ayemi-dev/pcb-ayemi/placas/enlace-esp32s3/reportes/colocacion.md

# Colocación

Generado por `tools/colocar.py` desde `spec/pcb.yaml`. No lo edites a mano.

Las piezas que más se movieron desde su posición aproximada (mm): R320 1.1, Q303 0.8, D201 0.7, C1 0.3, SW1 0.3, C201 0.3, SW2 0.2, R313 0.2.

## Choques de cortesía

Ninguno.

## Piezas fuera de la placa

Ninguna.

Conectores de borde cuya cortesía asoma (tolerado, máximo 0.6 mm): J101 0.49 mm, J401 0.15 mm, J402 0.15 mm, J403 0.15 mm, J404 0.15 mm, J405 0.15 mm, U1 0.05 mm.

## Reglas `cerca_de`

| Pieza | Pin | Distancia (mm) | Máximo (mm) | Resultado |
|---|---|---|---|---|
| C1 | U1.2 | 4.1 | 8 | ok |
| C2 | U1.2 | 6.0 | 8 | ok |
| C3 | U1.2 | 6.6 | 10 | ok |
| U102 | J101.A6 | 4.8 | 10 | ok |

## Zona de manos y USB-C

| Pieza | Distancia al centro del USB-C (mm) |
|---|---|
| SW301 | 45.2  |
| SW302 | 53.1  |
| RV301 | 58.5  |
| SW303 | 52.6  |

## Ocupación (suma de áreas de cortesía)

- Placa: 53 % de 5144 mm² útiles.
- Zona de manos (x [44, 84], y [10, 56]): 50 % de 1840 mm².
