ayemi-dev/pcb-ayemi/placas/enlace-esp32s3/reportes/erc.md

# Resultado del ERC

Generado por `tools/erc.py` con kicad-cli 10.0.6. No lo edites a mano.

| Concepto | Cantidad |
|---|---|
| Errores | 0 |
| Advertencias | 0 |
| Advertencias justificadas | 0 |
| Advertencias sin justificar | 0 |
| Excluidas en KiCad | 0 |

**Veredicto:** ERC en 0 errores y todas las advertencias justificadas.
