ayemi-dev/pcb-ayemi/placas/enlace-esp32s3/reportes/ruteo.md

# Ruteo

Generado por `tools/rutear.py` desde `spec/pcb.yaml`. No lo edites a mano.

- Pistas: 1166 tramos, 2785 mm en total. Vías: 216.
- Redes ruteadas en ventana fina (fijas): CC1, CC2, GND, USB_DM, USB_DP, VBUS.
- Redes con conexiones sin rutear: 0.
- Pasada elegida: 1. Tiempo: 0 s.
- Pads de GND sin vía al plano: ninguno.

## Por red

| Red | Clase | Ancho (mm) | Largo (mm) | Vías |
|---|---|---|---|---|
| +3V3 | Potencia | 0.25/0.50 | 229.2 | 5 |
| +5V | Potencia | 0.25/0.50 | 127.2 | 7 |
| BTN_A | Default | 0.25 | 34.9 | 6 |
| BTN_A_S | Default | 0.25 | 6.0 | 0 |
| BTN_B | Default | 0.25 | 32.5 | 4 |
| BTN_B_S | Default | 0.25 | 5.9 | 0 |
| BZ_C | Default | 0.25 | 50.5 | 3 |
| BZ_IN | Default | 0.25 | 6.3 | 2 |
| BZ_P | Default | 0.25 | 34.1 | 4 |
| BZ_S1 | Default | 0.25 | 6.2 | 2 |
| BZ_S2 | Default | 0.25 | 5.9 | 0 |
| BZ_S3 | Default | 0.25 | 5.9 | 0 |
| CC1 | Default | 0.20 | 7.4 | 2 |
| CC2 | Default | 0.20 | 7.3 | 2 |
| EN | Default | 0.25 | 59.0 | 5 |
| GND | Potencia | 0.20/0.25 | 114.1 | 54 |
| IO0 | Default | 0.25 | 11.6 | 2 |
| IO1 | Default | 0.25 | 81.7 | 8 |
| IO10 | Default | 0.25 | 84.3 | 2 |
| IO11 | Default | 0.25 | 82.3 | 2 |
| IO12 | Default | 0.25 | 84.3 | 4 |
| IO13 | Default | 0.25 | 88.3 | 4 |
| IO14 | Default | 0.25 | 93.1 | 2 |
| IO15 | Default | 0.25 | 70.5 | 3 |
| IO16 | Default | 0.25 | 69.2 | 2 |
| IO17 | Default | 0.25 | 66.8 | 2 |
| IO18 | Default | 0.25 | 96.0 | 8 |
| IO2 | Default | 0.25 | 90.9 | 2 |
| IO21 | Default | 0.25 | 41.2 | 2 |
| IO38 | Default | 0.25 | 39.1 | 2 |
| IO39 | Default | 0.25 | 36.2 | 2 |
| IO4 | Default | 0.25 | 61.5 | 2 |
| IO40 | Default | 0.25 | 35.8 | 2 |
| IO41 | Default | 0.25 | 34.7 | 2 |
| IO42 | Default | 0.25 | 35.7 | 2 |
| IO43 | Default | 0.25 | 51.4 | 2 |
| IO44 | Default | 0.25 | 48.6 | 2 |
| IO47 | Default | 0.25 | 33.9 | 1 |
| IO48 | Default | 0.25 | 32.3 | 1 |
| IO5 | Default | 0.25 | 47.2 | 4 |
| IO6 | Default | 0.25 | 56.6 | 6 |
| IO7 | Default | 0.25 | 49.4 | 6 |
| IO8 | Default | 0.25 | 64.2 | 5 |
| IO9 | Default | 0.25 | 50.5 | 5 |
| LED_G | Default | 0.25 | 42.2 | 2 |
| LED_G_A | Default | 0.25 | 4.1 | 0 |
| LED_R | Default | 0.25 | 50.0 | 6 |
| LED_R_A | Default | 0.25 | 4.1 | 0 |
| LED_Y | Default | 0.25 | 37.7 | 2 |
| LED_Y_A | Default | 0.25 | 4.1 | 0 |
| POT_W | Default | 0.25 | 2.5 | 0 |
| PWR_A | Default | 0.25 | 5.0 | 2 |
| Q_B | Default | 0.25 | 24.4 | 2 |
| RGB_B | Default | 0.25 | 40.5 | 5 |
| RGB_B_D | Default | 0.25 | 3.6 | 0 |
| RGB_B_K | Default | 0.25 | 3.8 | 2 |
| RGB_G | Default | 0.25 | 30.0 | 2 |
| RGB_G_D | Default | 0.25 | 3.6 | 0 |
| RGB_G_K | Default | 0.25 | 5.5 | 0 |
| RGB_R | Default | 0.25 | 31.0 | 2 |
| RGB_R_D | Default | 0.25 | 2.8 | 0 |
| RGB_R_K | Default | 0.25 | 6.1 | 0 |
| USB_DM | USB | 0.20 | 42.8 | 2 |
| USB_DP | USB | 0.20 | 46.0 | 2 |
| VBUS | Potencia | 0.40 | 24.9 | 4 |
