ayemi-dev/pcb-ayemi/placas/entrenamiento-328p/reportes/colocacion.md

# Colocación

Generado por `tools/colocar.py` desde `spec/pcb.yaml`. No lo edites a mano.

Las piezas que más se movieron desde su posición aproximada (mm): D201 0.3, Q302 0.1, U1 0.0, Y1 0.0, C1 0.0, C2 0.0, C3 0.0, C4 0.0.

## Choques de cortesía

Ninguno.

## Piezas fuera de la placa

Ninguna.

Conectores de borde cuya cortesía asoma (tolerado, máximo 0.6 mm): J101 0.49 mm, J401 0.15 mm, J402 0.15 mm, J403 0.15 mm, J404 0.15 mm, J405 0.15 mm.

## Reglas `cerca_de`

| Pieza | Pin | Distancia (mm) | Máximo (mm) | Resultado |
|---|---|---|---|---|
| C1 | U1.7 | 6.9 | 8 | ok |
| C101 | U101.16 | 3.3 | 4 | ok |
| C102 | U101.4 | 3.0 | 4 | ok |
| C2 | U1.8 | 6.4 | 8 | ok |
| C3 | U1.4 | 3.8 | 4 | ok |
| C4 | U1.6 | 3.9 | 4 | ok |
| C5 | U1.18 | 3.0 | 4 | ok |
| C6 | U1.20 | 2.9 | 4 | ok |
| U102 | J101.A6 | 4.8 | 10 | ok |
| Y1 | U1.7 | 7.4 | 8 | ok |

## Zona de manos y USB-C

| Pieza | Distancia al centro del USB-C (mm) |
|---|---|
| SW301 | 42.9  |
| SW302 | 51.8  |
| RV301 | 62.2  |
| SW303 | 52.2  |

## Ocupación (suma de áreas de cortesía)

- Placa: 46 % de 5144 mm² útiles.
- Zona de manos (x [40, 80], y [10, 56]): 43 % de 1840 mm².
