ayemi-dev/pcb-ayemi/placas/entrenamiento-328p/reportes/costura.md

# Costura de GND

Generado por `tools/costura.py` desde `spec/pcb.yaml`. No lo edites a mano.

- Puntos propuestos: 312 (rejilla de 5 mm y borde cada 3 mm).
- Vías de costura puestas: 236 (diámetro 0.6 mm, taladro 0.3 mm).
- Puntos sin sitio libre a 1.5 mm: 76.
- Zonas donde el DRC encontró vías sueltas (no se cose en 2.5 mm a la redonda): 8.

- (2.5, 2.5)
- (2.5, 27.5)
- (2.5, 32.5)
- (2.5, 37.5)
- (2.5, 42.5)
- (2.5, 47.5)
- (2.5, 57.5)
- (7.5, 22.5)
- (7.5, 37.5)
- (12.5, 37.5)
- (12.5, 42.5)
- (12.5, 52.5)
- (17.5, 7.5)
- (17.5, 27.5)
- (17.5, 32.5)
- (17.5, 37.5)
- (17.5, 42.5)
- (17.5, 52.5)
- (22.5, 37.5)
- (22.5, 42.5)
- (27.5, 27.5)
- (27.5, 32.5)
- (27.5, 57.5)
- (32.5, 7.5)
- (32.5, 27.5)
- (32.5, 37.5)
- (32.5, 47.5)
- (37.5, 22.5)
- (37.5, 47.5)
- (42.5, 7.5)
- (42.5, 32.5)
- (42.5, 42.5)
- (47.5, 7.5)
- (47.5, 17.5)
- (47.5, 37.5)
- (47.5, 42.5)
- (52.5, 42.5)
- (52.5, 52.5)
- (57.5, 7.5)
- (57.5, 42.5)
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
