ayemi-dev/pcb-ayemi/placas/entrenamiento-328p/reportes/ruteo.md

# Ruteo

Generado por `tools/rutear.py` desde `spec/pcb.yaml`. No lo edites a mano.

- Pistas: 1262 tramos, 2986 mm en total. Vías: 200.
- Redes ruteadas en ventana fina (fijas): CC1, CC2, GND, USB_DM, USB_DP, VBUS.
- Redes con conexiones sin rutear: 0.
- Pasada elegida: 1. Tiempo: 0 s.
- Pads de GND sin vía al plano: ninguno.

## Anchos distintos del de su clase

- +5V: tramo hacia J1.2 con ancho 0.20 mm (clase Fino) en lugar de 0.25 mm

## Por red

| Red | Clase | Ancho (mm) | Largo (mm) | Vías |
|---|---|---|---|---|
| +3V3 | Potencia | 0.25/0.50 | 63.3 | 5 |
| +5V | Potencia | 0.25/0.50 | 348.2 | 19 |
| A0 | Default | 0.25 | 59.6 | 3 |
| A1 | Default | 0.25 | 59.7 | 3 |
| A2 | Default | 0.25 | 66.9 | 2 |
| A3 | Default | 0.25 | 69.9 | 2 |
| A4 | Default | 0.25 | 105.9 | 6 |
| A5 | Default | 0.25 | 99.8 | 3 |
| A6 | Default | 0.25 | 51.2 | 2 |
| A7 | Default | 0.25 | 75.4 | 6 |
| AREF | Default | 0.25 | 4.1 | 0 |
| BTN_A | Default | 0.25 | 14.9 | 2 |
| BTN_A_S | Default | 0.25 | 6.7 | 0 |
| BTN_B | Default | 0.25 | 13.9 | 2 |
| BTN_B_S | Default | 0.25 | 6.1 | 0 |
| BZ_C | Default | 0.25 | 47.0 | 4 |
| BZ_IN | Default | 0.25 | 12.0 | 2 |
| BZ_P | Default | 0.25 | 53.3 | 6 |
| BZ_S1 | Default | 0.25 | 6.2 | 2 |
| BZ_S2 | Default | 0.25 | 6.6 | 0 |
| BZ_S3 | Default | 0.25 | 7.3 | 0 |
| CC1 | Default | 0.20 | 9.3 | 2 |
| CC2 | Default | 0.20 | 9.1 | 2 |
| CH_RXD | Default | 0.25 | 11.3 | 2 |
| CH_TXD | Default | 0.25 | 16.2 | 2 |
| D0 | Default | 0.25 | 75.8 | 0 |
| D1 | Default | 0.25 | 82.8 | 4 |
| D10 | Default | 0.25 | 62.6 | 1 |
| D11 | Default | 0.25 | 65.2 | 1 |
| D12 | Default | 0.25 | 64.6 | 1 |
| D13 | Default | 0.25 | 94.9 | 1 |
| D2 | Default | 0.25 | 77.6 | 3 |
| D3 | Default | 0.25 | 76.9 | 4 |
| D4 | Default | 0.25 | 129.2 | 4 |
| D5 | Default | 0.25 | 86.4 | 6 |
| D6 | Default | 0.25 | 83.3 | 7 |
| D7 | Default | 0.25 | 90.5 | 6 |
| D8 | Default | 0.25 | 99.3 | 3 |
| D9 | Default | 0.25 | 93.3 | 4 |
| DTR | Default | 0.25 | 11.4 | 2 |
| GND | Potencia | 0.20/0.25 | 79.2 | 44 |
| LED_G | Default | 0.25 | 39.2 | 4 |
| LED_G_A | Default | 0.25 | 3.0 | 0 |
| LED_L_A | Default | 0.25 | 3.0 | 0 |
| LED_R | Default | 0.25 | 49.2 | 4 |
| LED_R_A | Default | 0.25 | 3.0 | 0 |
| POT_W | Default | 0.25 | 3.9 | 1 |
| PWR_A | Default | 0.25 | 4.0 | 0 |
| Q_B | Default | 0.25 | 12.3 | 0 |
| RESET | Default | 0.25 | 148.5 | 12 |
| RGB_B | Default | 0.25 | 30.0 | 2 |
| RGB_B_A | Default | 0.25 | 5.1 | 0 |
| RGB_G | Default | 0.25 | 35.1 | 2 |
| RGB_G_A | Default | 0.25 | 5.7 | 0 |
| RGB_R | Default | 0.25 | 40.9 | 2 |
| RGB_R_A | Default | 0.25 | 5.9 | 0 |
| RX_A | Default | 0.25 | 4.3 | 2 |
| TX_A | Default | 0.25 | 4.1 | 0 |
| USB_DM | USB | 0.20 | 20.3 | 0 |
| USB_DP | USB | 0.20 | 22.4 | 0 |
| V3 | Default | 0.25 | 6.3 | 0 |
| VBUS | Potencia | 0.40 | 21.6 | 3 |
| XT1 | Default | 0.25 | 11.9 | 0 |
| XT2 | Default | 0.25 | 9.4 | 0 |
