ayemi-dev/pcb-ayemi/placas/impulso-stm32/reportes/colocacion.md

# Colocación

Generado por `tools/colocar.py` desde `spec/pcb.yaml`. No lo edites a mano.

Las piezas que más se movieron desde su posición aproximada (mm): SW2 3.8, D305 3.3, R403 3.2, R404 2.4, C1 1.8, C2 1.8, R307 1.7, R405 1.6.

## Choques de cortesía

Ninguno.

## Piezas fuera de la placa

Ninguna.

Conectores de borde cuya cortesía asoma (tolerado, máximo 0.6 mm): J101 0.50 mm, J401 0.15 mm, J402 0.15 mm, J403 0.15 mm, J404 0.15 mm, J405 0.15 mm.

## Reglas `cerca_de`

| Pieza | Pin | Distancia (mm) | Máximo (mm) | Resultado |
|---|---|---|---|---|
| C1 | U1.5 | 8.6 | 14 | ok |
| C2 | U1.6 | 12.2 | 14 | ok |
| C3 | U1.24 | 3.5 | 6 | ok |
| C4 | U1.36 | 3.6 | 6 | ok |
| C5 | U1.48 | 3.7 | 6 | ok |
| C8 | U1.22 | 5.0 | 8 | ok |
| U102 | J101.A6 | 4.8 | 10 | ok |

## Zona de manos y USB-C

| Pieza | Distancia al centro del USB-C (mm) |
|---|---|
| SW301 | 49.8  |
| SW302 | 58.7  |
| RV301 | 63.5  |
| SW303 | 69.1  |

## Ocupación (suma de áreas de cortesía)

- Placa: 41 % de 6744 mm² útiles.
- Zona de manos (x [44, 84], y [10, 56]): 39 % de 1840 mm².
