ayemi-dev/pcb-ayemi/placas/impulso-stm32/reportes/costura.md

# Costura de GND

Generado por `tools/costura.py` desde `spec/pcb.yaml`. No lo edites a mano.

- Puntos propuestos: 388 (rejilla de 5 mm y borde cada 3 mm).
- Vías de costura puestas: 328 (diámetro 0.5 mm, taladro 0.3 mm).
- Puntos sin sitio libre a 1.5 mm: 60.
- Zonas donde el DRC encontró vías sueltas (no se cose en 2.5 mm a la redonda): 58.

- (2.5, 2.5)
- (2.5, 67.5)
- (12.5, 62.5)
- (17.5, 7.5)
- (17.5, 57.5)
- (17.5, 62.5)
- (22.5, 27.5)
- (22.5, 32.5)
- (27.5, 27.5)
- (32.5, 7.5)
- (32.5, 27.5)
- (32.5, 52.5)
- (42.5, 7.5)
- (42.5, 32.5)
- (42.5, 37.5)
- (47.5, 7.5)
- (47.5, 32.5)
- (47.5, 37.5)
- (52.5, 32.5)
- (52.5, 37.5)
- (52.5, 42.5)
- (52.5, 47.5)
- (57.5, 7.5)
- (57.5, 27.5)
- (57.5, 37.5)
- (57.5, 42.5)
- (57.5, 47.5)
- (57.5, 52.5)
- (62.5, 17.5)
- (62.5, 37.5)
- (62.5, 42.5)
- (62.5, 47.5)
- (62.5, 57.5)
- (67.5, 37.5)
- (67.5, 47.5)
- (67.5, 52.5)
- (67.5, 62.5)
- (72.5, 7.5)
- (72.5, 37.5)
- (72.5, 42.5)
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
