ayemi-dev/pcb-ayemi/placas/impulso-stm32/reportes/ruteo.md

# Ruteo

Generado por `tools/rutear.py` desde `spec/pcb.yaml`. No lo edites a mano.

- Pistas: 1384 tramos, 2915 mm en total. Vías: 222.
- Redes ruteadas en ventana fina (fijas): CC1, CC2, GND, USB_DM, USB_DP, VBUS.
- Redes con conexiones sin rutear: 0.
- Pasada elegida: 8. Tiempo: 0 s.
- Pads de GND sin vía al plano: ninguno.

## Anchos distintos del de su clase

- XT2: tramo hacia U1.6 con ancho 0.15 mm (clase Fino) en lugar de 0.25 mm
- PB9: tramo hacia U1.46 con ancho 0.15 mm (clase Fino) en lugar de 0.25 mm
- PB1: tramo hacia U1.19 con ancho 0.15 mm (clase Fino) en lugar de 0.25 mm
- PB10: tramo hacia U1.21 con ancho 0.15 mm (clase Fino) en lugar de 0.25 mm
- PB4: tramo hacia U1.40 con ancho 0.15 mm (clase Fino) en lugar de 0.25 mm
- SD_SCK: tramo hacia J411.5 con ancho 0.15 mm (clase Fino) en lugar de 0.25 mm
- BOOT0: tramo hacia U1.44 con ancho 0.15 mm (clase Fino) en lugar de 0.25 mm
- PA0: tramo hacia U1.10 con ancho 0.15 mm (clase Fino) en lugar de 0.25 mm
- SD_CD: tramo hacia U1.2 con ancho 0.15 mm (clase Fino) en lugar de 0.25 mm
- SWDIO: tramo hacia U1.34 con ancho 0.15 mm (clase Fino) en lugar de 0.25 mm
- PA6: tramo hacia U1.16 con ancho 0.15 mm (clase Fino) en lugar de 0.25 mm
- SD_MISO: tramo hacia J411.7 con ancho 0.15 mm (clase Fino) en lugar de 0.25 mm
- PA1: tramo hacia U1.11 con ancho 0.15 mm (clase Fino) en lugar de 0.25 mm
- +3V3: tramo hacia U1.9 con ancho 0.15 mm (clase Fino) en lugar de 0.25 mm
- +3V3: tramo hacia U301.5 con ancho 0.15 mm (clase Fino) en lugar de 0.25 mm
- +3V3: tramo hacia U301.12 con ancho 0.15 mm (clase Fino) en lugar de 0.25 mm
- SD_SCK: tramo hacia J411.5 con ancho 0.15 mm (clase Fino) en lugar de 0.25 mm
- +3V3: tramo hacia U1.9 con ancho 0.15 mm (clase Fino) en lugar de 0.25 mm
- +3V3: tramo hacia U301.5 con ancho 0.15 mm (clase Fino) en lugar de 0.25 mm
- +3V3: tramo hacia U301.12 con ancho 0.15 mm (clase Fino) en lugar de 0.25 mm
- SD_SCK: tramo hacia J411.5 con ancho 0.15 mm (clase Fino) en lugar de 0.25 mm
- SD_MISO: tramo hacia J411.7 con ancho 0.15 mm (clase Fino) en lugar de 0.25 mm
- SD_CD: tramo hacia U1.2 con ancho 0.15 mm (clase Fino) en lugar de 0.25 mm
- SWDIO: tramo hacia U1.34 con ancho 0.15 mm (clase Fino) en lugar de 0.25 mm
- PB10: tramo hacia U1.21 con ancho 0.15 mm (clase Fino) en lugar de 0.25 mm
- PB1: tramo hacia U1.19 con ancho 0.15 mm (clase Fino) en lugar de 0.25 mm
- PA1: tramo hacia U1.11 con ancho 0.15 mm (clase Fino) en lugar de 0.25 mm
- PB9: tramo hacia U1.46 con ancho 0.15 mm (clase Fino) en lugar de 0.25 mm
- PA6: tramo hacia U1.16 con ancho 0.15 mm (clase Fino) en lugar de 0.25 mm
- PB4: tramo hacia U1.40 con ancho 0.15 mm (clase Fino) en lugar de 0.25 mm
- BOOT0: tramo hacia U1.44 con ancho 0.15 mm (clase Fino) en lugar de 0.25 mm
- XT2: tramo hacia U1.6 con ancho 0.15 mm (clase Fino) en lugar de 0.25 mm

## Por red

| Red | Clase | Ancho (mm) | Largo (mm) | Vías |
|---|---|---|---|---|
| +3V3 | Default | 0.15/0.25 | 377.8 | 30 |
| +5V | Potencia | 0.25/0.50 | 169.1 | 8 |
| BOOT0 | Default | 0.15/0.25 | 15.4 | 2 |
| BTN_A | Default | 0.25 | 54.0 | 4 |
| BTN_A_S | Default | 0.25 | 7.8 | 0 |
| BTN_B | Default | 0.25 | 28.7 | 4 |
| BTN_B_S | Default | 0.25 | 6.0 | 0 |
| BZ_C | Default | 0.25 | 41.6 | 2 |
| BZ_IN | Default | 0.25 | 29.1 | 2 |
| BZ_P | Default | 0.25 | 31.1 | 0 |
| BZ_S1 | Default | 0.25 | 6.4 | 0 |
| BZ_S2 | Default | 0.25 | 6.9 | 0 |
| BZ_S3 | Default | 0.25 | 6.9 | 0 |
| CC1 | Default | 0.20 | 7.3 | 0 |
| CC2 | Default | 0.20 | 7.1 | 2 |
| GND | Potencia | 0.20/0.25 | 101.3 | 63 |
| IMU_SA0 | Default | 0.25 | 4.8 | 0 |
| LED_G | Default | 0.25 | 24.3 | 0 |
| LED_G_A | Default | 0.25 | 4.0 | 0 |
| LED_R | Default | 0.25 | 30.9 | 0 |
| LED_R_A | Default | 0.25 | 4.0 | 0 |
| LED_Y | Default | 0.25 | 21.5 | 0 |
| LED_Y_A | Default | 0.25 | 4.0 | 0 |
| NRST | Default | 0.25 | 87.5 | 2 |
| PA0 | Default | 0.15 | 42.4 | 6 |
| PA1 | Default | 0.15/0.25 | 55.8 | 2 |
| PA10 | Default | 0.25 | 4.5 | 0 |
| PA15 | Default | 0.25 | 59.8 | 4 |
| PA2 | Default | 0.25 | 30.3 | 2 |
| PA3 | Default | 0.15/0.25 | 31.5 | 2 |
| PA4 | Default | 0.25 | 35.4 | 2 |
| PA5 | Default | 0.15/0.25 | 31.8 | 2 |
| PA6 | Default | 0.15 | 42.0 | 4 |
| PA7 | Default | 0.15/0.25 | 53.1 | 4 |
| PB0 | Default | 0.25 | 64.4 | 0 |
| PB1 | Default | 0.15/0.25 | 66.5 | 2 |
| PB10 | Default | 0.15/0.25 | 65.4 | 3 |
| PB2 | Default | 0.25 | 8.8 | 2 |
| PB3 | Default | 0.15/0.25 | 32.4 | 1 |
| PB4 | Default | 0.15 | 28.8 | 0 |
| PB5 | Default | 0.25 | 71.2 | 4 |
| PB6 | Default | 0.15/0.25 | 69.5 | 6 |
| PB7 | Default | 0.15/0.25 | 72.2 | 2 |
| PB8 | Default | 0.25 | 59.0 | 0 |
| PB9 | Default | 0.15/0.25 | 55.9 | 2 |
| PC14 | Default | 0.15/0.25 | 53.1 | 4 |
| PC15 | Default | 0.15/0.25 | 51.4 | 2 |
| POT_W | Default | 0.25 | 8.4 | 1 |
| PWR_A | Default | 0.25 | 4.4 | 2 |
| Q_B | Default | 0.25 | 8.7 | 0 |
| RGB_B | Default | 0.25 | 11.3 | 2 |
| RGB_B_D | Default | 0.25 | 4.9 | 2 |
| RGB_B_K | Default | 0.25 | 3.8 | 0 |
| RGB_G | Default | 0.25 | 13.4 | 0 |
| RGB_G_D | Default | 0.25 | 3.6 | 0 |
| RGB_G_K | Default | 0.25 | 5.5 | 2 |
| RGB_R | Default | 0.25 | 15.2 | 0 |
| RGB_R_D | Default | 0.25 | 3.6 | 0 |
| RGB_R_K | Default | 0.25 | 6.0 | 0 |
| SD_CD | Default | 0.15/0.25 | 59.6 | 5 |
| SD_CS | Default | 0.25 | 80.2 | 5 |
| SD_DAT1 | Default | 0.25 | 4.2 | 0 |
| SD_DAT2 | Default | 0.25 | 8.1 | 2 |
| SD_MISO | Default | 0.15/0.25 | 69.0 | 5 |
| SD_MOSI | Default | 0.25 | 72.4 | 7 |
| SD_SCK | Default | 0.15/0.25 | 69.6 | 6 |
| SWCLK | Default | 0.25 | 63.9 | 2 |
| SWDIO | Default | 0.15 | 65.5 | 2 |
| USB_DM | USB | 0.20 | 49.5 | 0 |
| USB_DP | USB | 0.20 | 51.4 | 2 |
| VBUS | Potencia | 0.40 | 36.9 | 2 |
| VCAP | Default | 0.25 | 5.0 | 0 |
| XT1 | Default | 0.25 | 11.7 | 0 |
| XT2 | Default | 0.15/0.25 | 15.9 | 0 |
