ayemi-dev/pcb-ayemi/placas/impulso-stm32/reportes/serigrafia.md

# Serigrafía

Generado por `tools/serigrafia.py` desde `spec/pcb.yaml`. No lo edites a mano.

- Textos: 92 (cara superior 67, inferior 25).
- Logotipo: 6 formas, 9.5 x 3.1 mm, proporción original.
- Alto mínimo de letra usado: 1.0 mm; trazo 0.15 mm.
- Emi (emi-serigrafia-cabeza.svg): 5 formas, 7.5 x 7.0 mm, proporción original.
- QR (qr.svg): 197 rectángulos, lado de 14 mm, en espejo en la cara inferior.
