ayemi-dev/pcb-ayemi/LICENSES/LEEME.md

# Licencias

Los tres textos están descargados sin cambios de sus fuentes oficiales el 2026-11-02. Aplican a todas las placas del repositorio.

| Qué cubre | Licencia | Archivo | Fuente oficial |
|---|---|---|---|
| Hardware: esquemáticos, placa, Gerber, BOM, CPL, modelos 3D | CERN-OHL-S-2.0 | `CERN-OHL-S-2.0.txt` | https://ohwr.org/cern_ohl_s_v2.txt (redirige a gitlab.com/ohwr/project/cernohl) |
| Firmware y ejemplos | MIT | `MIT.txt` | https://spdx.org/licenses/MIT.txt |
| Documentación, guías y reportes | CC BY-SA 4.0 | `CC-BY-SA-4.0.txt` | https://creativecommons.org/licenses/by-sa/4.0/legalcode.txt |

`MIT.txt` es la plantilla oficial, con `<year>` y `<copyright holders>` sin llenar. El firmware de cada placa lleva su aviso de derechos (`Copyright (c) 2026 Ayemi`) en su propio archivo `LICENSE`, con el texto completo de la plantilla.

El nombre y el logotipo **Ayemi** no entran en ninguna de estas licencias: quedan reservados.
