ayemi-dev/pcb-ayemi/placas/entrenamiento-328p/reportes/piezas_respuesta.md

# Respuesta de la consulta de piezas · tarea 2.1

Fecha de consulta: 2026-10-28

Consulta hecha por Kiro con `tools/consultar_jlc.py` (el servicio de búsqueda de `jlcpcb.com/parts`). Solo están las
piezas resueltas. Las pendientes, con el motivo, están en `piezas.md`. El formato de cada línea está en
`piezas_a_consultar.md`. Cuando JLCPCB no trae hoja de datos, el enlace es la página de la pieza.

## Pasivos (Basic)

R307, R308 · C23138 · UNI-ROYAL 0603WAF3300T5E (330 Ω) · Basic · 3586976 · 0603 · https://www.lcsc.com/datasheet/lcsc_datasheet_2206010116_UNI-ROYAL-Uniroyal-Elec-0603WAF3300T5E_C23138.pdf · C105881
R302, R306 · C23193 · UNI-ROYAL 0603WAF5100T5E (510 Ω) · Basic · 4103258 · 0603 · https://www.lcsc.com/datasheet/lcsc_datasheet_2206010116_UNI-ROYAL-Uniroyal-Elec-0603WAF5100T5E_C23193.pdf · C114670
R305 · C23204 · UNI-ROYAL 0603WAF5600T5E (560 Ω) · Basic · 2636620 · 0603 · https://www.lcsc.com/datasheet/lcsc_datasheet_2206010116_UNI-ROYAL-Uniroyal-Elec-0603WAF5600T5E_C23204.pdf · C114629
R303, R304 · C23228 · UNI-ROYAL 0603WAF6800T5E (680 Ω) · Basic · 1941548 · 0603 · https://www.lcsc.com/datasheet/lcsc_datasheet_2206010100_UNI-ROYAL-Uniroyal-Elec-0603WAF6800T5E_C23228.pdf · C112310
R301, R103, R104, R313, R309 · C21190 · UNI-ROYAL 0603WAF1001T5E (1 kΩ) · Basic · 32875352 · 0603 · https://www.lcsc.com/datasheet/lcsc_datasheet_2206010130_UNI-ROYAL-Uniroyal-Elec-0603WAF1001T5E_C21190.pdf · C22548
R105, R106, R201 · C22843 · UNI-ROYAL 0603WAF1501T5E (1.5 kΩ) · Basic · 3735426 · 0603 · https://www.lcsc.com/datasheet/lcsc_datasheet_2206010130_UNI-ROYAL-Uniroyal-Elec-0603WAF1501T5E_C22843.pdf · C114668
R311, R314, R315, R316 · C22859 · UNI-ROYAL 0603WAF100JT5E (10 Ω, serie del zumbador) · Basic · 6410348 · 0603 · https://www.lcsc.com/product-detail/C22859.html · C109318
R401, R402 · C23162 · UNI-ROYAL 0603WAF4701T5E (4.7 kΩ) · Basic · 16245239 · 0603 · https://www.lcsc.com/datasheet/lcsc_datasheet_2206010116_UNI-ROYAL-Uniroyal-Elec-0603WAF4701T5E_C23162.pdf · C99782
R1, R310, R312 · C25804 · UNI-ROYAL 0603WAF1002T5E (10 kΩ) · Basic · 38068979 · 0603 · https://www.lcsc.com/datasheet/lcsc_datasheet_2206010045_UNI-ROYAL-Uniroyal-Elec-0603WAF1002T5E_C25804.pdf · C98220
R101, R102 · C23186 · UNI-ROYAL 0603WAF5101T5E (5.1 kΩ 1 %) · Basic · 21559093 · 0603 · https://www.lcsc.com/datasheet/lcsc_datasheet_2206010116_UNI-ROYAL-Uniroyal-Elec-0603WAF5101T5E_C23186.pdf · C105580
C3, C4, C5, C6, C101, C102, C103 · C14663 · YAGEO CC0603KRX7R9BB104 (100 nF 50 V X7R) · Basic · 39960097 · 0603 · https://www.lcsc.com/datasheet/lcsc_datasheet_2211101700_YAGEO-CC0603KRX7R9BB104_C14663.pdf · C91183
C202, C203 · C15849 · Samsung CL10A105KB8NNNC (1 µF 50 V X5R) · Basic · 12814092 · 0603 · https://www.lcsc.com/datasheet/lcsc_datasheet_2304140030_Samsung-Electro-Mechanics-CL10A105KB8NNNC_C15849.pdf · C106214
C201 · C19702 · Samsung CL10A106KP8NNNC (10 µF 10 V X5R) · Basic · 12382301 · 0603 · https://www.lcsc.com/datasheet/lcsc_datasheet_2304140030_Samsung-Electro-Mechanics-CL10A106KP8NNNC_C19702.pdf · C380314
C1, C2 · C1653 · Samsung CL10C220JB8NNNC (22 pF 50 V C0G) · Basic · 2055269 · 0603 · https://www.lcsc.com/datasheet/lcsc_datasheet_2304140030_Samsung-Electro-Mechanics-CL10C220JB8NNNC_C1653.pdf · C7419421

## Diodos, transistor y LEDs

D1, D305 · C81598 · Semtech 1N4148W · Basic · 3902523 · SOD-123 · https://www.lcsc.com/datasheet/lcsc_datasheet_1811061725_ST-Semtech-1N4148W_C81598.pdf · C2099
Q301 · C2146 · Changjing S8050 J3Y (hFE 200-350) · Basic · 1463660 · SOT-23 · https://www.lcsc.com/datasheet/lcsc_datasheet_2310131500_Jiangsu-Changjing-Electronics-Technology-Co---Ltd--S8050-J3Y-RANGE-200-350_C2146.pdf · C105433
D301, D101, D102 · C2286 · KENTO KT-0603R (rojo) · Basic · 7481911 · 0603 · https://www.lcsc.com/datasheet/lcsc_datasheet_1810231112_Hubei-KENTO-Elec-KT-0603R_C2286.pdf · C84263
D302 · C12624 · KENTO KT-0603G (verde esmeralda 3.1 V) · Extended · 415293 · 0603 · https://www.lcsc.com/datasheet/lcsc_datasheet_1806151818_Hubei-KENTO-Elec-KT-0603G_C12624.pdf · C84267
D303 · C2287 · KENTO KT-0603Y (amarillo) · Extended · 118926 · 0603 · https://www.lcsc.com/product-detail/C2287.html · C84268
D201 · C2288 · KENTO KT-0603B (azul 3.1 V) · Extended · 157629 · 0603 · https://www.lcsc.com/datasheet/lcsc_datasheet_1810220913_Hubei-KENTO-Elec-KT-0603B_C2288.pdf · C84266

## Circuitos integrados y alimentación

U1 · C14877 · Microchip ATMEGA328P-AU · Extended · 40486 · TQFP-32(7x7) · https://www.lcsc.com/datasheet/lcsc_datasheet_2410010303_Microchip-Tech-ATMEGA328P-AU_C14877.pdf · C618816
U101 · C84681 · WCH CH340C · Extended · 110537 · SOP-16 · https://www.lcsc.com/datasheet/lcsc_datasheet_2406191656_WCH-Jiangsu-Qin-Heng-CH340C_C84681.pdf · C7464026
U102 · C7519 · STMicroelectronics USBLC6-2SC6 · Extended · 42167 · SOT-23-6L · https://www.lcsc.com/datasheet/lcsc_datasheet_2410121836_STMicroelectronics-USBLC6-2SC6_C7519.pdf · C2687116
U201 · C51118 · Diodes AP2112K-3.3TRG1 · Extended · 5438 · SOT-25-5 · https://www.lcsc.com/datasheet/lcsc_datasheet_2304140030_Diodes-Incorporated-AP2112K-3-3TRG1_C51118.pdf · C82942
F201 · C163512 · Littelfuse 1206L050YR · Extended · 11798 · 1206 · https://www.lcsc.com/datasheet/lcsc_datasheet_2304140030_Littelfuse-1206L050YR_C163512.pdf · C49318356
Y1 · C70562 · YXC X322516MRB4SI (16 MHz 18 pF) · Extended · 21146 · SMD3225-4P · https://www.lcsc.com/datasheet/lcsc_datasheet_2403291504_YXC-Crystal-Oscillators-X322516MRB4SI_C70562.pdf · C362471
J101 · C165948 · HRO TYPE-C-31-M-12 · Extended · 294126 · SMD (16P) · https://www.lcsc.com/datasheet/lcsc_datasheet_2205251630_Korean-Hroparts-Elec-TYPE-C-31-M-12_C165948.pdf · C5337088

## Periféricos y conectores

D304 · C3647023 · XINGLIGHT XL-A3528RGBC-BM (RGB cátodo común 3528) · Extended · 5004 · SMD3528-4P · https://wmsc.lcsc.com/wmsc/upload/file/pdf/v2/lcsc/2207041845_XINGLIGHT-XL-A3528RGBC-BM_C3647023.pdf · C601684
SW303 · C6709493 · SHOU HAN 2.54-8P TPPT (DIP de 8, SMD) · Extended · 6356 · SMD P=2.54mm · https://wmsc.lcsc.com/wmsc/upload/file/pdf/v2/lcsc/2405291211_SHOU-HAN-2-54-8P-TPPT_C6709493.pdf · C7502790
SW301, SW302, SW1 · C319409 · HYP (Hongyuan Precision) 1TS009A-1800-5000-CT (6x6x5 mm) · Extended · 33131 · SMD 6x6mm · https://www.lcsc.com/datasheet/lcsc_datasheet_1811151231_HYP--Hongyuan-Precision-1TS009A-1800-5000-CT_C319409.pdf · C255813
BZ301 · C7421674 · Fengming YS-SBZ8530C05R30 (electromagnético pasivo 5 V) · Extended · 564 · SMD 8.5x8.5mm · https://wmsc.lcsc.com/wmsc/upload/file/pdf/v2/lcsc/2306141737_Fengming-YS-SBZ8530C05R30_C7421674.pdf · C530411
Q302 · C94098 · Vishay TEMT6000X01 (luz ambiental) · Extended · 6505 · 1206 · https://www.lcsc.com/datasheet/lcsc_datasheet_2410121820_Vishay-Intertech-TEMT6000X01_C94098.pdf · C47416518
RV301 · C202373 · ALPS RK09K1130AAU (10 kΩ) · Extended · 6026 · THT · https://www.lcsc.com/datasheet/lcsc_datasheet_1810170725_ALPSALPINE-RK09K1130AAU_C202373.pdf · C351173
J401, J402, J403, J404, J405 · C265102 · JST S4B-PH-SM4-TB(LF)(SN) · Extended · 18269 · SMD P=2mm horizontal · https://www.lcsc.com/datasheet/lcsc_datasheet_2304140030_JST-S4B-PH-SM4-TB-LF-SN_C265102.pdf · C7429571
J1 · C65114 · BOOMELE 2.54-2*3PPin (2x3) · Extended · 38594 · THT P=2.54mm · https://www.lcsc.com/product-detail/C65114.html · C53055678
J407 · C22465875 · XFCN PZ254V-11-15P (1x15) · Extended · 1486 · THT P=2.54mm · https://www.lcsc.com/datasheet/lcsc_datasheet_2409300902_XFCN-PZ254V-11-15P_C22465875.pdf · C2932704
J408 · C2840012 · XFCN PZ254V-11-12P (1x12) · Extended · 31618 · THT P=2.54mm · https://wmsc.lcsc.com/wmsc/upload/file/pdf/v2/lcsc/2304140030_XFCN-PZ254V-11-12P_C2840012.pdf · C54803345
J406 · C492405 · XFCN PZ254V-11-06P (1x6) · Extended · 71289 · THT P=2.54mm · https://www.lcsc.com/datasheet/lcsc_datasheet_2003191006_XFCN-PZ254V-11-06P_C492405.pdf · C42431790
