ayemi-dev/pcb-ayemi/placas/enlace-esp32s3/docs/renders/inferior.png

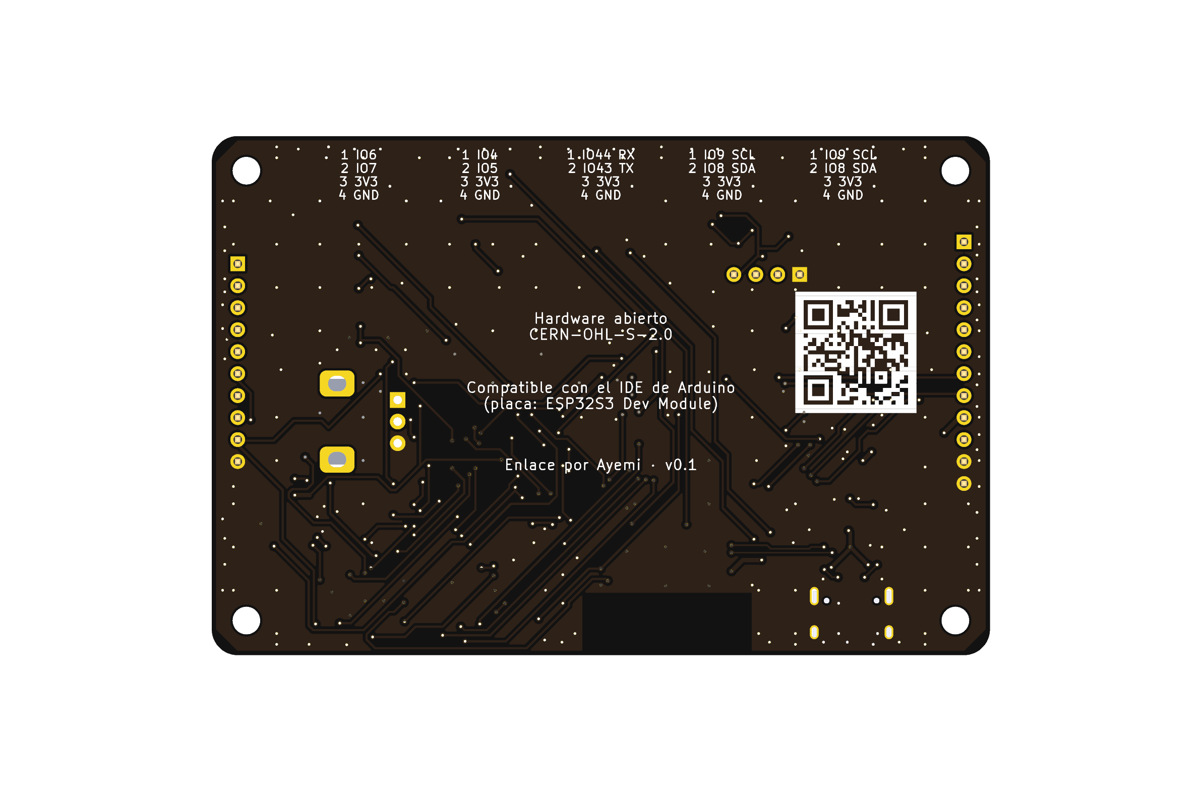
placas/enlace-esp32s3/docs/renders/inferior.png
