ayemi-dev/pcb-ayemi/placas/enlace-esp32s3/docs/renders/isometrico.png

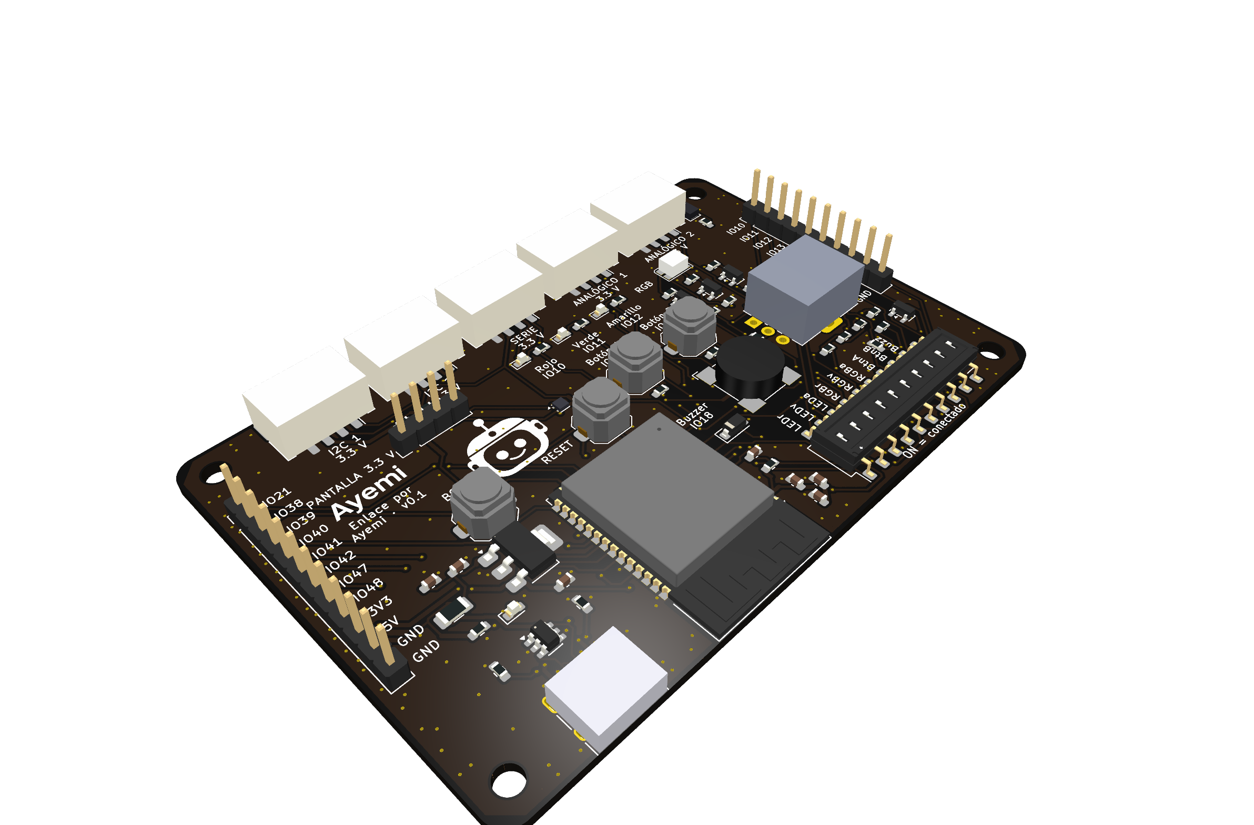
placas/enlace-esp32s3/docs/renders/isometrico.png
