ayemi-dev/pcb-ayemi/placas/enlace-esp32s3/docs/renders/portada.png

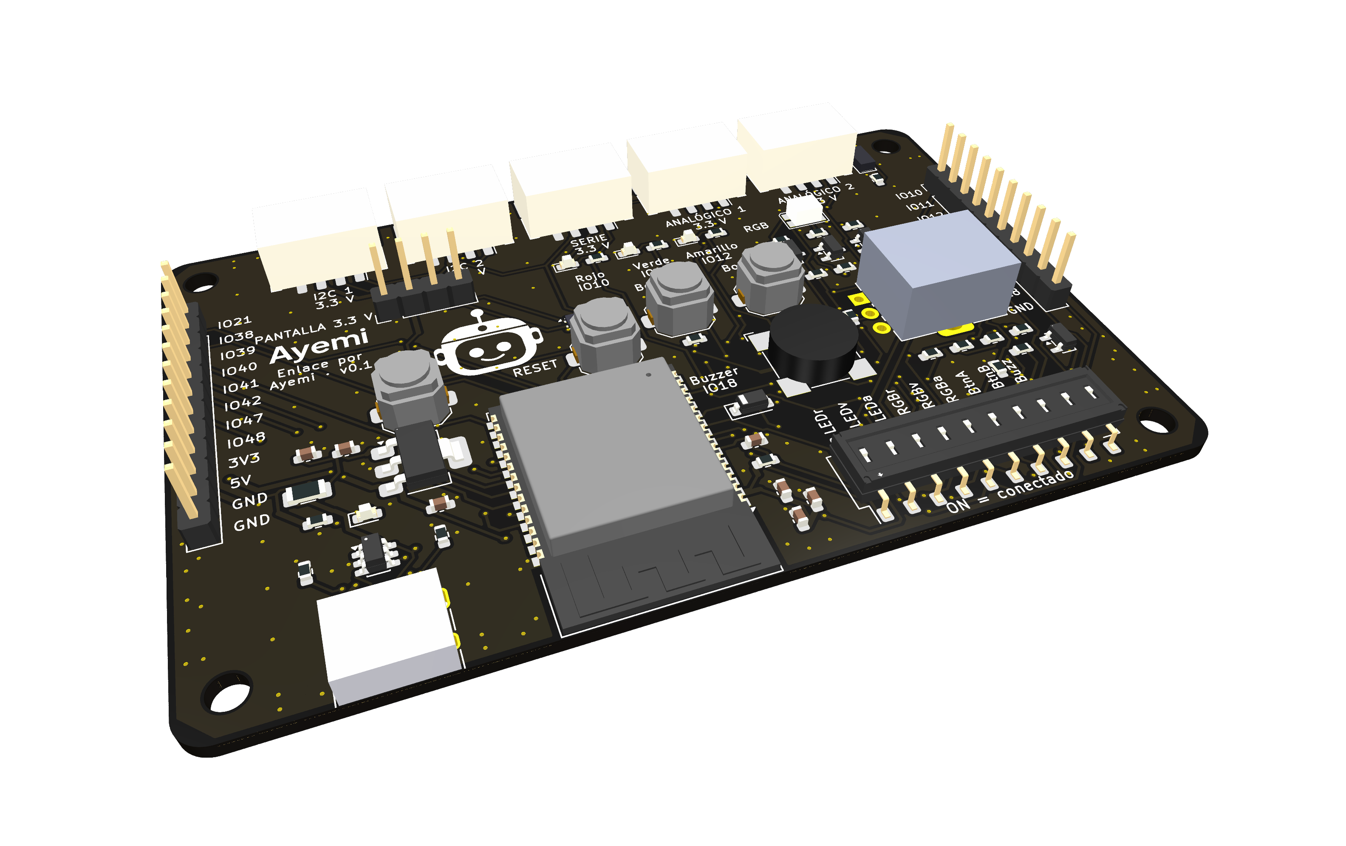
placas/enlace-esp32s3/docs/renders/portada.png
