ayemi-dev/pcb-ayemi/placas/enlace-esp32s3/docs/renders/superior.png

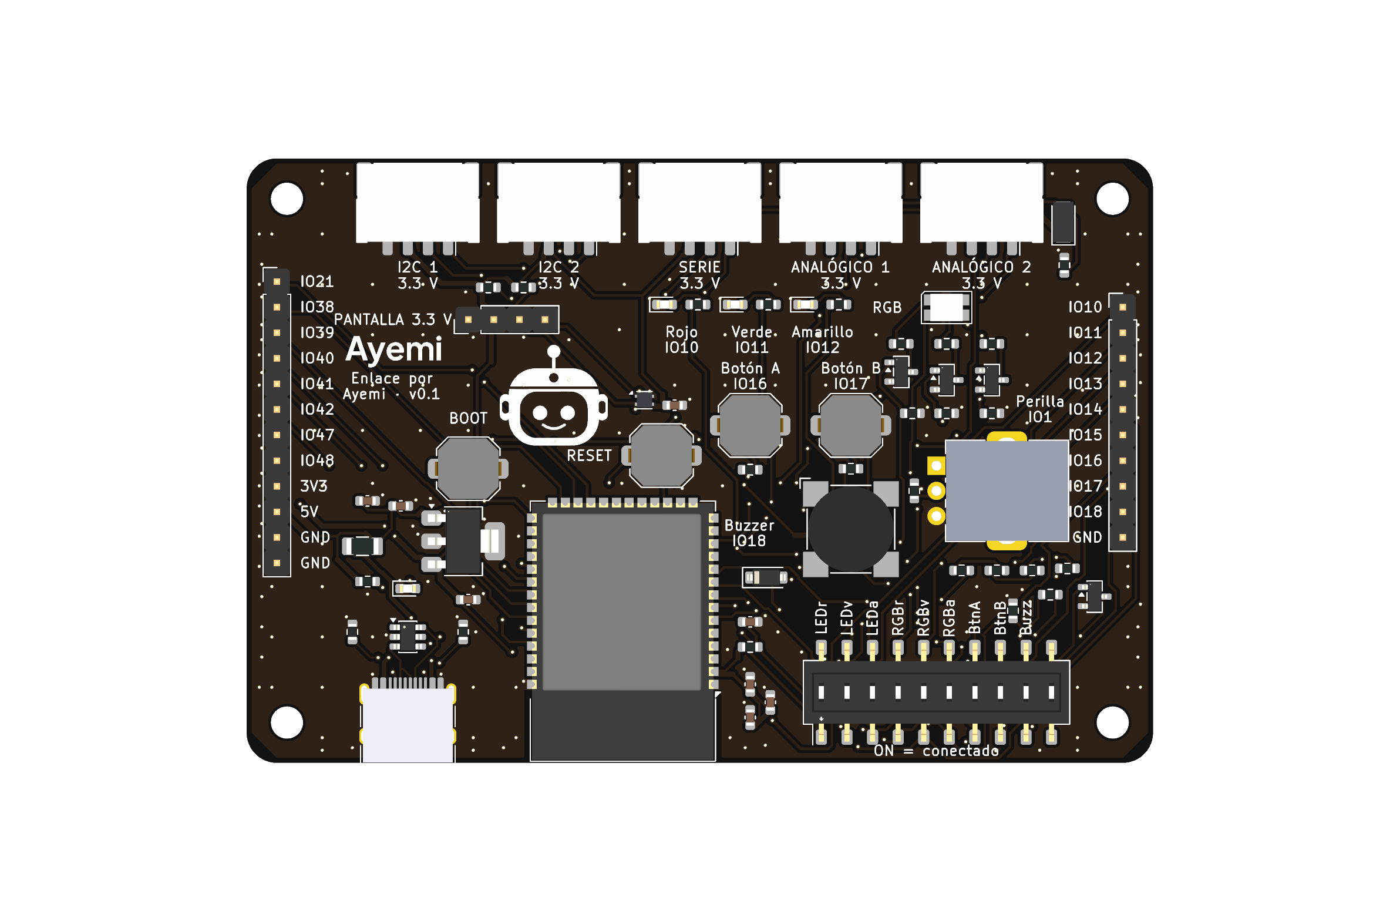
placas/enlace-esp32s3/docs/renders/superior.png
