ayemi-dev/pcb-ayemi/placas/entrenamiento-328p/docs/renders/inferior.png

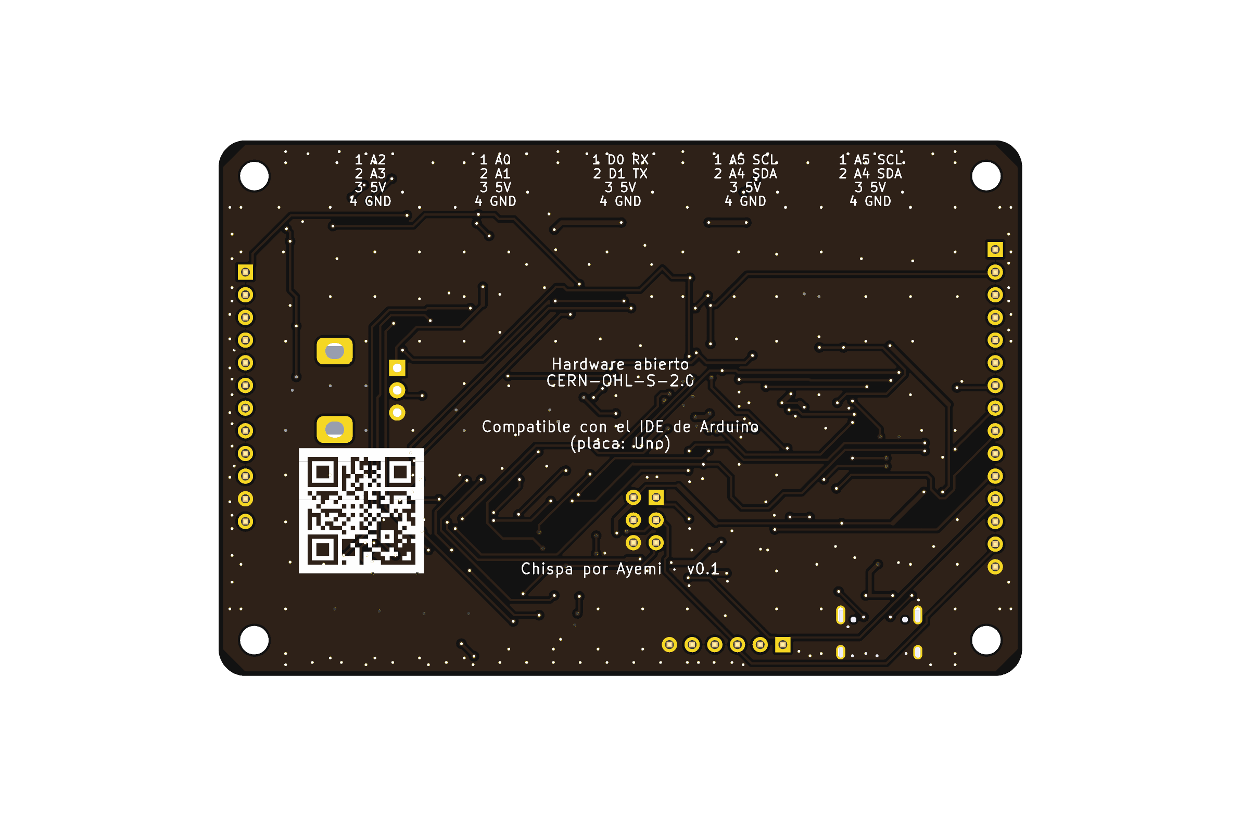
placas/entrenamiento-328p/docs/renders/inferior.png
