ayemi-dev/pcb-ayemi/placas/entrenamiento-328p/docs/renders/portada.png

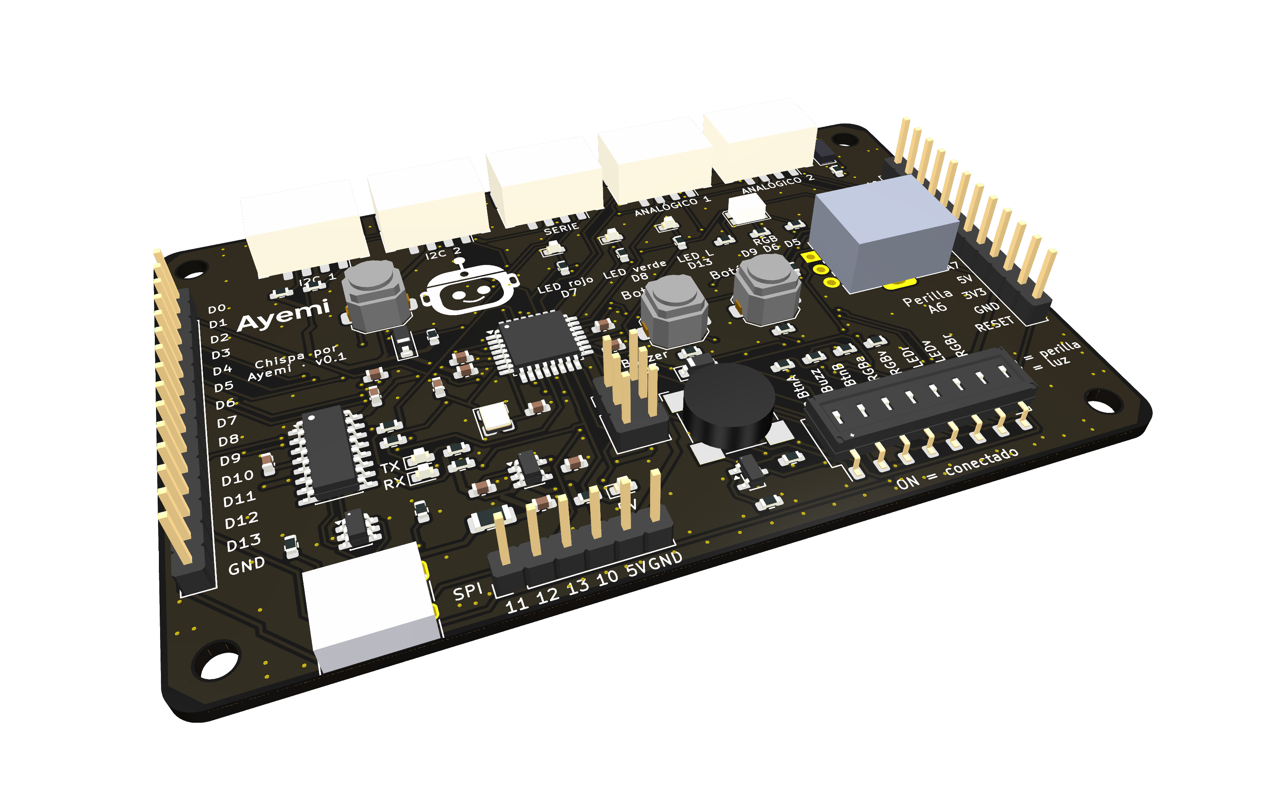
placas/entrenamiento-328p/docs/renders/portada.png
