ayemi-dev/pcb-ayemi/placas/entrenamiento-328p/docs/renders/superior.png

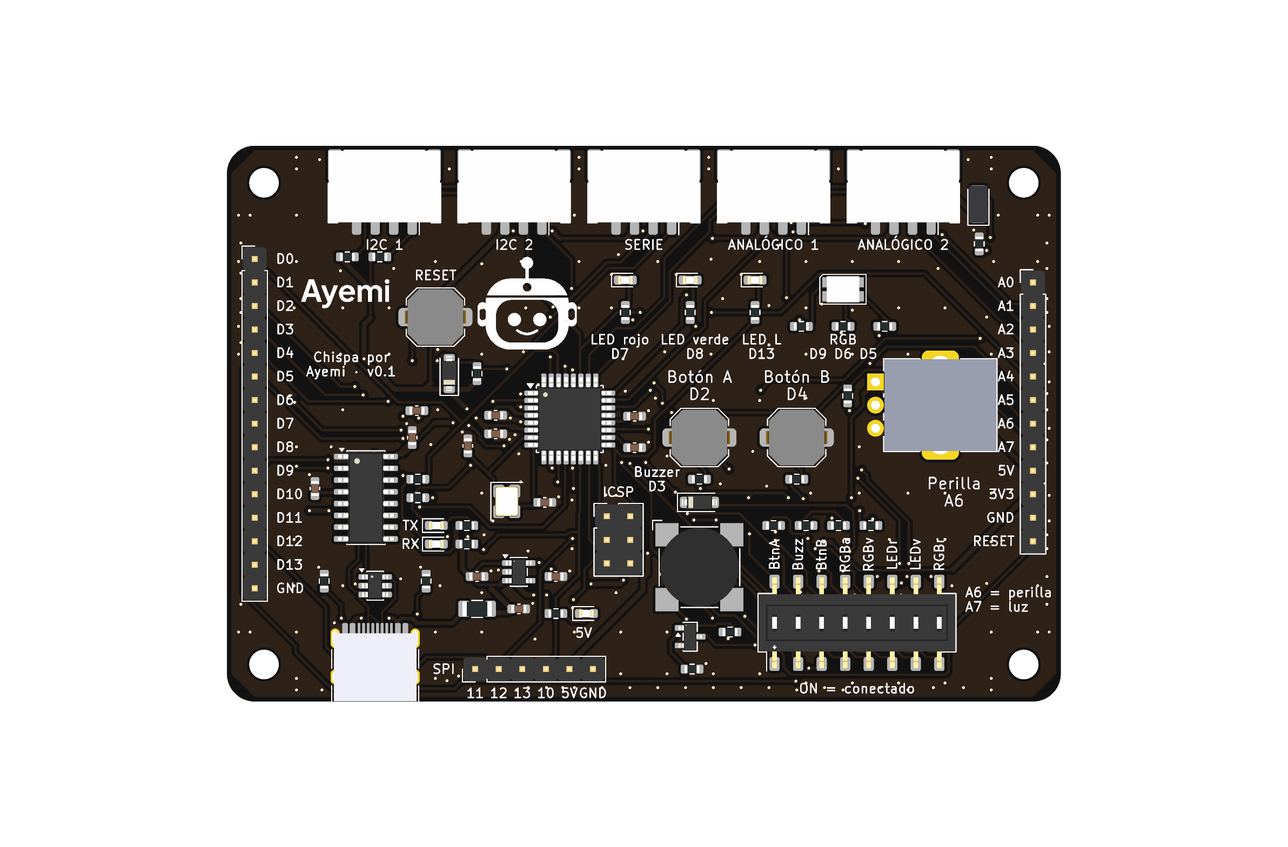
placas/entrenamiento-328p/docs/renders/superior.png
