ayemi-dev/pcb-ayemi/placas/impulso-stm32/docs/renders/inferior.png

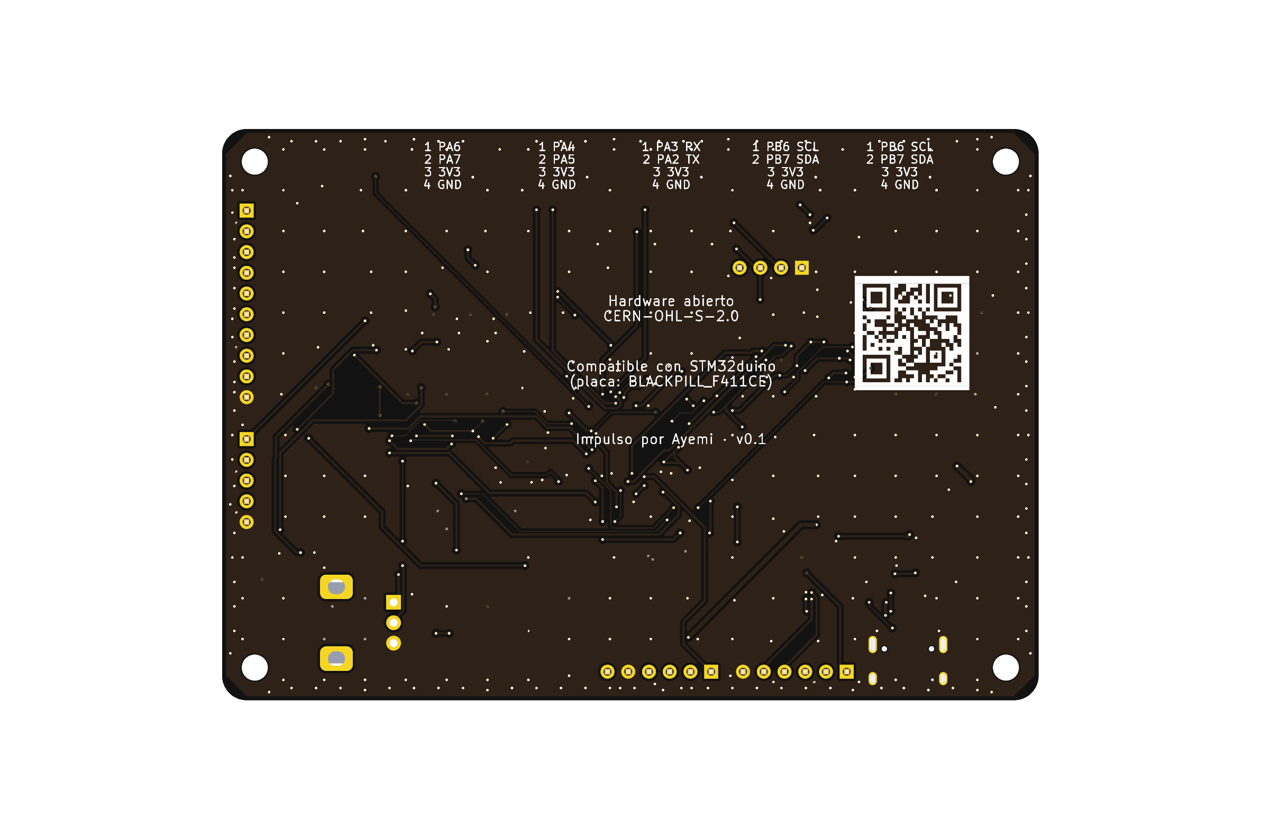
placas/impulso-stm32/docs/renders/inferior.png
