ayemi-dev/pcb-ayemi/placas/impulso-stm32/docs/renders/isometrico.png

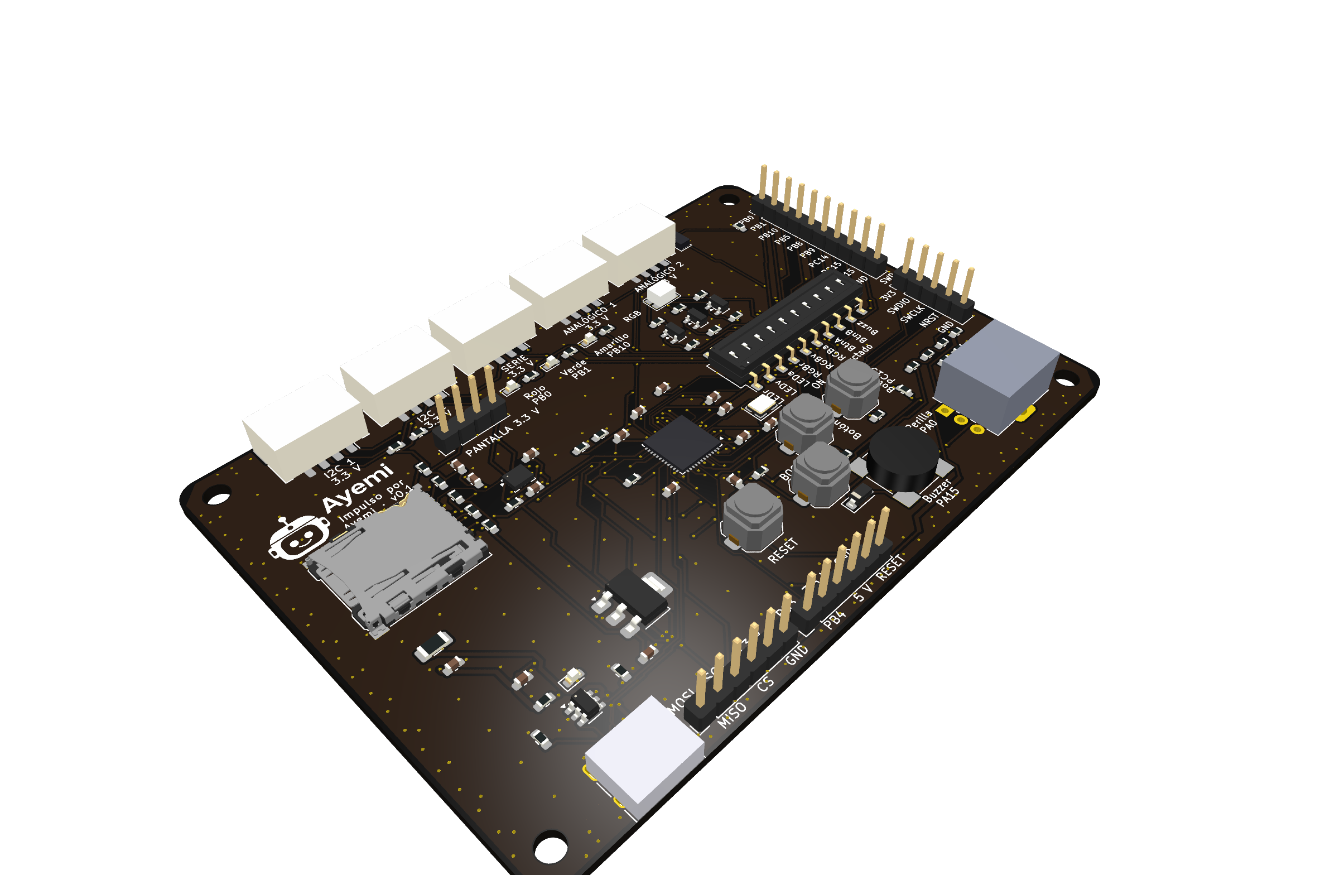
placas/impulso-stm32/docs/renders/isometrico.png
