ayemi-dev/pcb-ayemi/placas/impulso-stm32/docs/renders/portada.png

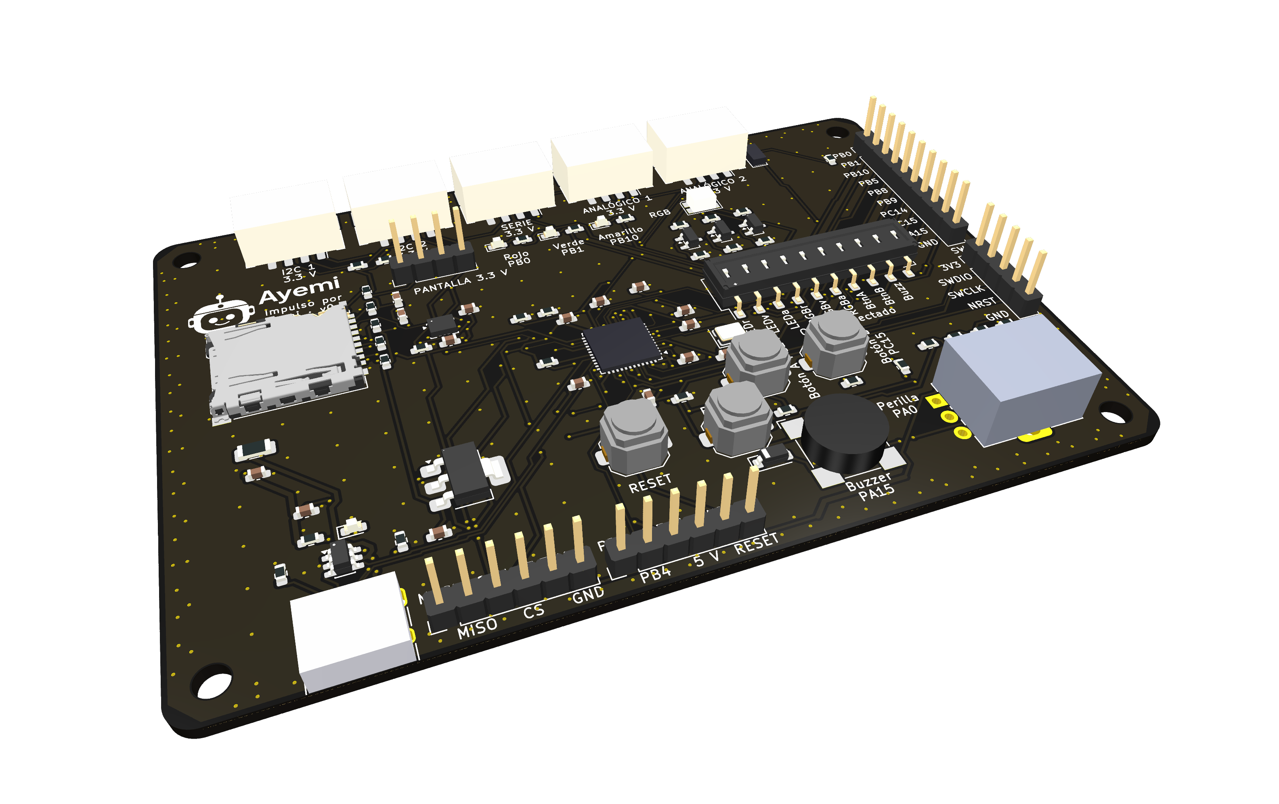
placas/impulso-stm32/docs/renders/portada.png
