ayemi-dev/pcb-ayemi/placas/impulso-stm32/docs/renders/superior.png

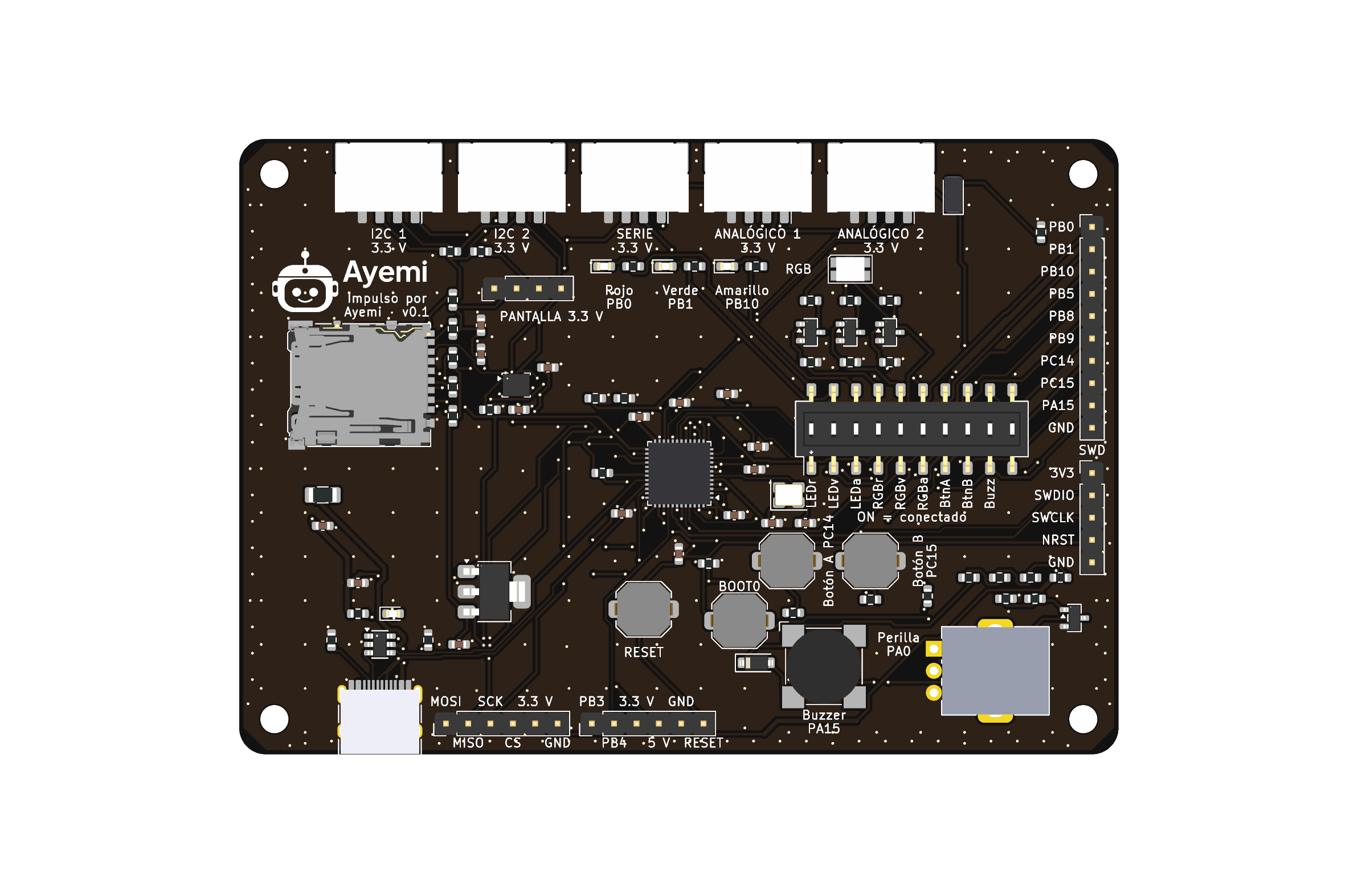
placas/impulso-stm32/docs/renders/superior.png
