ayemi-dev/pcb-ayemi/placas/enlace-esp32s3/fab/v0.1/bom_jlc_v0.1.csv

Comment | Designator | Footprint | LCSC Part # | Clase | Alternativa
Buzzer 5V | BZ301 | MagneticBuzzer_CUI_CMT-8504-100-SMT | C7421674 | Extended | C530411
10uF | C1,C201,C202,C203 | C_0603_1608Metric | C19702 | Basic | C380314
100nF | C2,C3,C301 | C_0603_1608Metric | C14663 | Basic | C91183
1uF | C4 | C_0603_1608Metric | C15849 | Basic | C106214
Azul | D201 | LED_0603_1608Metric | C2288 | Extended | C84266
Rojo | D301 | LED_0603_1608Metric | C2286 | Basic | C84263
Verde amarillento | D302 | LED_0603_1608Metric | C2289 | Extended | C84268
Amarillo | D303 | LED_0603_1608Metric | C2287 | Extended | C84268
RGB | D304 | LED_Avago_PLCC4_3.2x2.8mm_CW | C3029073 | Extended | C3029071
1N4148W | D305 | D_SOD-123 | C81598 | Basic | C2099
500mA | F201 | Fuse_1206_3216Metric | C163512 | Extended | C49318356
USB-C | J101 | USB_C_Receptacle_HRO_TYPE-C-31-M-12 | C165948 | Extended | C5337088
C265102 | J401,J402,J403,J404,J405 | JST_PH_S4B-PH-SM4-TB_1x04-1MP_P2.00mm_Horizontal | C265102 | Extended | C7429571
PANTALLA | J406 | PinHeader_1x04_P2.54mm_Vertical | C492403 | Extended | C2691448
IO A | J407 | PinHeader_1x10_P2.54mm_Vertical | C492409 | Extended | C41425300
IO B | J408 | PinHeader_1x12_P2.54mm_Vertical | C2840012 | Extended | C54803345
S8050 | Q301 | SOT-23 | C2146 | Basic | C105433
TEMT6000X01 | Q302 | LED_1206_3216Metric | C94098 | Extended | C47416518
2N7002 | Q303,Q304,Q305 | SOT-23 | C8545 | Basic | C12779
10k | R1,R310,R312,R320,R321,R322 | R_0603_1608Metric | C25804 | Basic | C98220
5.1k | R101,R102 | R_0603_1608Metric | C23186 | Basic | C105580
1.5k | R201 | R_0603_1608Metric | C22843 | Basic | C114668
330 | R301,R302,R303,R307,R308 | R_0603_1608Metric | C23138 | Basic | C105881
560 | R304,R305,R306 | R_0603_1608Metric | C23204 | Basic | C114629
1k | R309,R313 | R_0603_1608Metric | C21190 | Basic | C22548
10 | R311,R314,R315,R316 | R_0603_1608Metric | C22859 | Basic | C109318
4.7k | R401,R402 | R_0603_1608Metric | C23162 | Basic | C99782
10k | RV301 | Potentiometer_Alps_RK09K_Single_Vertical | C202373 | Extended | C351173
C319409 | SW1,SW2,SW301,SW302 | SW_Push_1TS009xxxx-xxxx-xxxx_6x6x5mm | C319409 | Extended | C255813
DIP10 | SW303 | SW_DIP_SPSTx10_Slide_Omron_A6S-1010x_W8.9mm_P2.54mm | C18198122 | Extended | C5160858
ESP32-S3-WROOM-1-N8 | U1 | ESP32-S3-WROOM-1_ayemi | C2913198 | Extended | C2913197
USBLC6-2SC6 | U102 | SOT-23-6 | C7519 | Extended | C2687116
AP7361C-33E | U201 | SOT-223-3_TabPin2 | C3743528 | Extended | C150716
SHT40 | U301 | SHT4x_ayemi | C2909890 | Extended | C2848306
