ayemi-dev/pcb-ayemi/placas/entrenamiento-328p/fab/v0.1/bom_jlc_v0.1.csv

Comment | Designator | Footprint | LCSC Part # | Clase | Alternativa
Buzzer 5V | BZ301 | MagneticBuzzer_CUI_CMT-8504-100-SMT | C7421674 | Extended | C530411
22pF | C1,C2 | C_0603_1608Metric | C1653 | Basic | C7419421
100nF | C3,C4,C5,C6,C101,C102,C103 | C_0603_1608Metric | C14663 | Basic | C91183
10uF | C201 | C_0603_1608Metric | C19702 | Basic | C380314
1uF | C202,C203 | C_0603_1608Metric | C15849 | Basic | C106214
1N4148W | D1,D305 | D_SOD-123 | C81598 | Basic | C2099
C2286 | D101,D102,D301 | LED_0603_1608Metric | C2286 | Basic | C84263
Azul | D201 | LED_0603_1608Metric | C2288 | Extended | C84266
Verde | D302 | LED_0603_1608Metric | C12624 | Extended | C84267
Amarillo | D303 | LED_0603_1608Metric | C2287 | Extended | C84268
RGB | D304 | LED_Avago_PLCC4_3.2x2.8mm_CW | C3647023 | Extended | C601684
500mA | F201 | Fuse_1206_3216Metric | C163512 | Extended | C49318356
ICSP | J1 | PinHeader_2x03_P2.54mm_Vertical | C65114 | Extended | C53055678
USB-C | J101 | USB_C_Receptacle_HRO_TYPE-C-31-M-12 | C165948 | Extended | C5337088
C265102 | J401,J402,J403,J404,J405 | JST_PH_S4B-PH-SM4-TB_1x04-1MP_P2.00mm_Horizontal | C265102 | Extended | C7429571
SPI | J406 | PinHeader_1x06_P2.54mm_Vertical | C492405 | Extended | C42431790
D0-D13 y GND | J407 | PinHeader_1x15_P2.54mm_Vertical | C22465875 | Extended | C2932704
A0-A7 y alimentacion | J408 | PinHeader_1x12_P2.54mm_Vertical | C2840012 | Extended | C54803345
S8050 | Q301 | SOT-23 | C2146 | Basic | C105433
TEMT6000X01 | Q302 | LED_1206_3216Metric | C94098 | Extended | C47416518
10k | R1,R310,R312 | R_0603_1608Metric | C25804 | Basic | C98220
5.1k | R101,R102 | R_0603_1608Metric | C23186 | Basic | C105580
1k | R103,R104,R301,R309,R313 | R_0603_1608Metric | C21190 | Basic | C22548
1.5k | R105,R106,R201 | R_0603_1608Metric | C22843 | Basic | C114668
510 | R302,R306 | R_0603_1608Metric | C23193 | Basic | C114670
680 | R303,R304 | R_0603_1608Metric | C23228 | Basic | C112310
560 | R305 | R_0603_1608Metric | C23204 | Basic | C114629
330 | R307,R308 | R_0603_1608Metric | C23138 | Basic | C105881
10 | R311,R314,R315,R316 | R_0603_1608Metric | C22859 | Basic | C109318
4.7k | R401,R402 | R_0603_1608Metric | C23162 | Basic | C99782
10k | RV301 | Potentiometer_Alps_RK09K_Single_Vertical | C202373 | Extended | C351173
C319409 | SW1,SW301,SW302 | SW_Push_1TS009xxxx-xxxx-xxxx_6x6x5mm | C319409 | Extended | C255813
DIP8 | SW303 | SW_DIP_SPSTx08_Slide_Omron_A6S-810x_W8.9mm_P2.54mm | C6709493 | Extended | C7502790
ATmega328P-AU | U1 | TQFP-32_7x7mm_P0.8mm | C14877 | Extended | C618816
CH340C | U101 | SOIC-16_3.9x9.9mm_P1.27mm | C84681 | Extended | C7464026
USBLC6-2SC6 | U102 | SOT-23-6 | C7519 | Extended | C2687116
AP2112K-3.3 | U201 | SOT-23-5 | C51118 | Extended | C82942
16MHz | Y1 | Crystal_SMD_3225-4Pin_3.2x2.5mm | C70562 | Extended | C362471
