ayemi-dev/pcb-ayemi/placas/impulso-stm32/fab/v0.1/bom_jlc_v0.1.csv

Comment | Designator | Footprint | LCSC Part # | Clase | Alternativa
Buzzer 5V | BZ301 | MagneticBuzzer_CUI_CMT-8504-100-SMT | C7421674 | Extended | C530411
33pF | C1,C2 | C_0603_1608Metric | C1663 | Basic | C107047
100nF | C3,C4,C5,C6,C10,C301,C302,C402 | C_0603_1608Metric | C14663 | Basic | C91183
1uF | C7 | C_0603_1608Metric | C15849 | Basic | C106214
4.7uF | C8 | C_0603_1608Metric | C19666 | Basic | C277476
10uF | C9,C201,C202,C203,C401 | C_0603_1608Metric | C19702 | Basic | C380314
Azul | D201 | LED_0603_1608Metric | C2288 | Extended | C84266
Rojo | D301 | LED_0603_1608Metric | C2286 | Basic | C84263
Verde amarillento | D302 | LED_0603_1608Metric | C2289 | Extended | C84268
Amarillo | D303 | LED_0603_1608Metric | C2287 | Extended | C84268
RGB | D304 | LED_Avago_PLCC4_3.2x2.8mm_CW | C3029073 | Extended | C3029071
1N4148W | D305 | D_SOD-123 | C81598 | Basic | C2099
500mA | F201 | Fuse_1206_3216Metric | C163512 | Extended | C49318356
SWD | J1 | PinHeader_1x05_P2.54mm_Vertical | C492404 | Extended | C56153596
USB-C | J101 | USB_C_Receptacle_HRO_TYPE-C-31-M-12 | C165948 | Extended | C5337088
C265102 | J401,J402,J403,J404,J405 | JST_PH_S4B-PH-SM4-TB_1x04-1MP_P2.00mm_Horizontal | C265102 | Extended | C7429571
PANTALLA | J406 | PinHeader_1x04_P2.54mm_Vertical | C492403 | Extended | C2691448
IO A | J407 | PinHeader_1x10_P2.54mm_Vertical | C492409 | Extended | C41425300
C492405 | J408,J409 | PinHeader_1x06_P2.54mm_Vertical | C492405 | Extended | C42431790
microSD | J411 | microSD_HC_Hirose_DM3AT-SF-PEJM5 | C114218 | Extended | C585350
S8050 | Q301 | SOT-23 | C2146 | Basic | C105433
TEMT6000X01 | Q302 | LED_1206_3216Metric | C94098 | Extended | C47416518
2N7002 | Q303,Q304,Q305 | SOT-23 | C8545 | Basic | C12779
10k | R1,R2,R3,R310,R312,R320,R321,R322,R323,R403,R404,R405,R406,R407 | R_0603_1608Metric | C25804 | Basic | C98220
100k | R4 | R_0603_1608Metric | C25803 | Basic | C14675
5.1k | R101,R102 | R_0603_1608Metric | C23186 | Basic | C105580
1.5k | R201 | R_0603_1608Metric | C22843 | Basic | C114668
330 | R301,R302,R303,R307,R308 | R_0603_1608Metric | C23138 | Basic | C105881
560 | R304,R305,R306 | R_0603_1608Metric | C23204 | Basic | C114629
1k | R309,R313 | R_0603_1608Metric | C21190 | Basic | C22548
10 | R311,R314,R315,R316 | R_0603_1608Metric | C22859 | Basic | C109318
4.7k | R401,R402 | R_0603_1608Metric | C23162 | Basic | C99782
10k | RV301 | Potentiometer_Alps_RK09K_Single_Vertical | C202373 | Extended | C351173
C319409 | SW1,SW2,SW301,SW302 | SW_Push_1TS009xxxx-xxxx-xxxx_6x6x5mm | C319409 | Extended | C255813
DIP10 | SW303 | SW_DIP_SPSTx10_Slide_Omron_A6S-1010x_W8.9mm_P2.54mm | C18198122 | Extended | C5160858
STM32F411CEU6 | U1 | QFN-48-1EP_7x7mm_P0.5mm_EP5.6x5.6mm | C60420 | Extended | C2054095
USBLC6-2SC6 | U102 | SOT-23-6 | C7519 | Extended | C2687116
AP7361C-33E | U201 | SOT-223-3_TabPin2 | C3743528 | Extended | C150716
LSM6DS3TR-C | U301 | LGA-14_3x2.5mm_P0.5mm_LayoutBorder3x4y | C967633 | Extended | C2655100
25MHz | Y1 | Crystal_SMD_3225-4Pin_3.2x2.5mm | C13740 | Extended | C5160142
