ayemi-dev/pcb-ayemi/placas/enlace-esp32s3/firmware/enlace_demo/build/compilacion.md

# Compilación del demo de Enlace

Generado el 2026-11-02 con arduino-cli 1.5.2-rc.1 y el núcleo esp32:esp32 3.0.3 (Espressif).

- Placa: `esp32:esp32:esp32s3:CDCOnBoot=cdc` (ESP32S3 Dev Module, USB CDC On Boot: Enabled).
- Flash: 947 953 bytes (72 % de 1 310 720).
- RAM: 42 976 bytes (13 % de 327 680).
- Archivo: `enlace_demo.bin` (aplicación sola; en una placa nueva se carga desde el IDE para que ponga el cargador y la tabla de particiones).
- Probado en placa: no.
