ayemi-dev/pcb-ayemi/placas/entrenamiento-328p/firmware/prueba_fabrica/build/compilacion.md

# Compilación de `prueba_fabrica`

Generado por `tools/firmware.py compilar`. No se edita a mano.

- Placa: Arduino Uno (`arduino:avr:uno`), atmega328p a 16 MHz.
- Núcleo: Arduino AVR 1.8.8. Compilador: avr-gcc 7.3.0-atmel3.6.1-arduino7.
- Flash: 5322 de 32256 bytes (16 %).
- RAM de variables globales: 234 de 2048 bytes (11 %).
- Archivo: `prueba_fabrica.hex`.
