ayemi-dev/pcb-ayemi/placas/impulso-stm32/firmware/impulso_demo/build/compilacion.md

# Compilación del demo de Impulso

Generado el 2026-11-02 con arduino-cli 1.5.2-rc.1, el paquete STMicroelectronics:stm32 3.0.0 (STM32duino) y la biblioteca SD 1.3.0.

- Placa: `STMicroelectronics:stm32:GenF4:pnum=BLACKPILL_F411CE,usb=CDCgen,upload_method=dfuMethod`.
- Flash: 51 124 bytes (9 % de 524 288).
- RAM: 5 748 bytes (4 % de 131 072).
- Archivo: `impulso_demo.bin`.
- Probado en placa: no (la placa no está cerrada).
