ayemi-dev/pcb-ayemi/placas/enlace-esp32s3/fab/v0.1/esquematico_v0.1.pdf

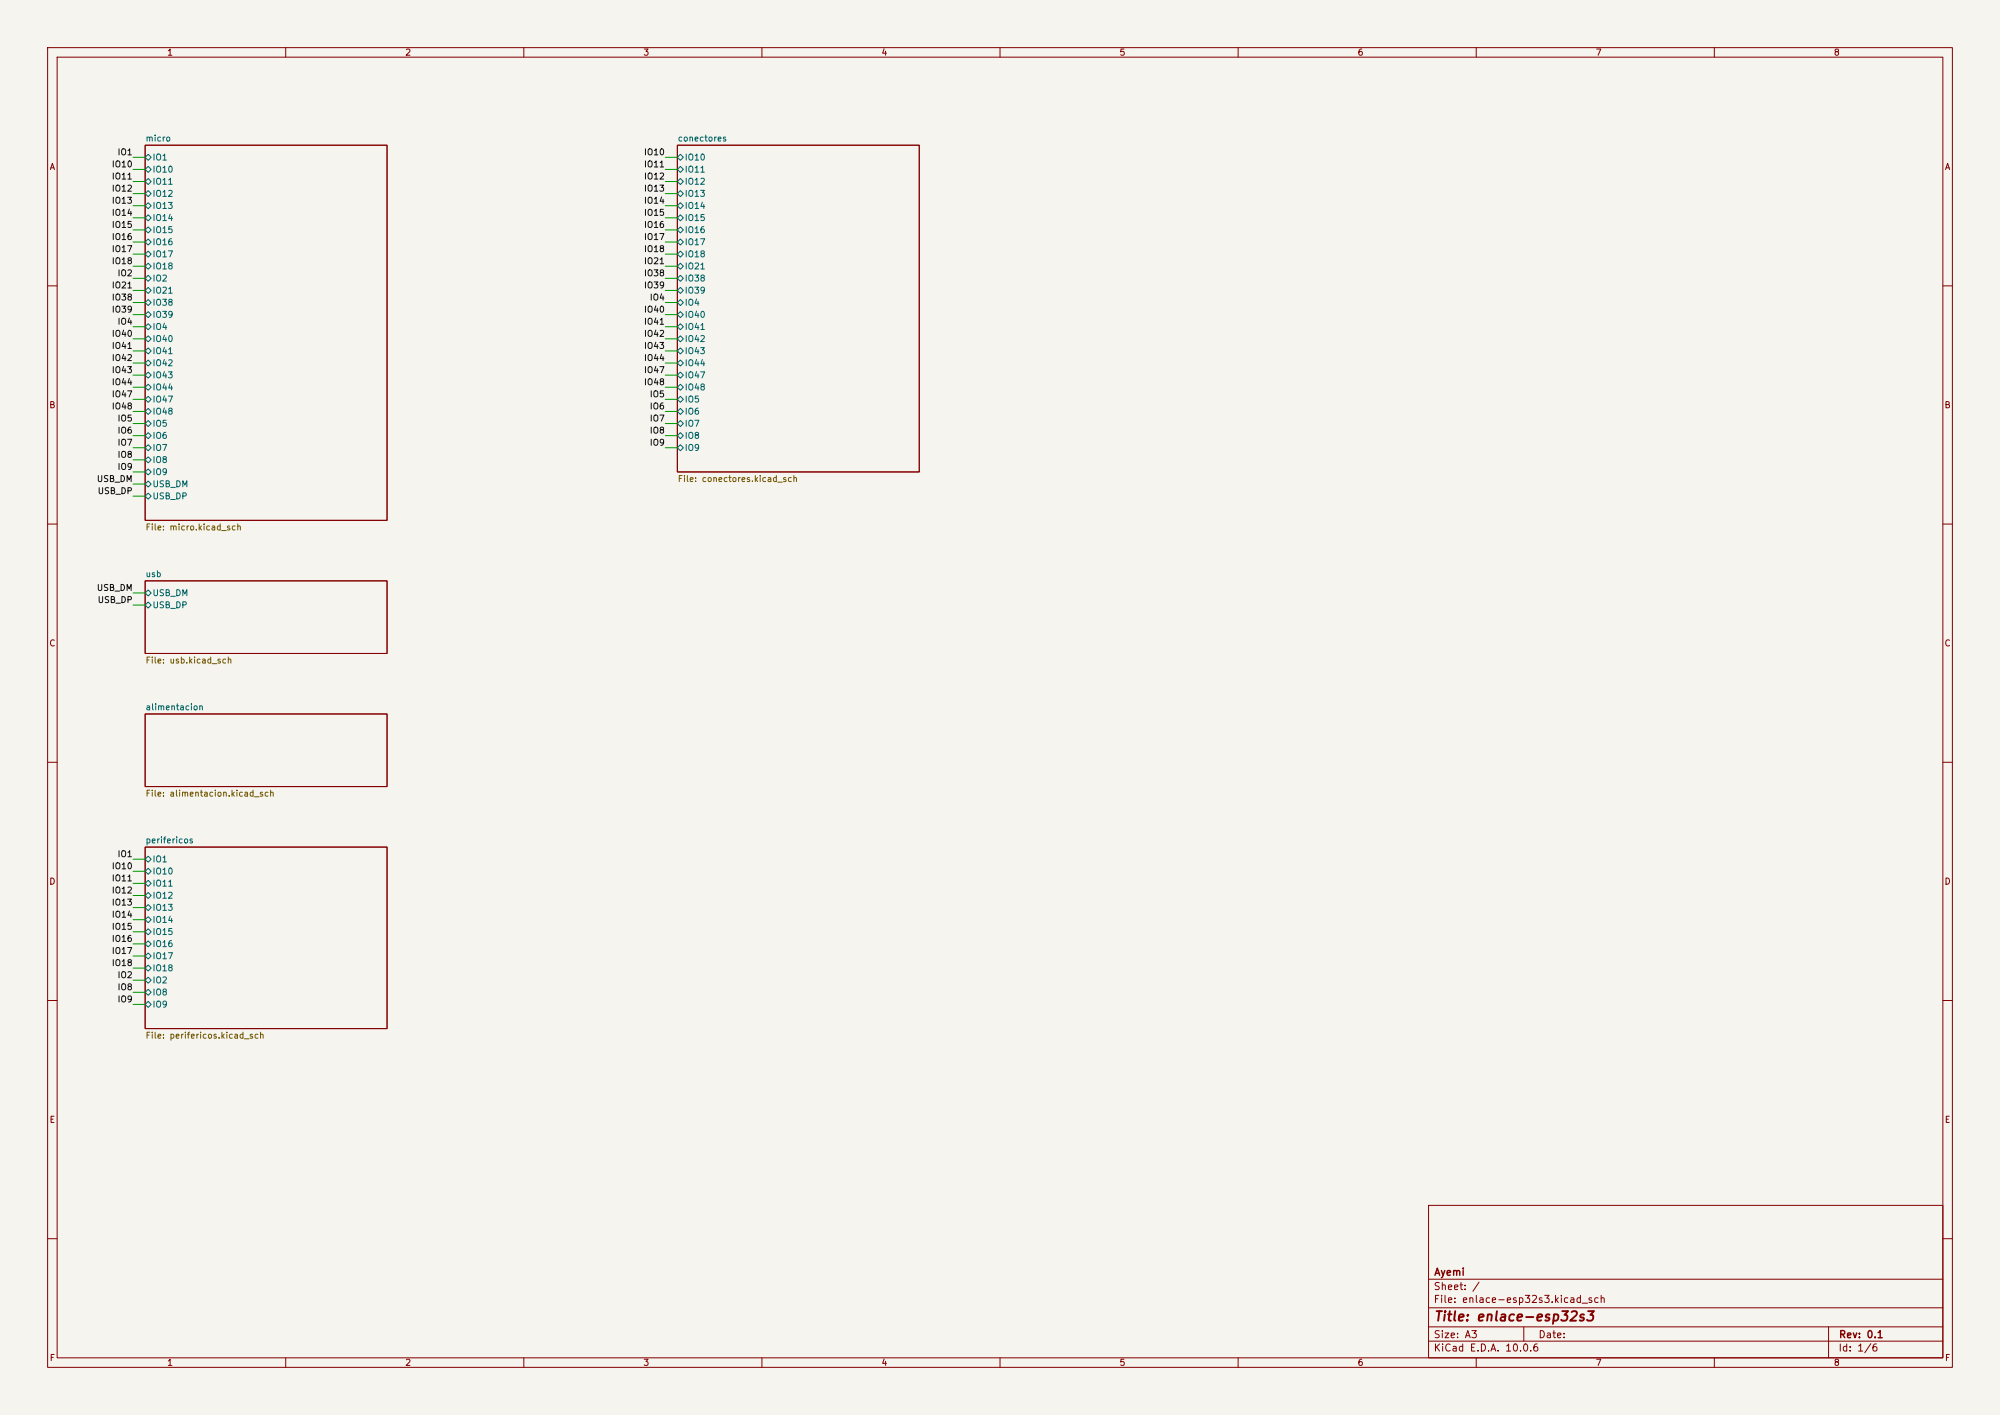
[picture p12: page 1]

Size: A3 | Rev: 0.1
KiCad E.D.A. 10.0.6 | Id: 1/6

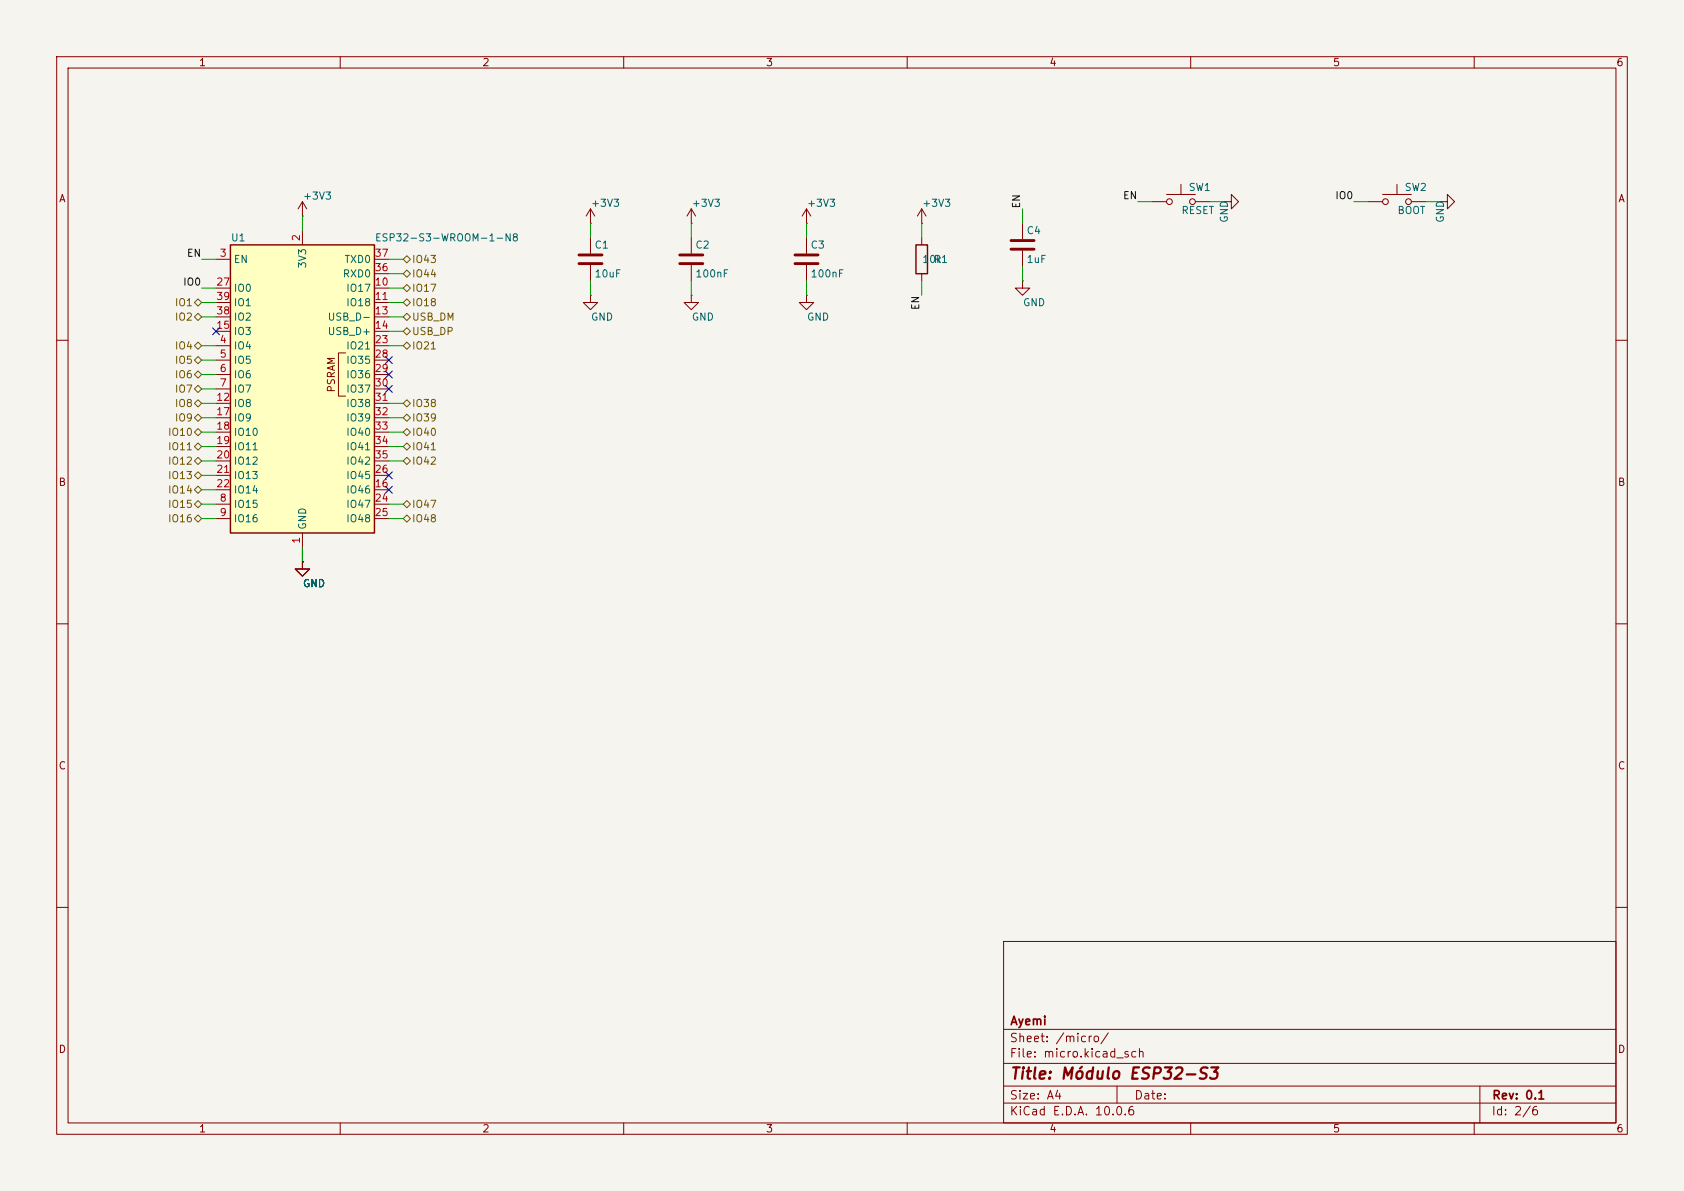
[picture p13: page 2]

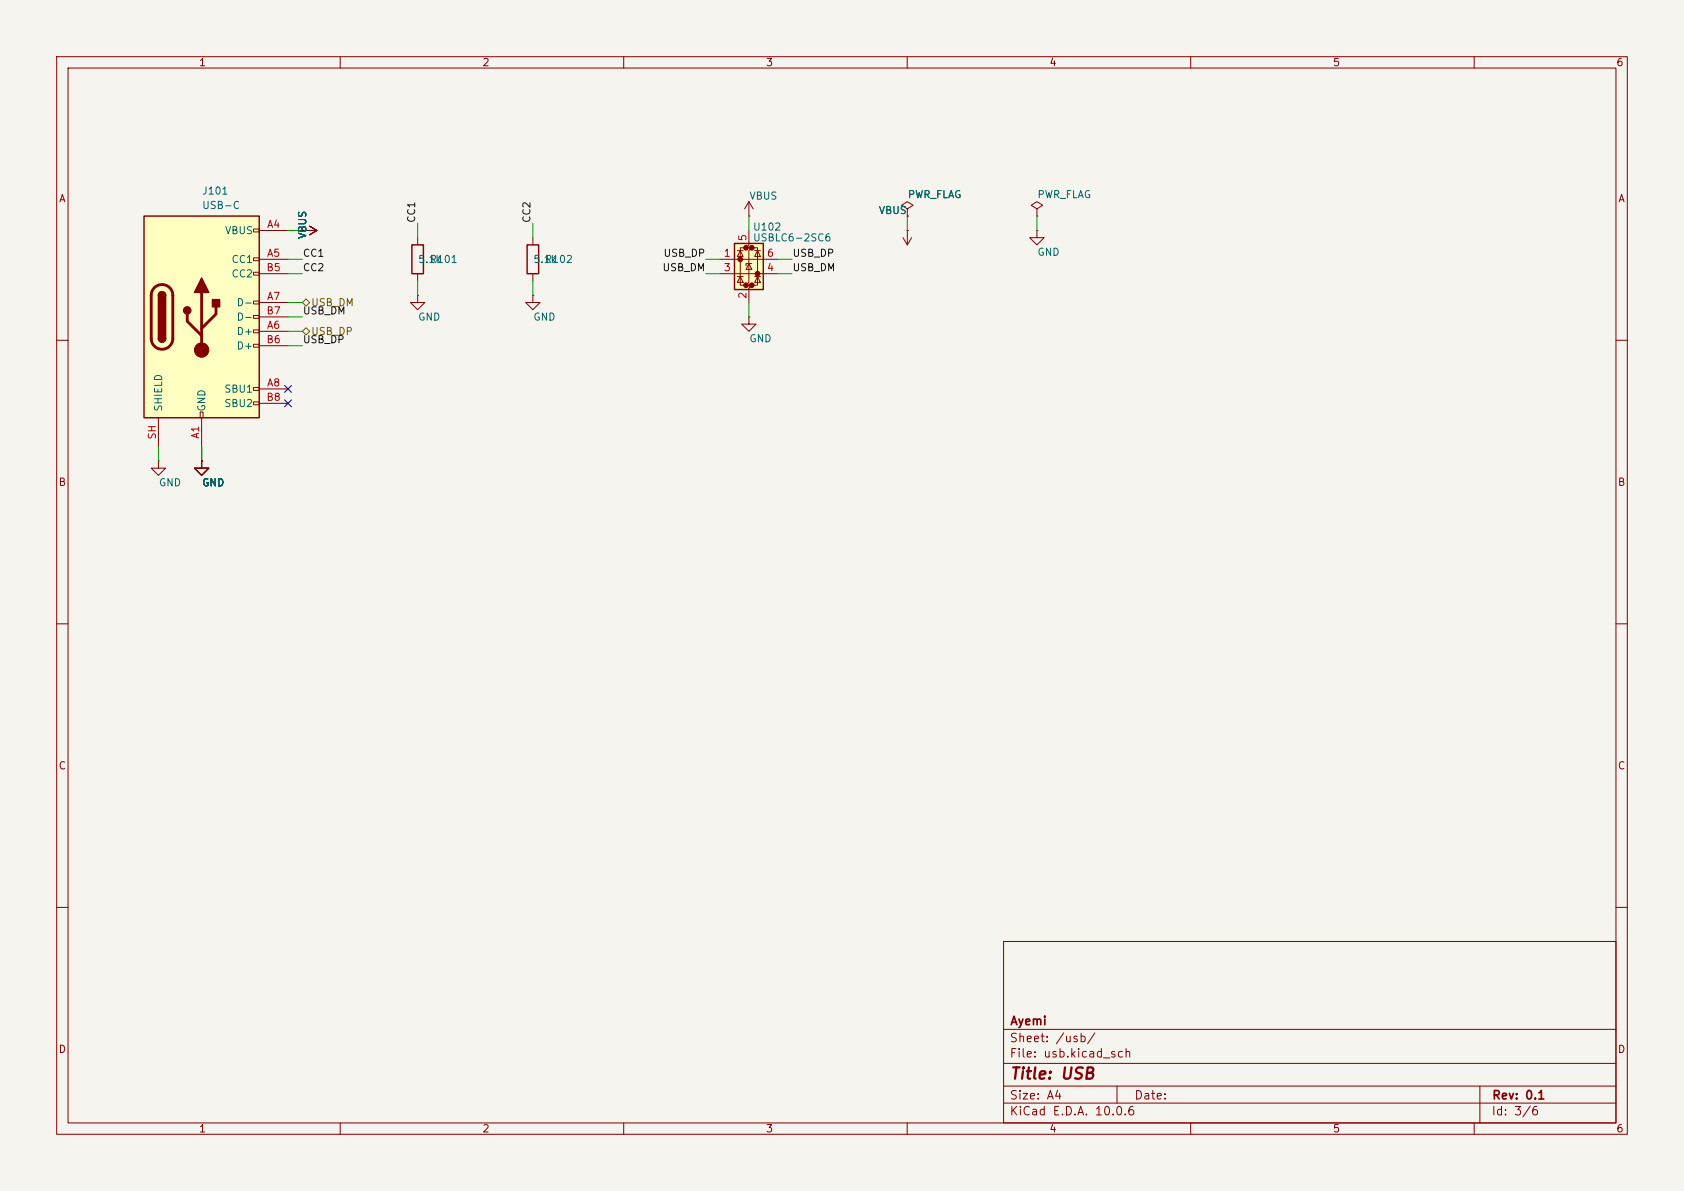
[picture p14: page 3]

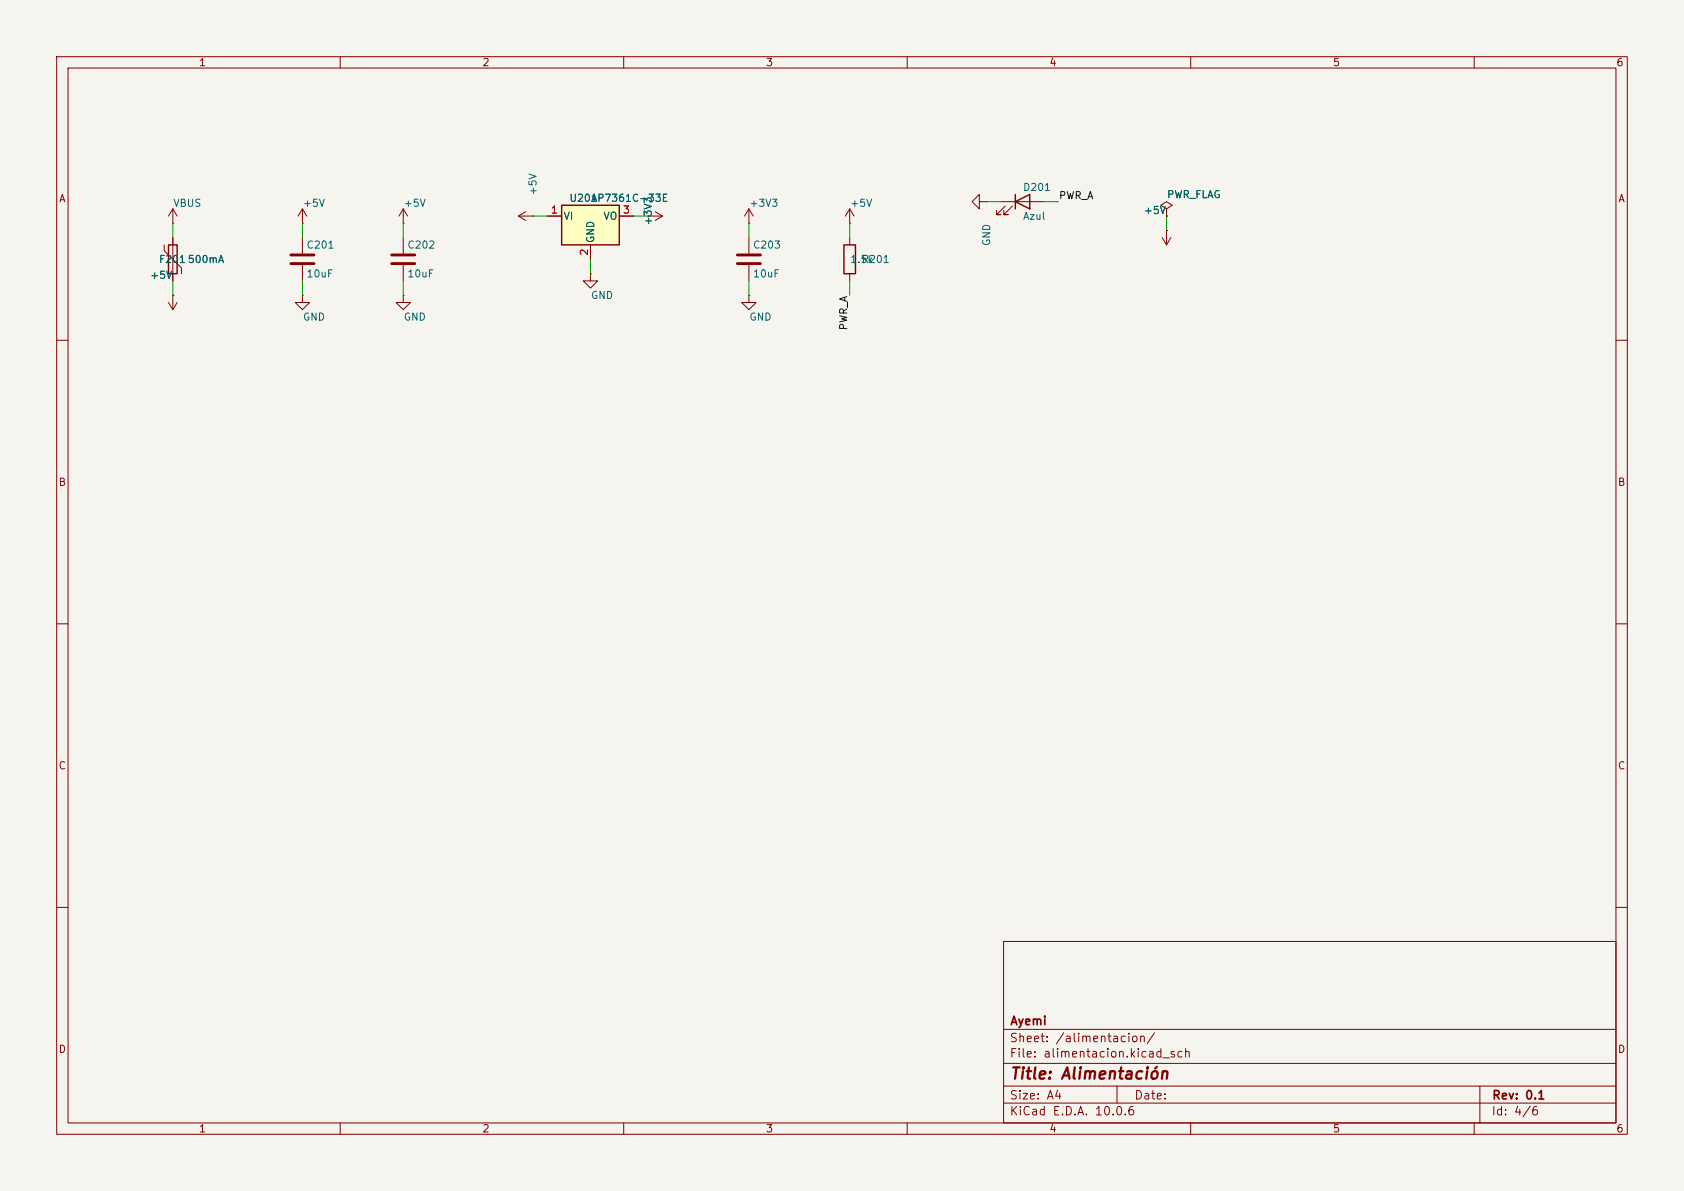
[picture p15: page 4]

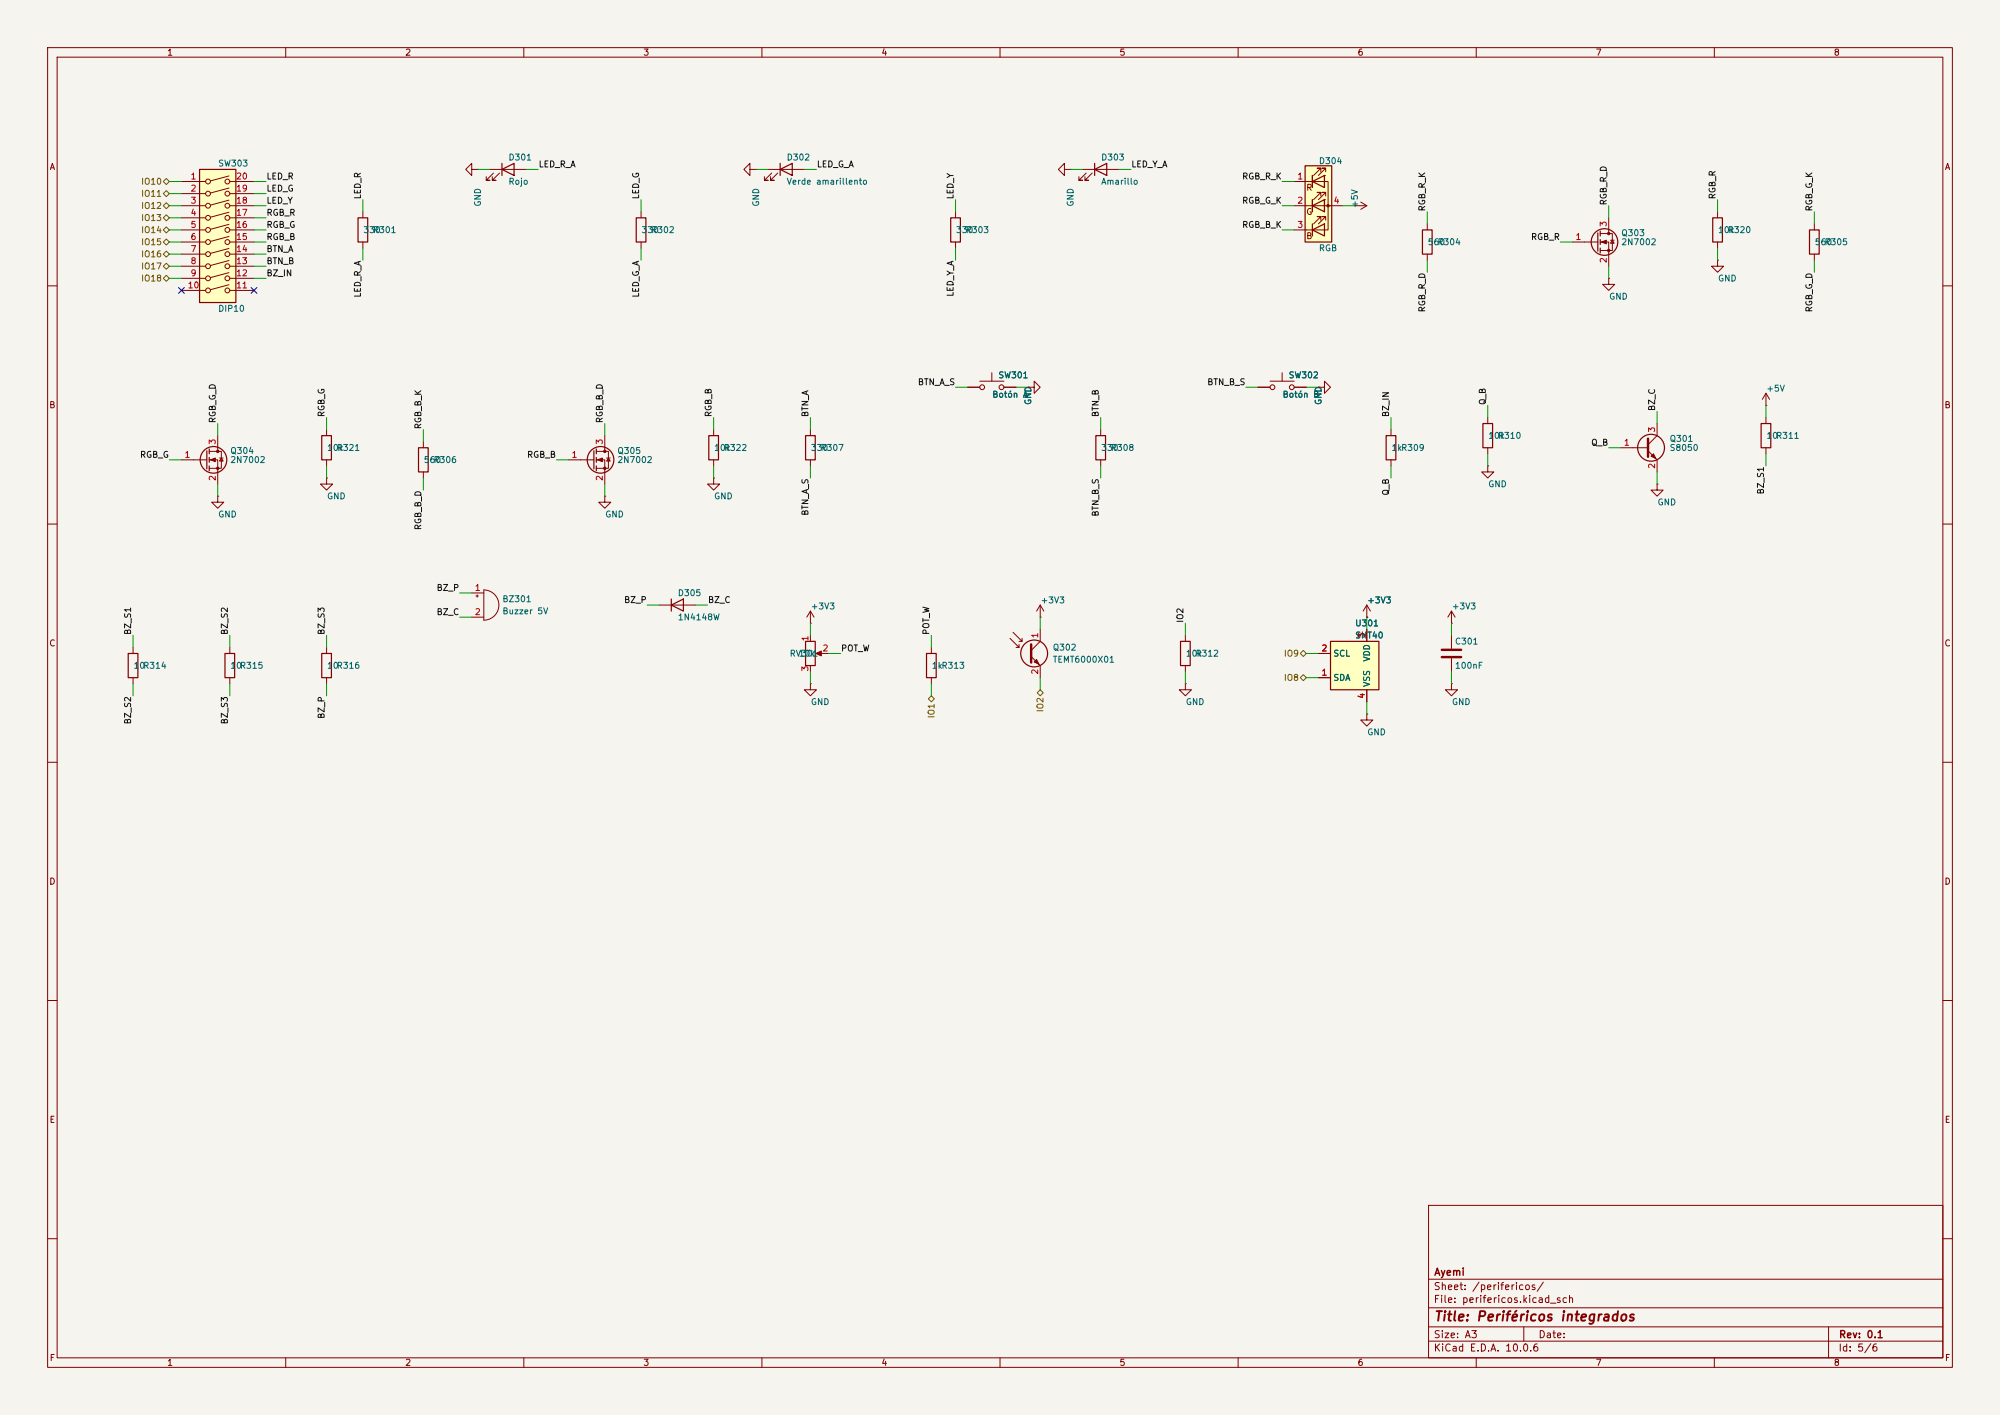
[picture p16: page 5]

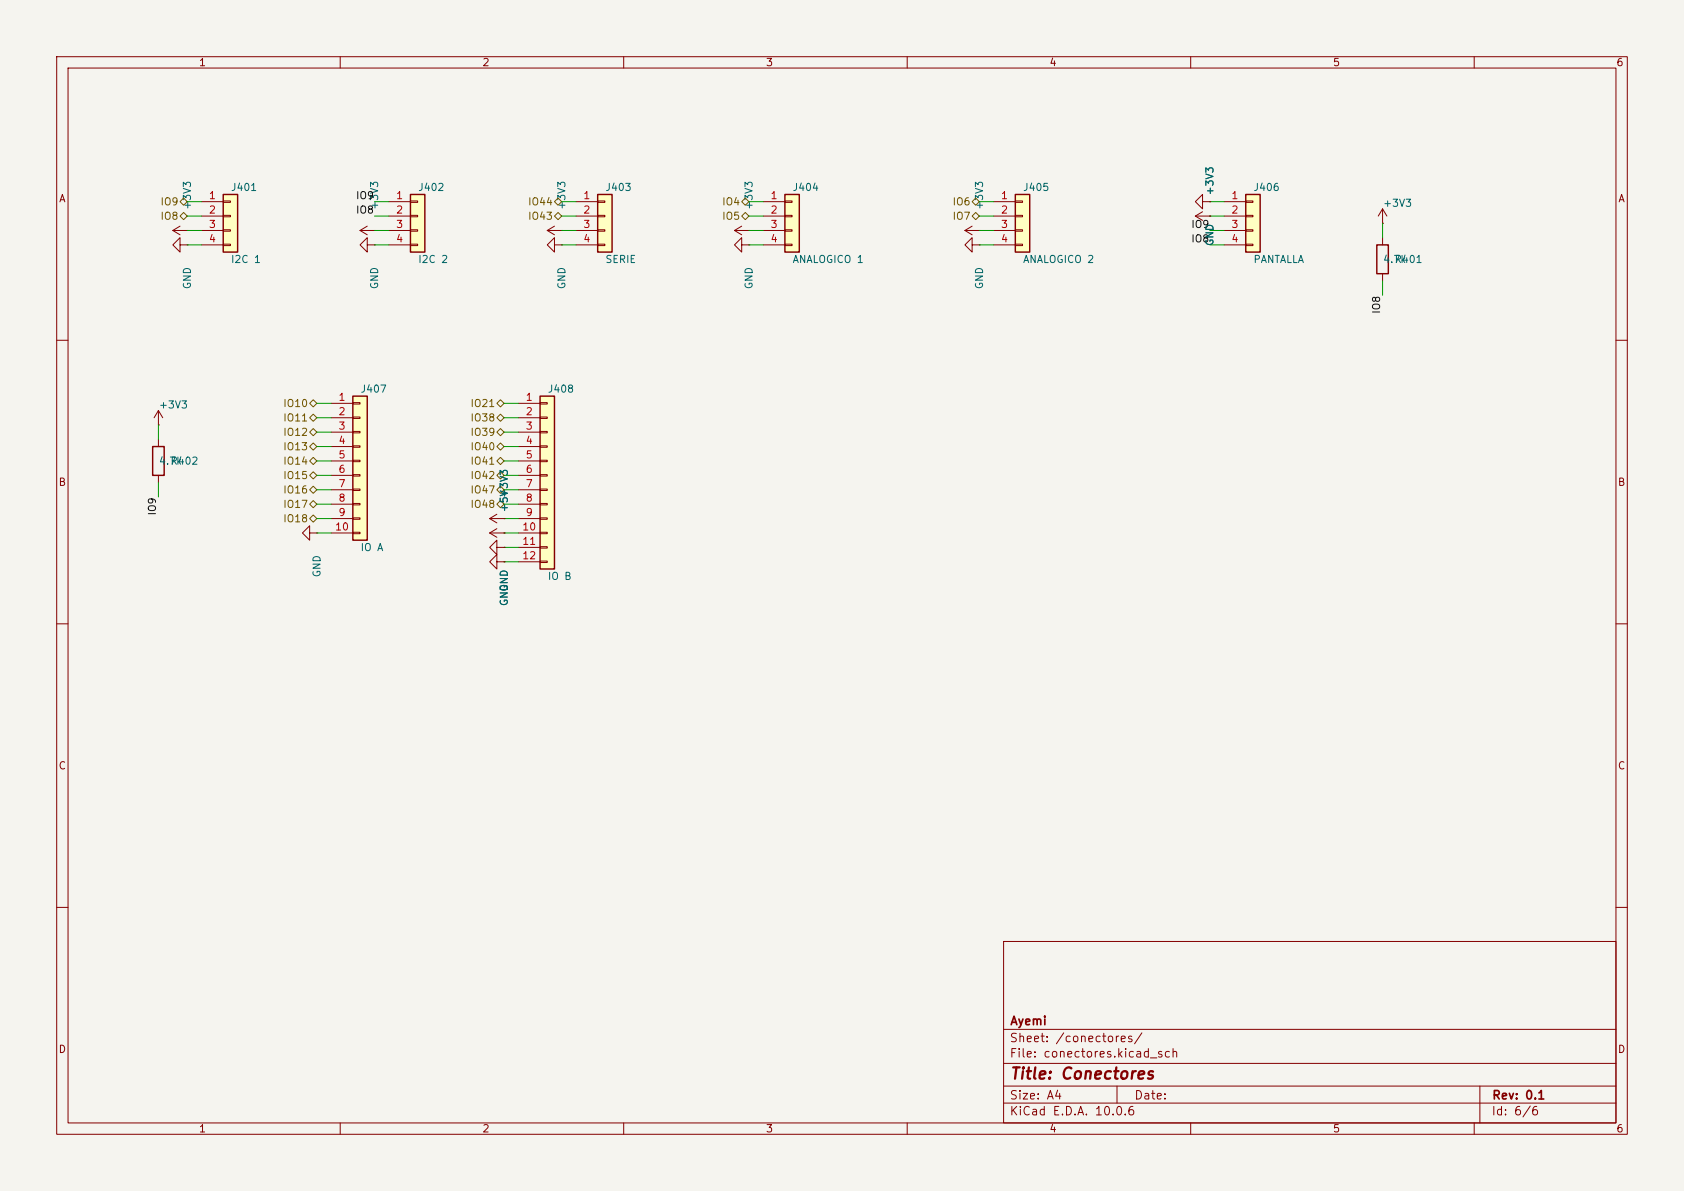
[picture p17: page 6]
