ayemi-dev/pcb-ayemi/placas/enlace-esp32s3/fab/v0.1/serigrafia_1a1_v0.1_inferior.pdf

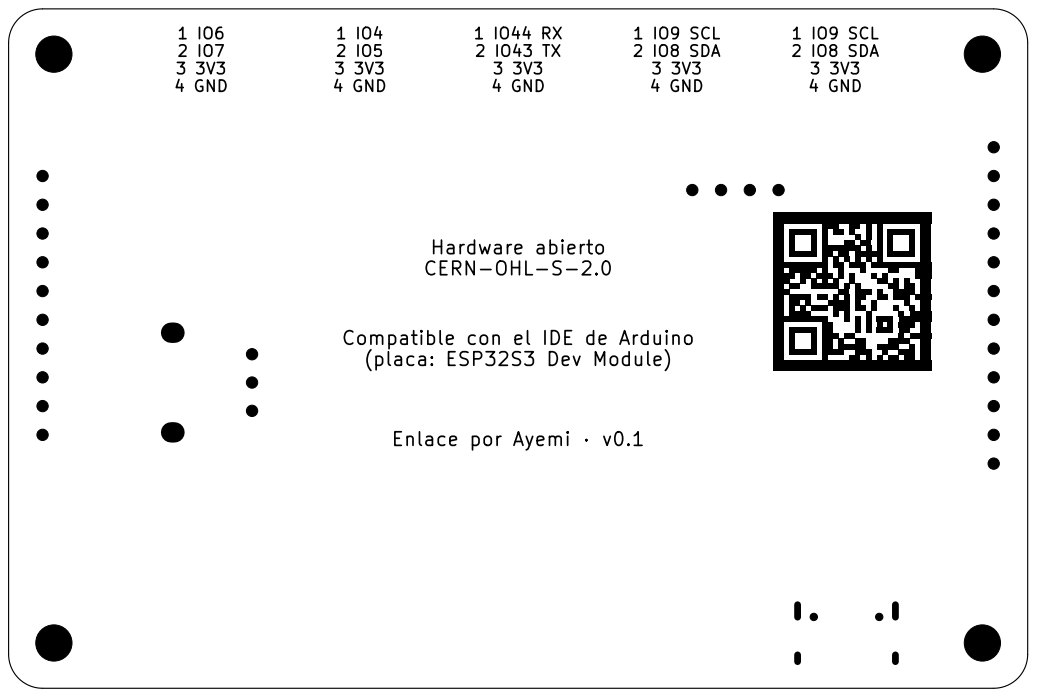
[picture p18: page 1]

(placa: ESP32S3 Dev Module) Enlace por Ayemi · v0.1
