ayemi-dev/pcb-ayemi/placas/enlace-esp32s3/fab/v0.1/serigrafia_1a1_v0.1_superior.pdf

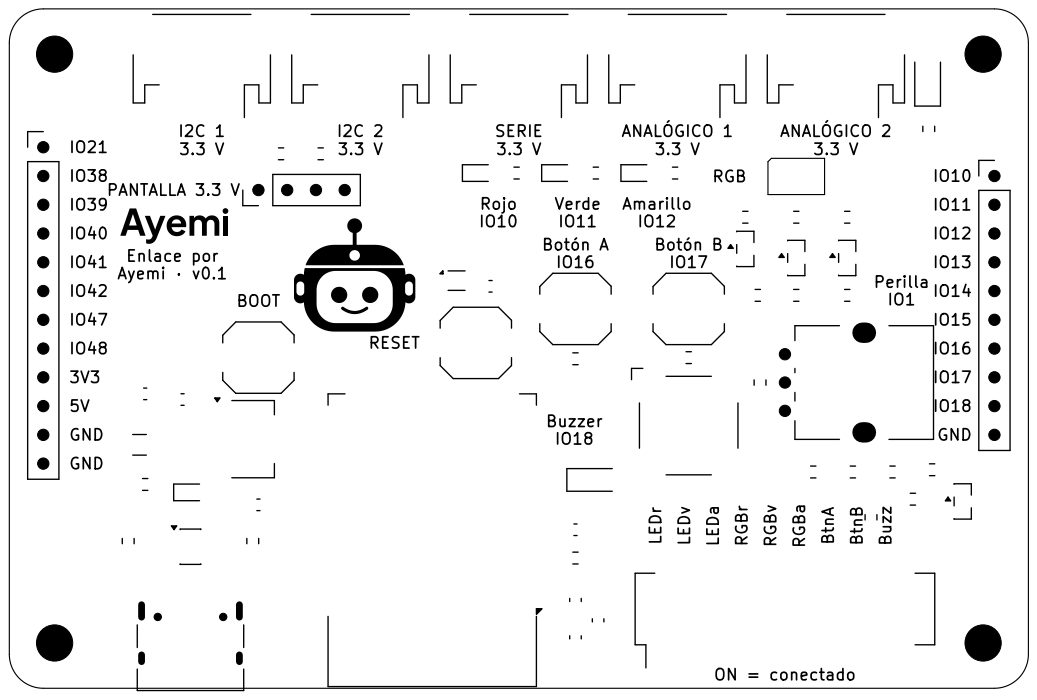
[picture p19: page 1]

IO18 GND LEDr LEDv LEDa RGBr RGBv RGBa BtnA BtnB Buzz
