ayemi-dev/pcb-ayemi/placas/entrenamiento-328p/fab/v0.1/esquematico_v0.1.pdf

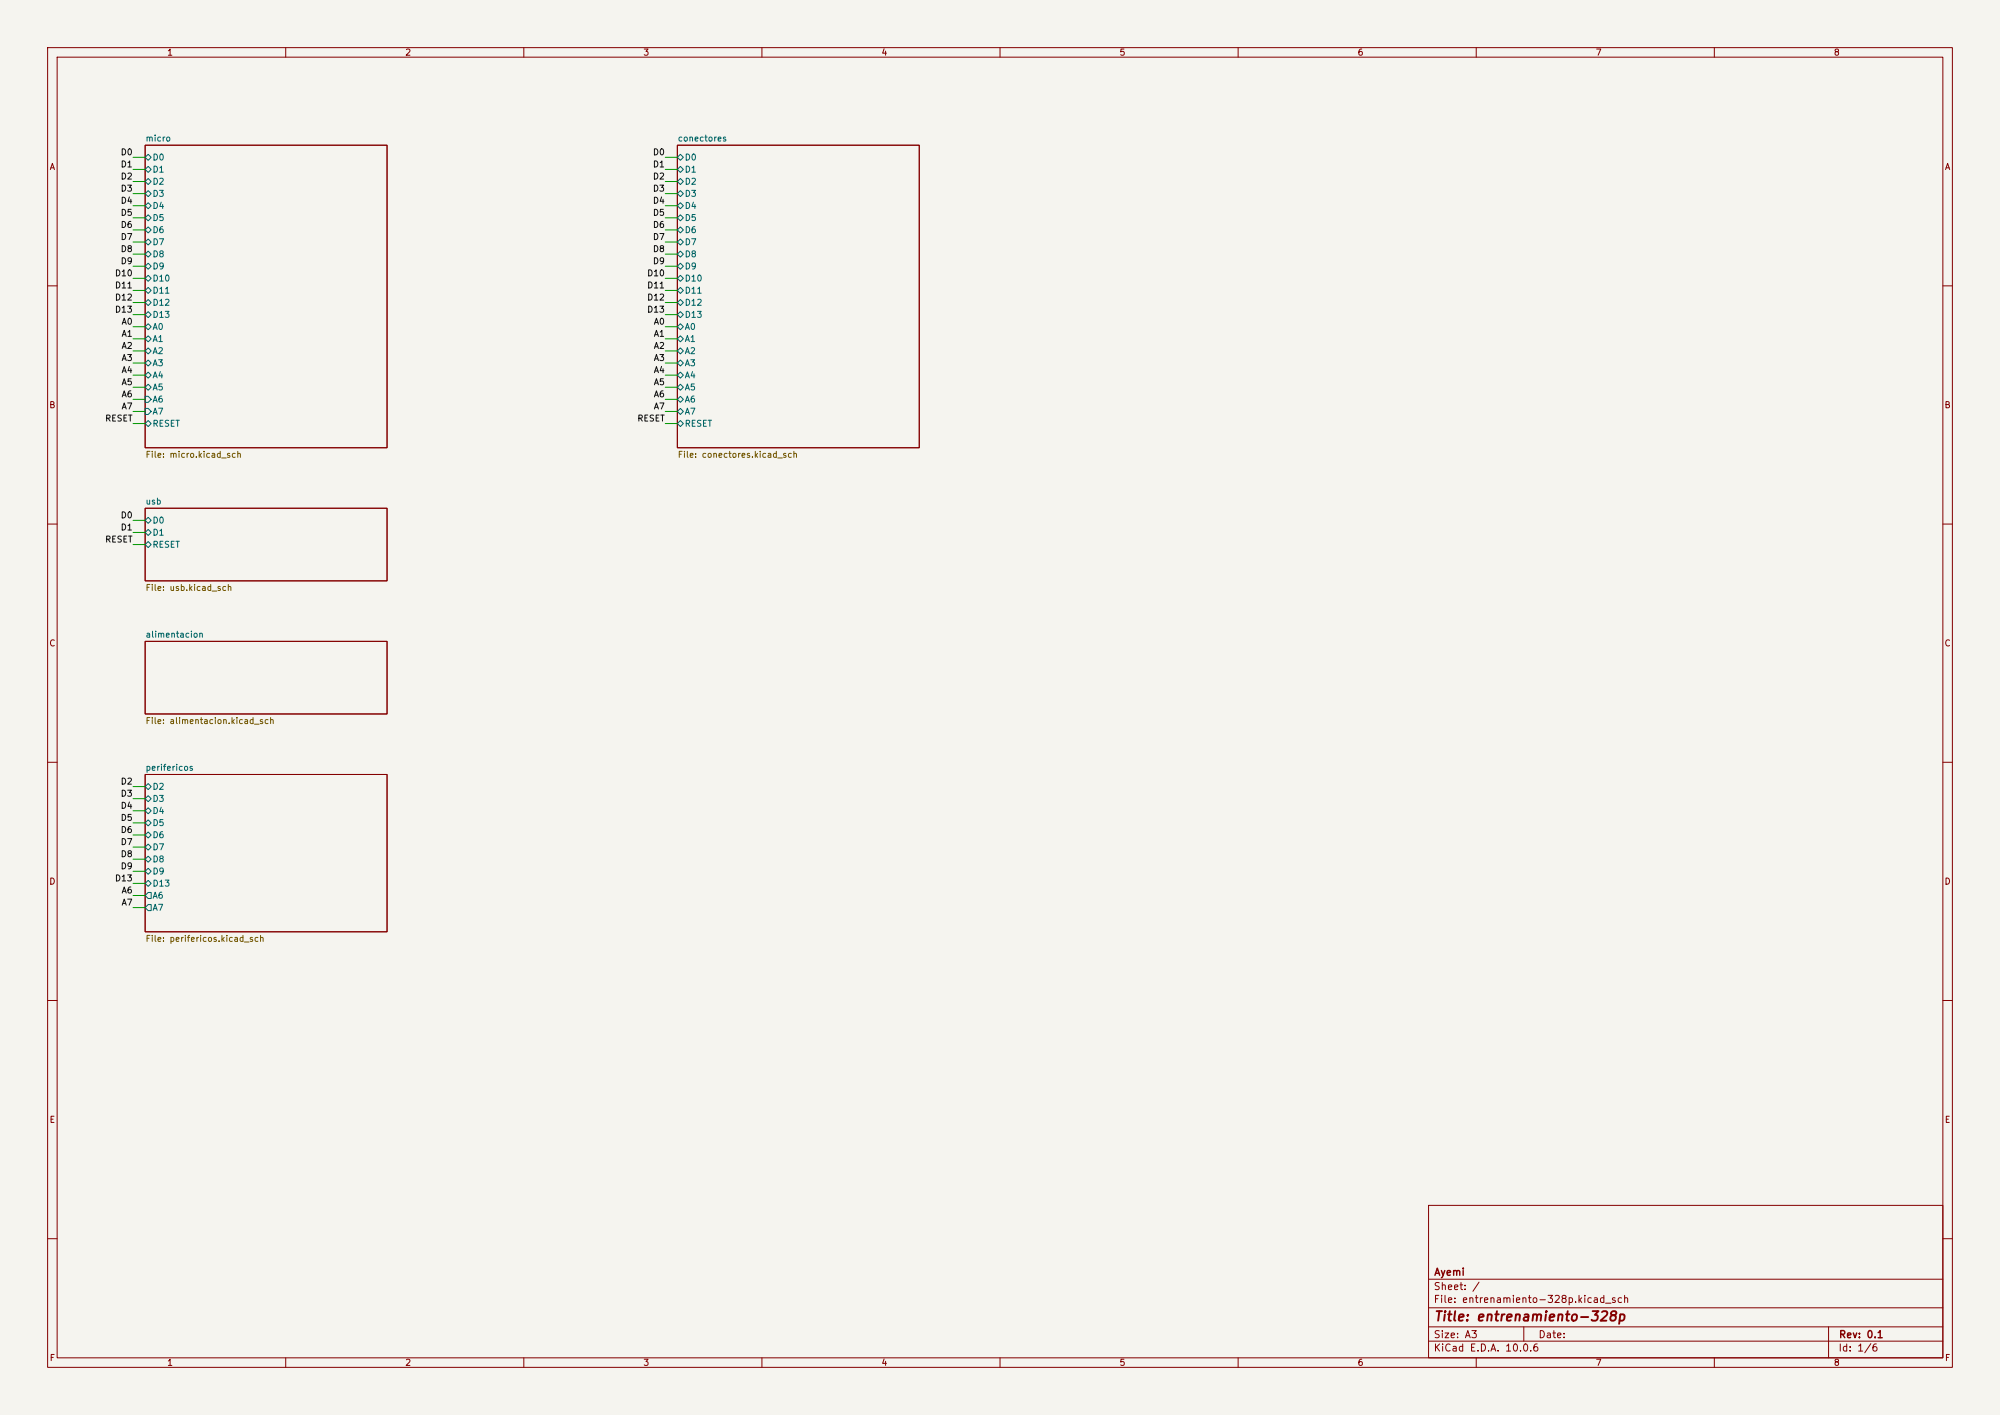
[picture p20: page 1]

Size: A3 | Rev: 0.1
KiCad E.D.A. 10.0.6 | Id: 1/6

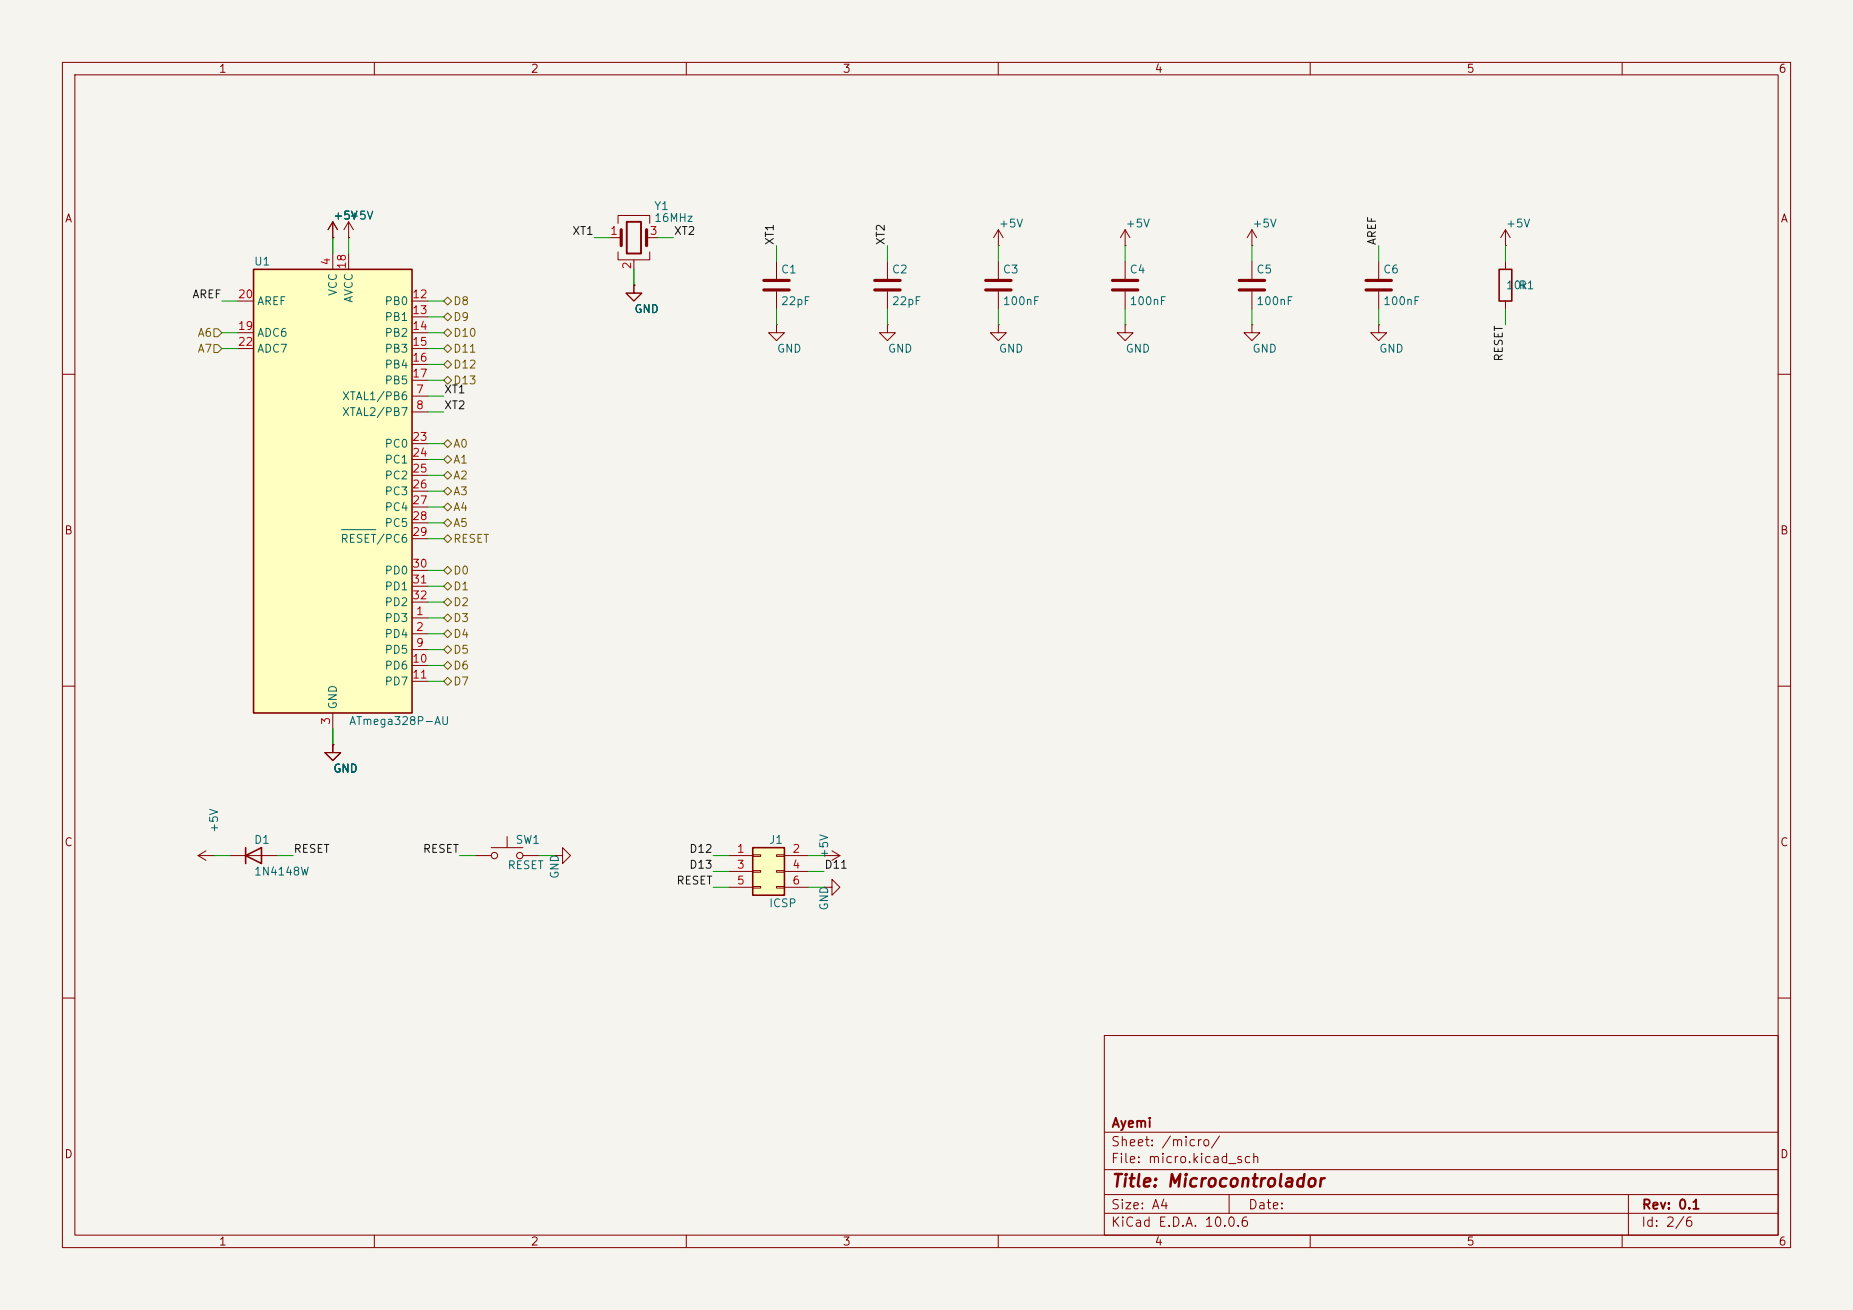
[picture p21: page 2]

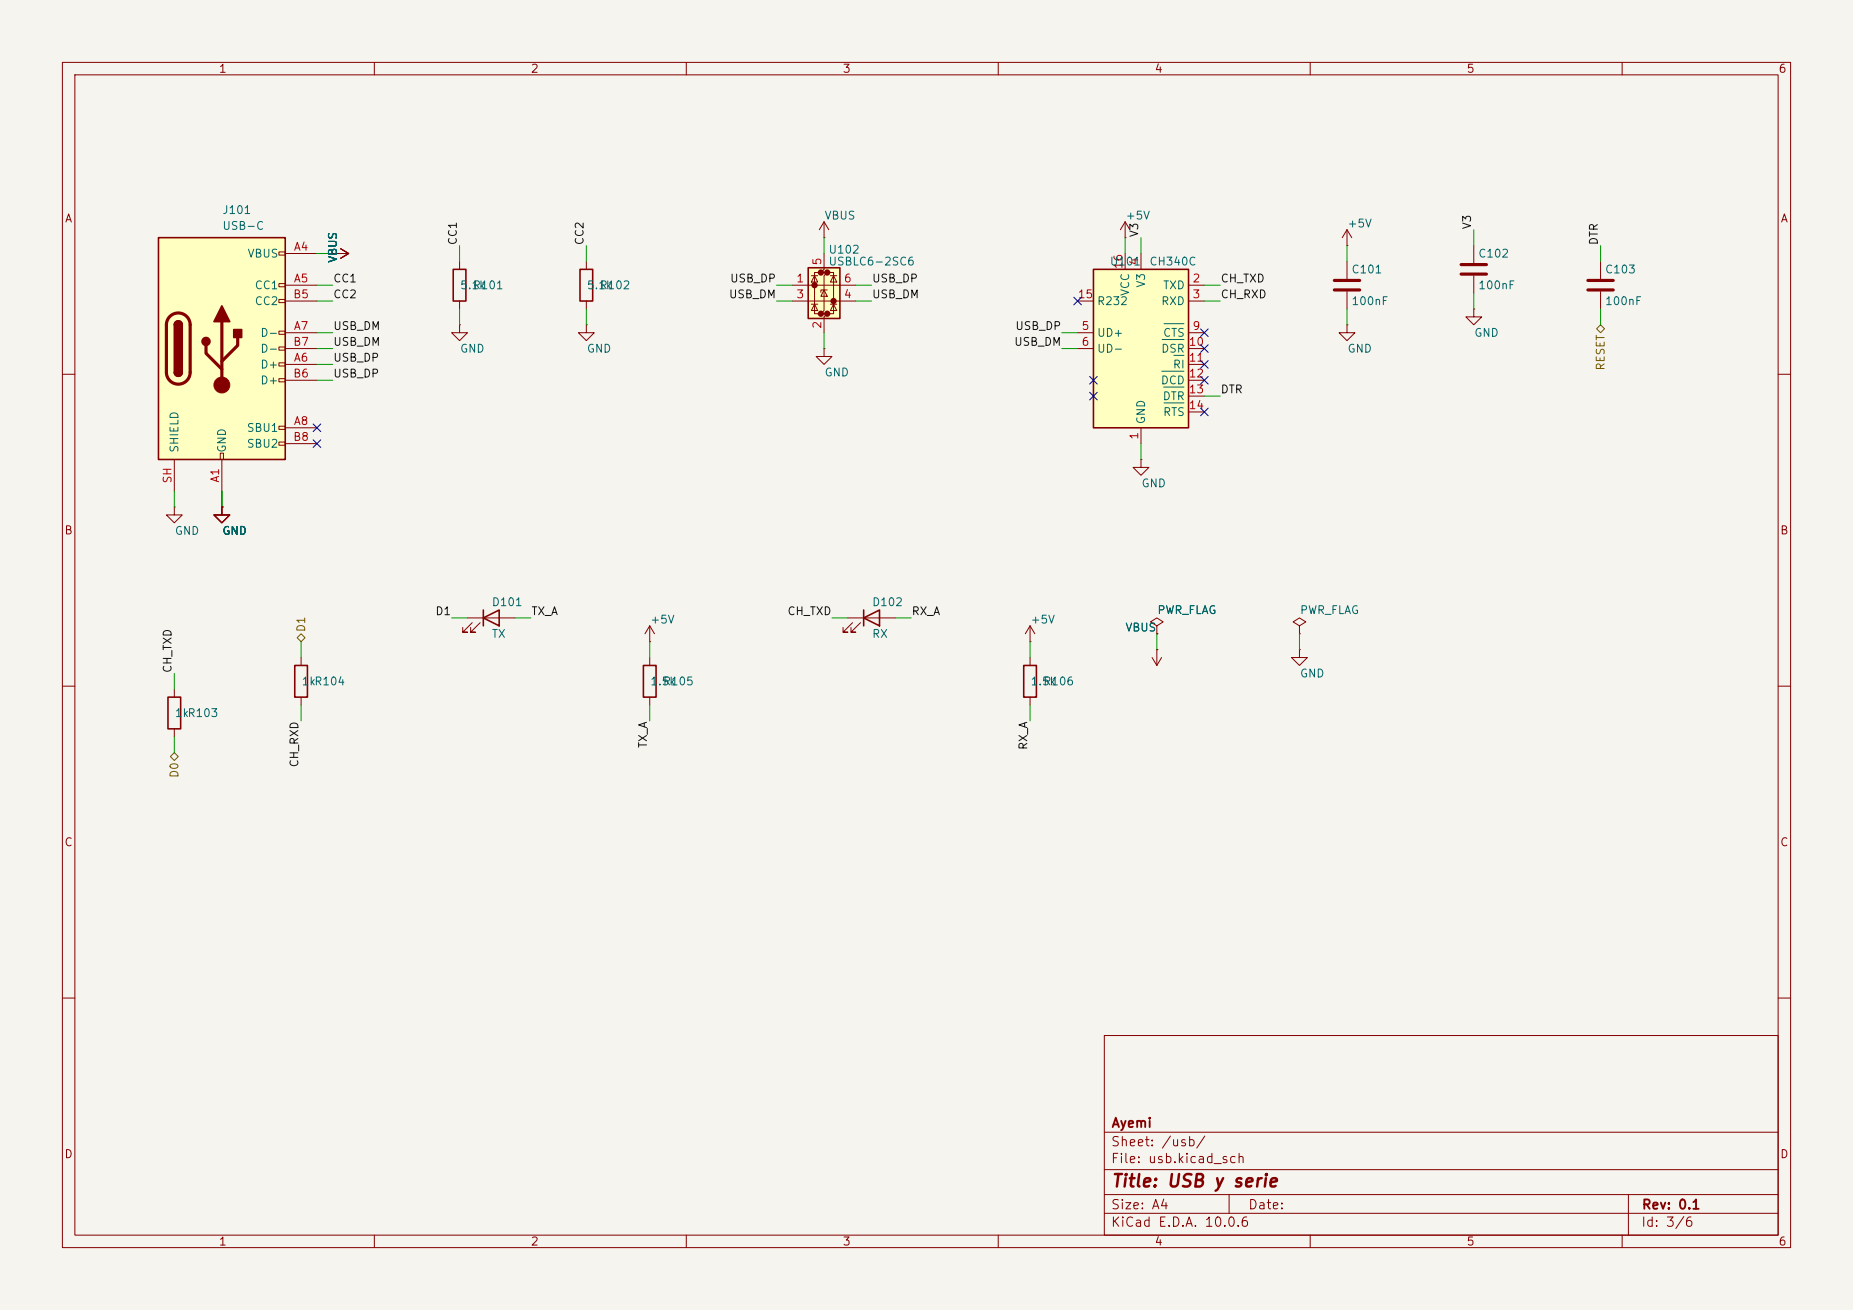
[picture p22: page 3]

4 UD+ 5 UD- 6 CTS 9 DSR 10 RI 11 DCD 12 DTR 13 RTS 14 R232 15 VCC U10116CH340C

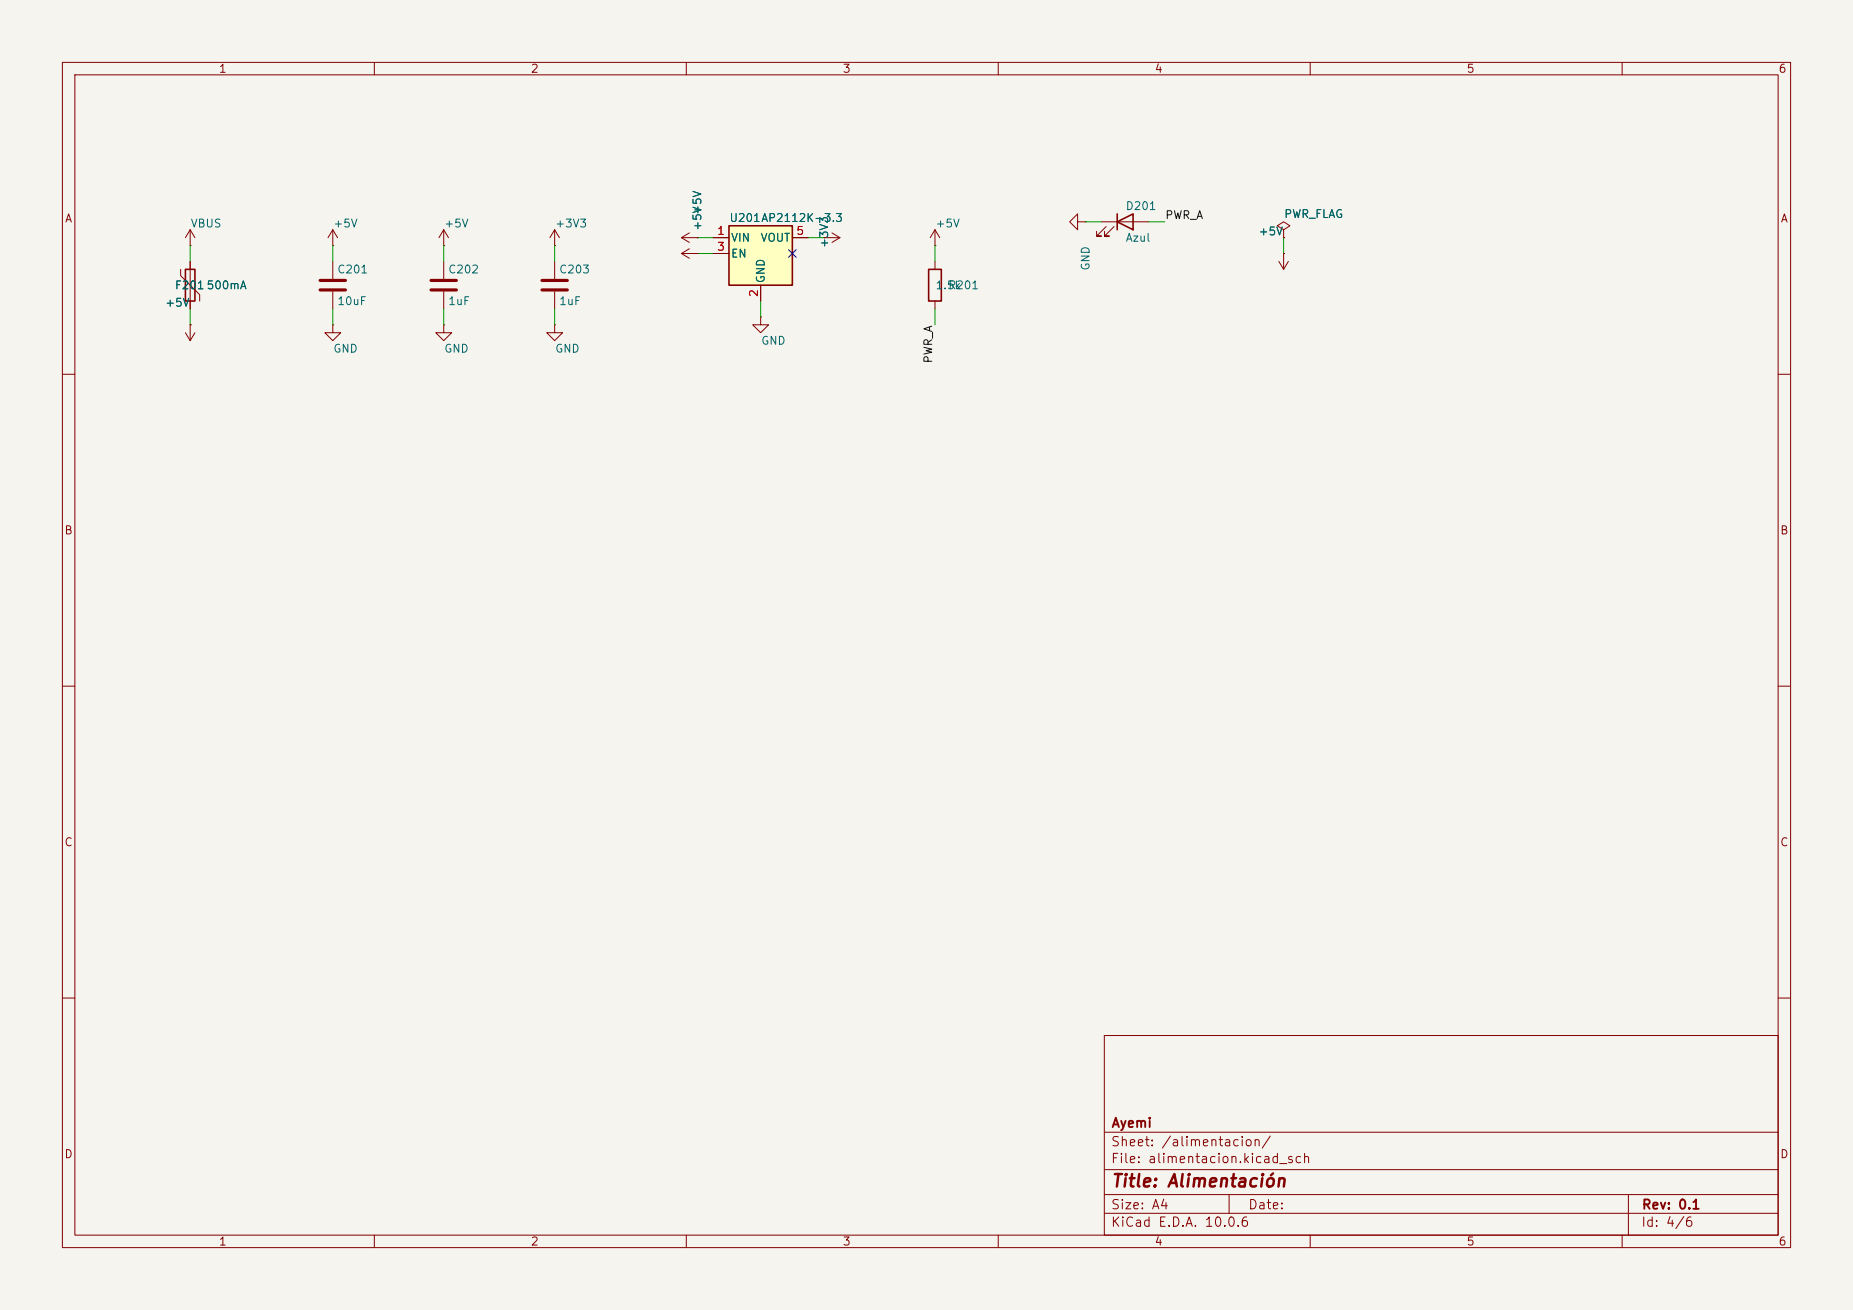
[picture p23: page 4]

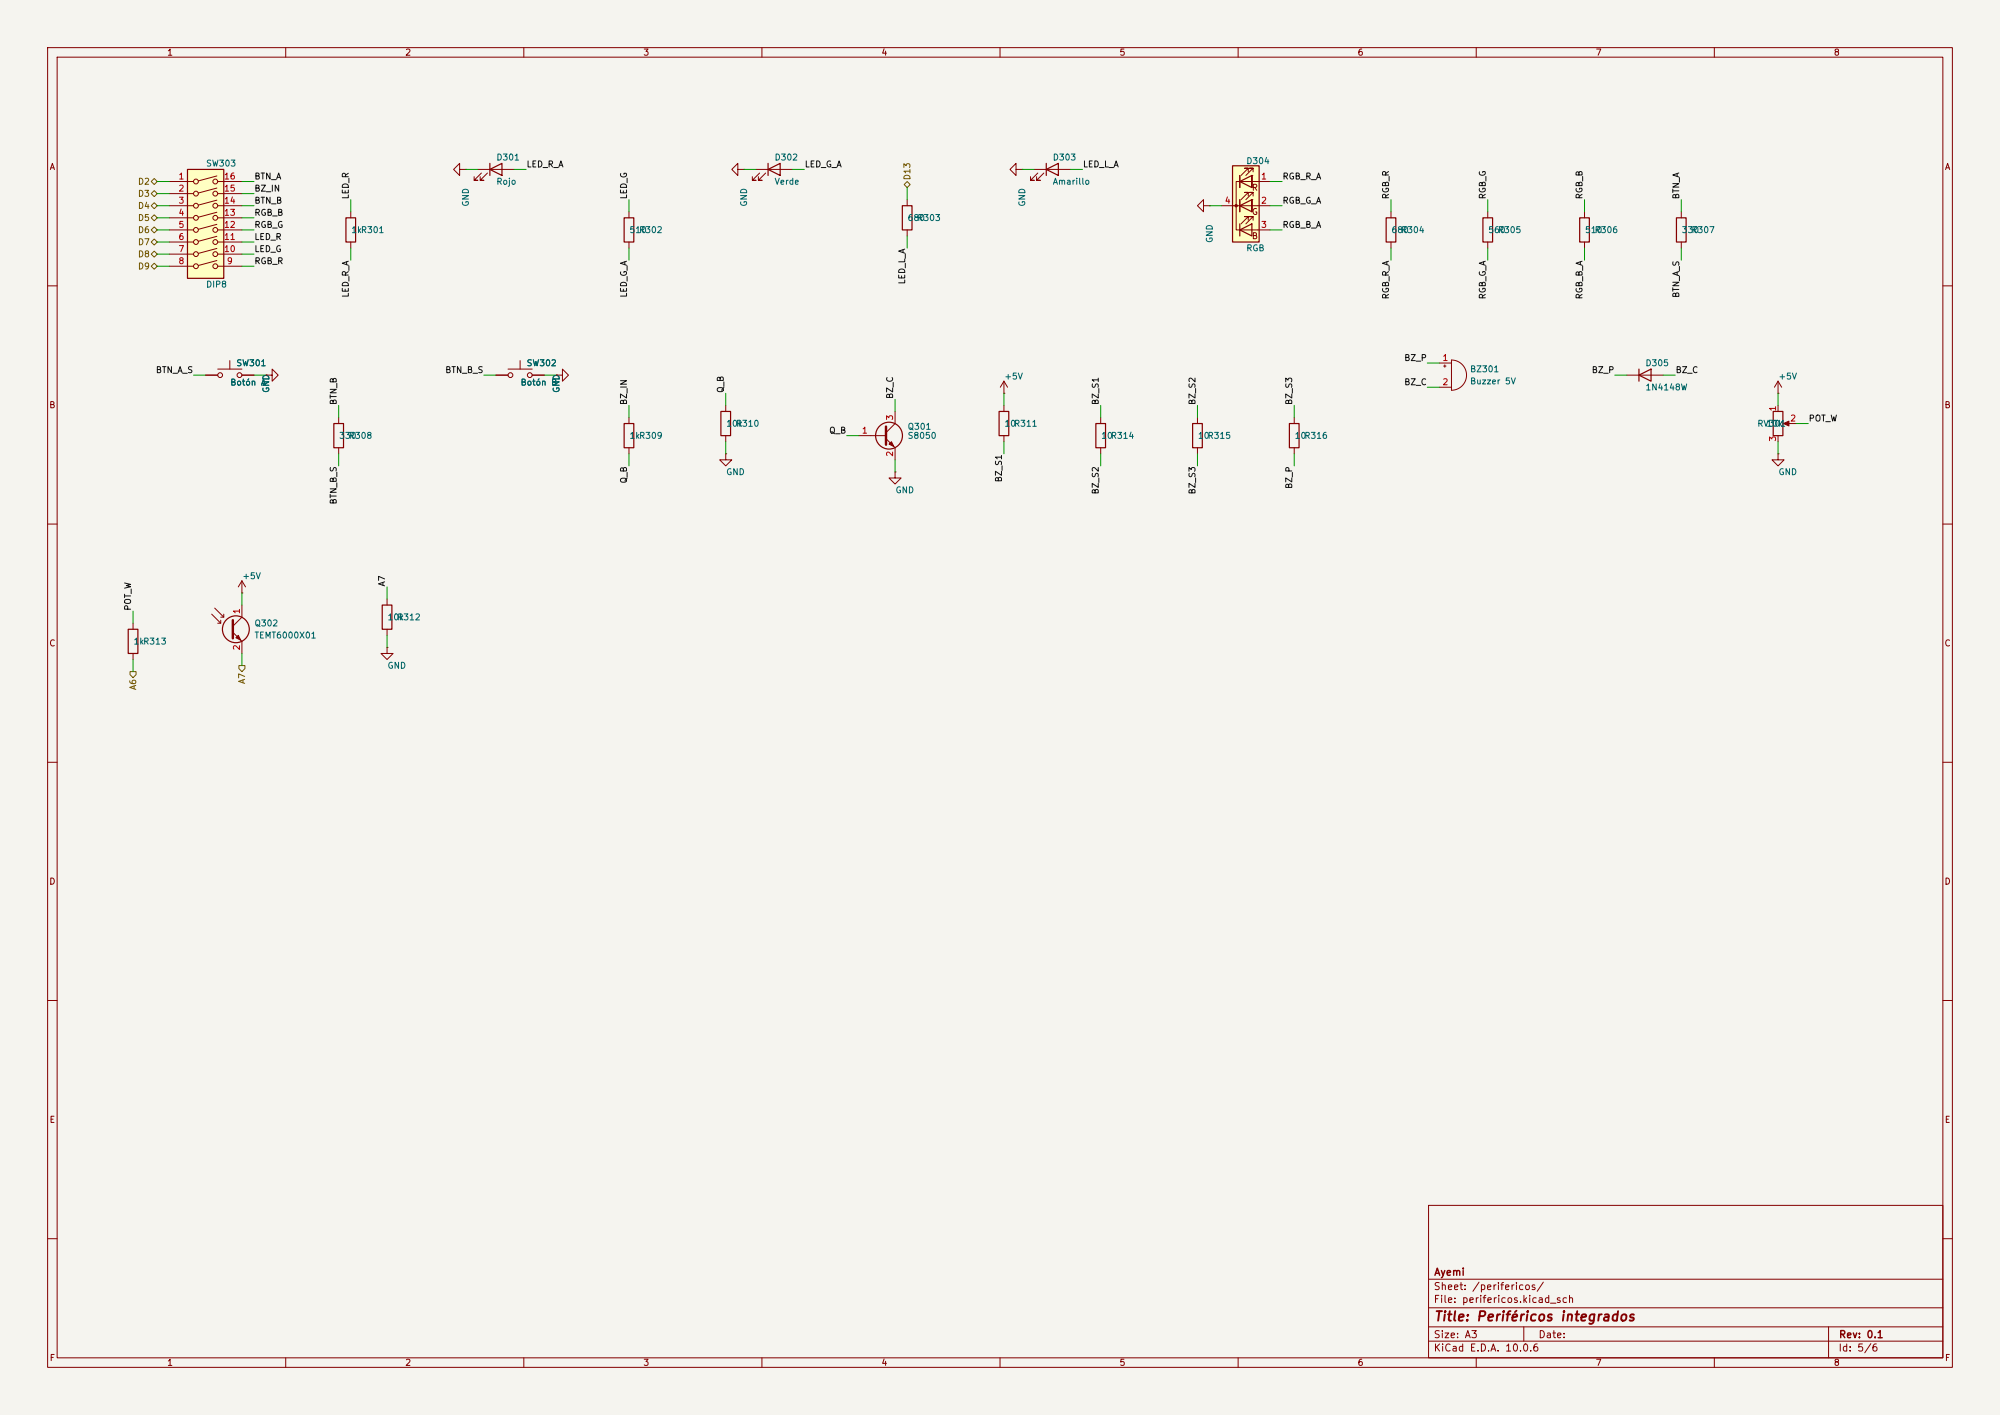
[picture p24: page 5]

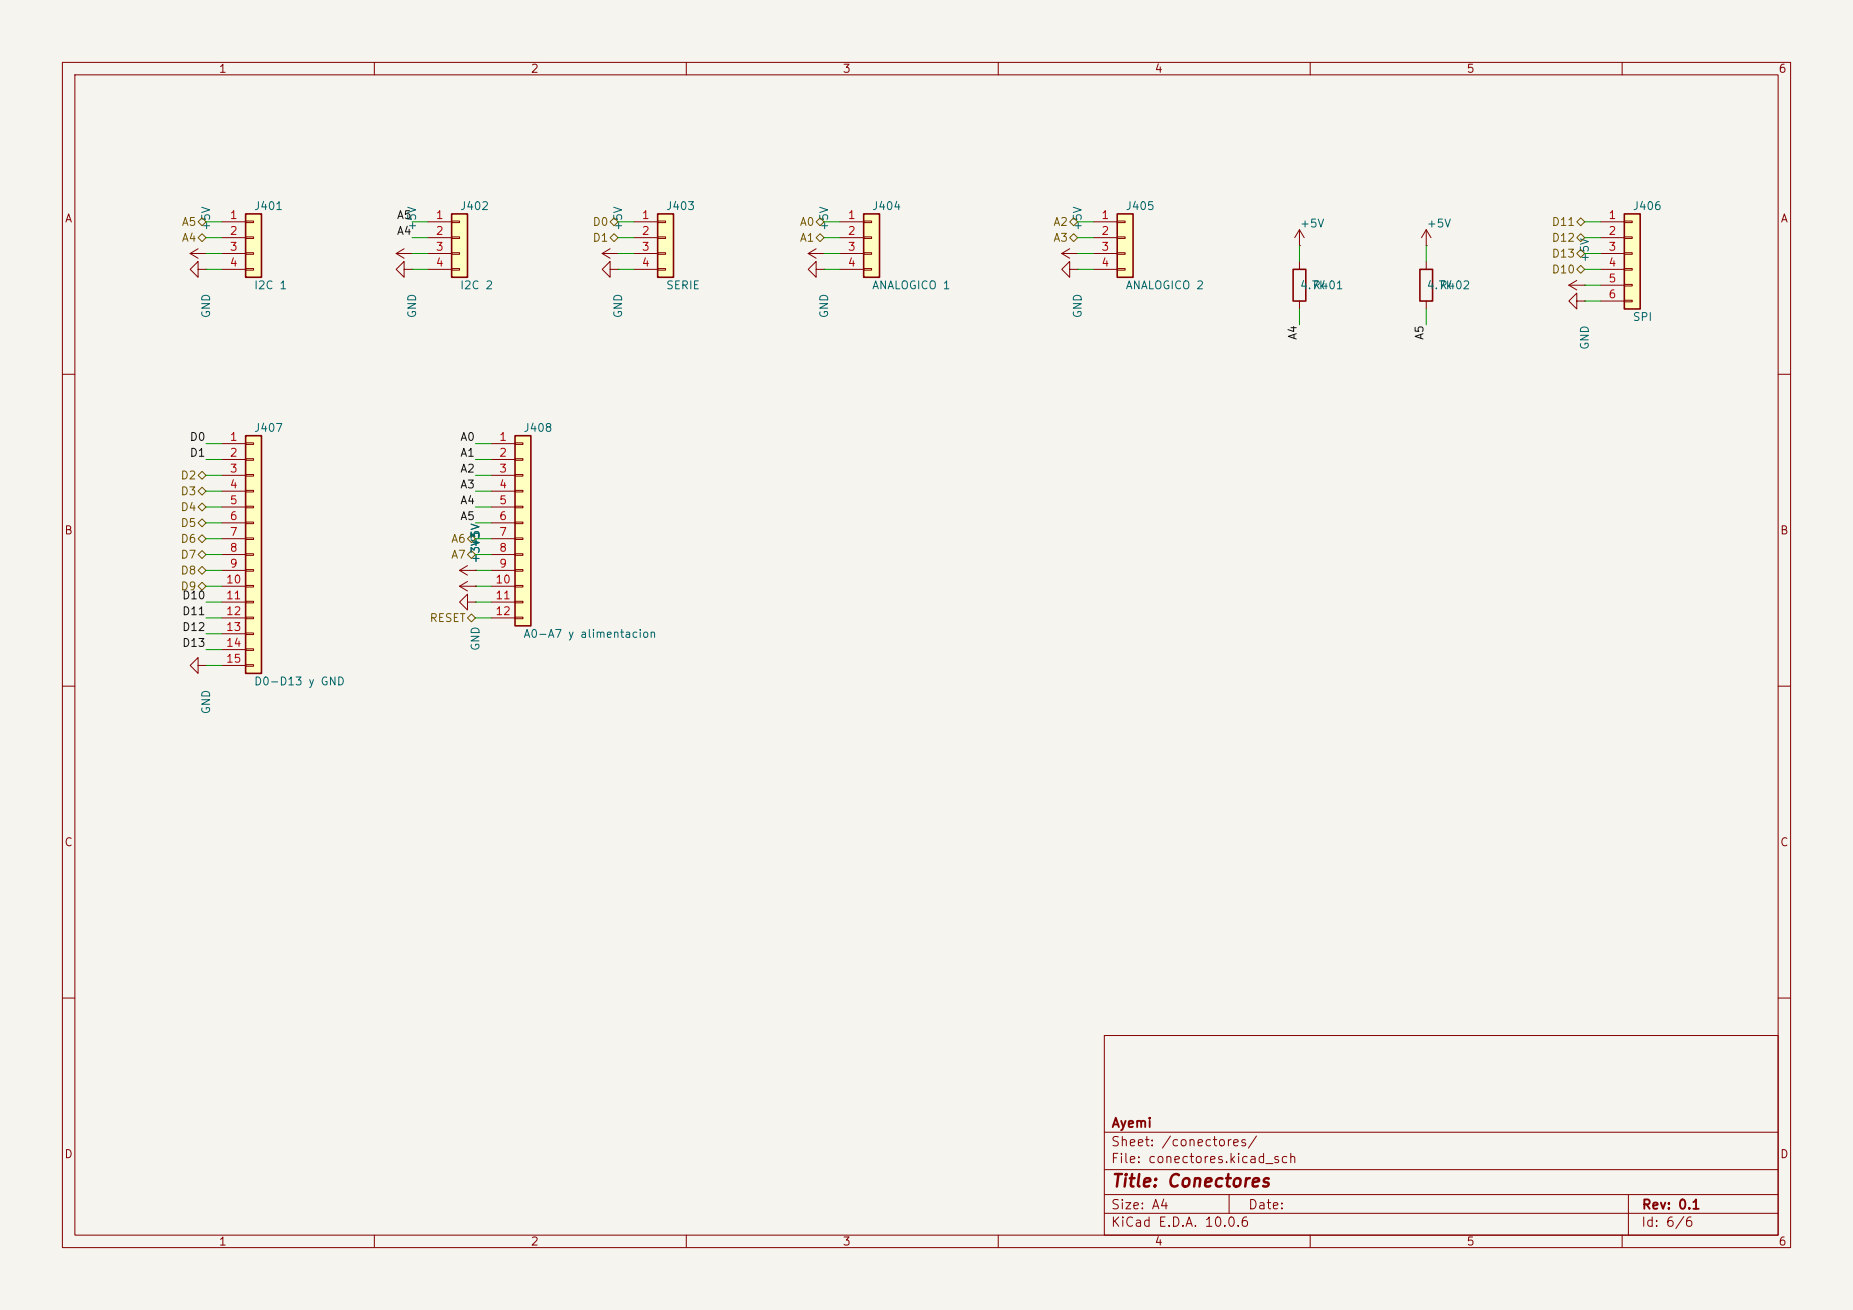
[picture p25: page 6]
