ayemi-dev/pcb-ayemi/placas/impulso-stm32/fab/v0.1/esquematico_v0.1.pdf

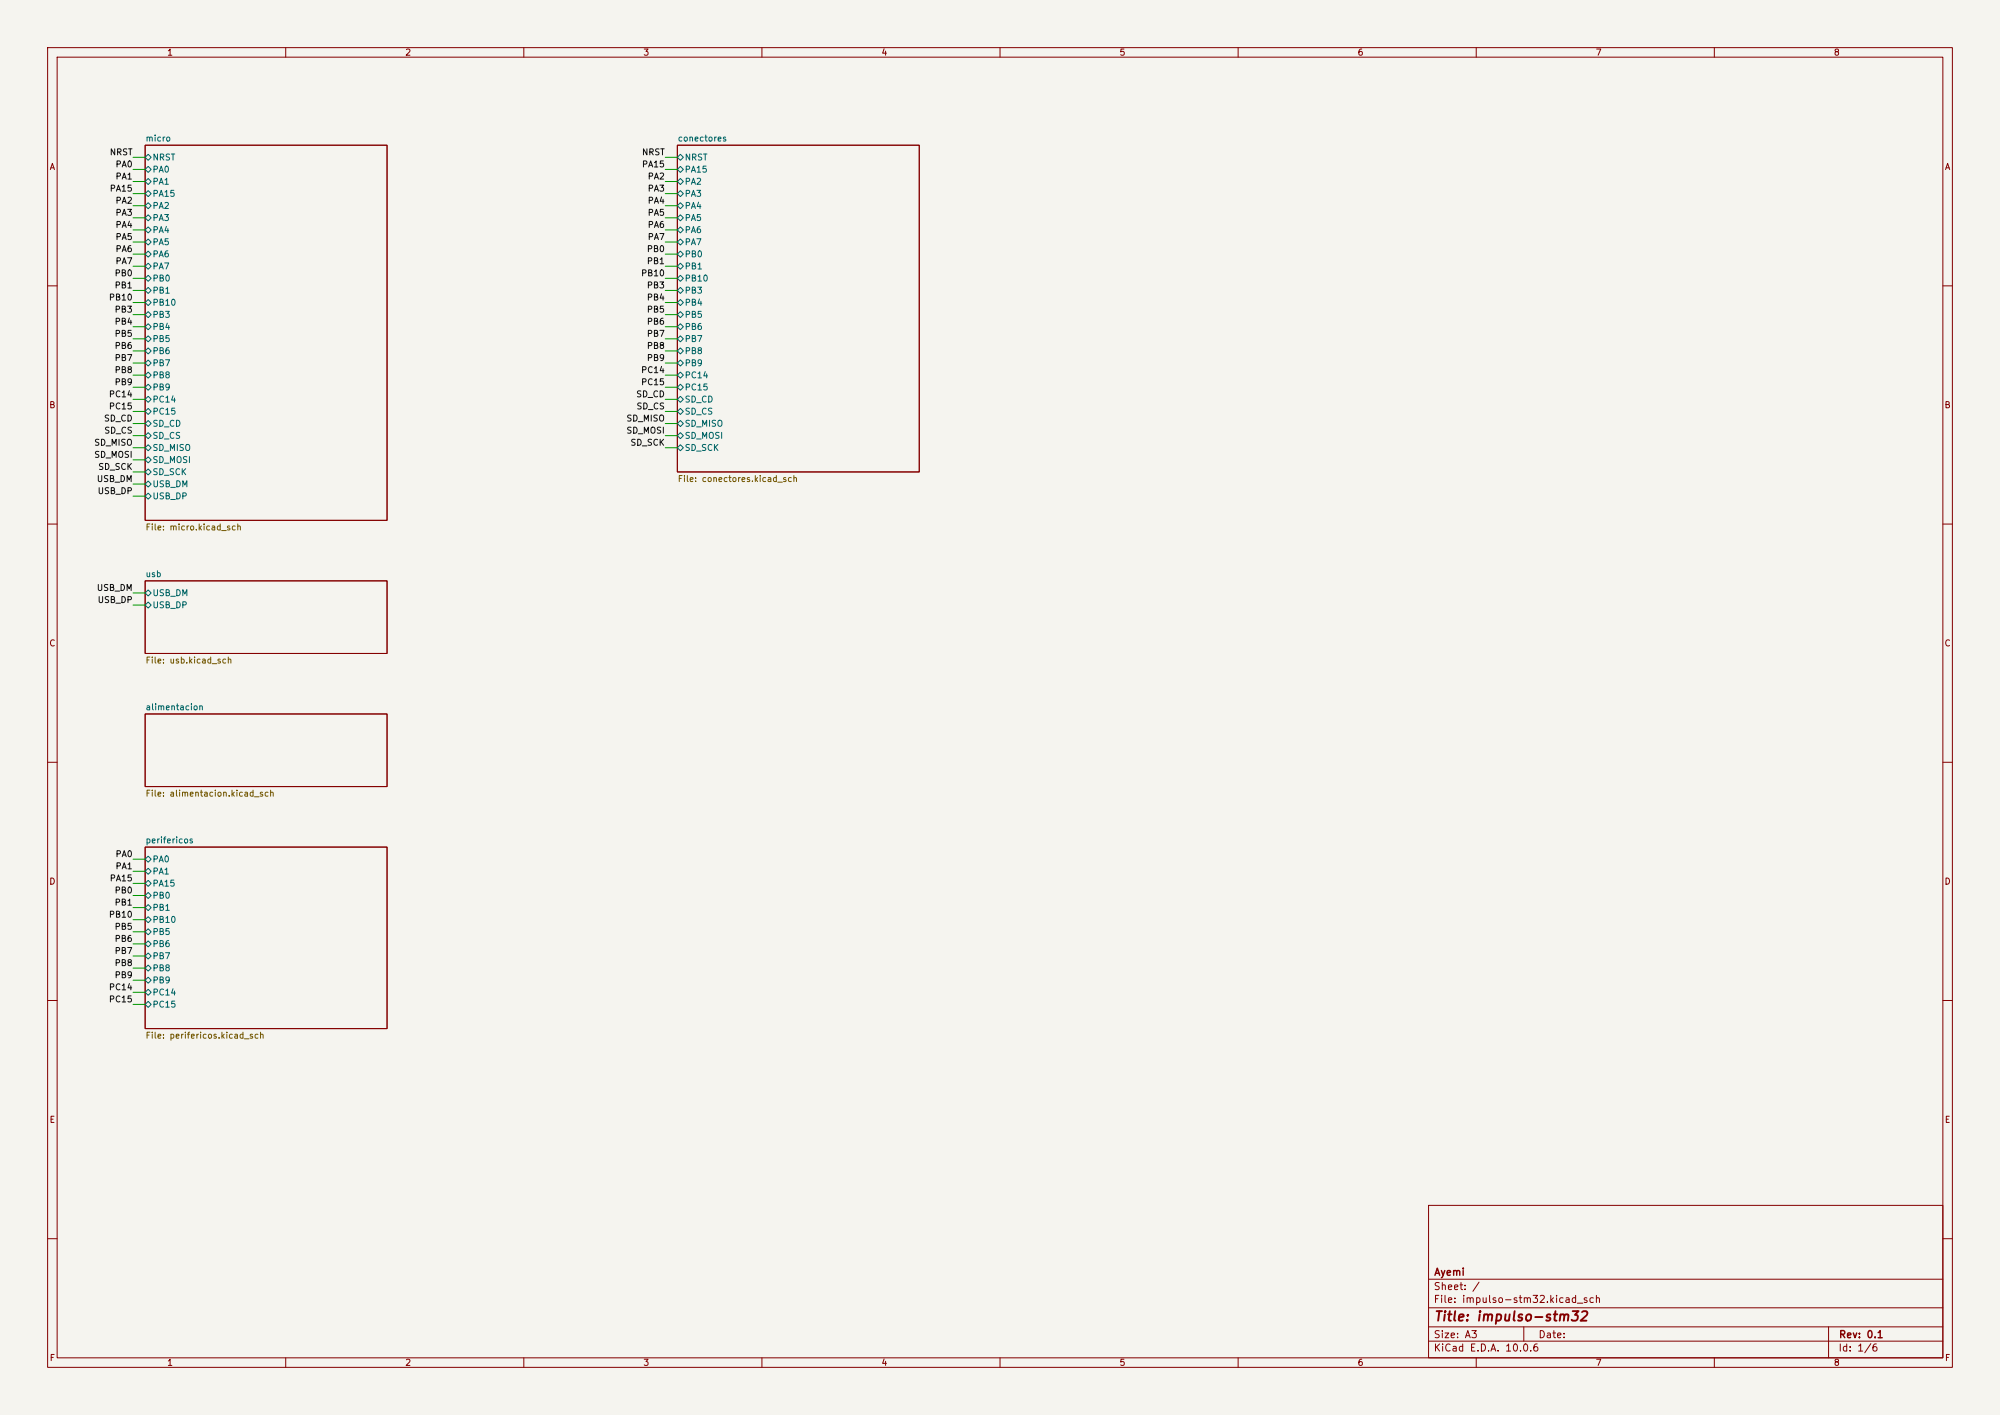
[picture p26: page 1]

Size: A3 | Rev: 0.1
KiCad E.D.A. 10.0.6 | Id: 1/6

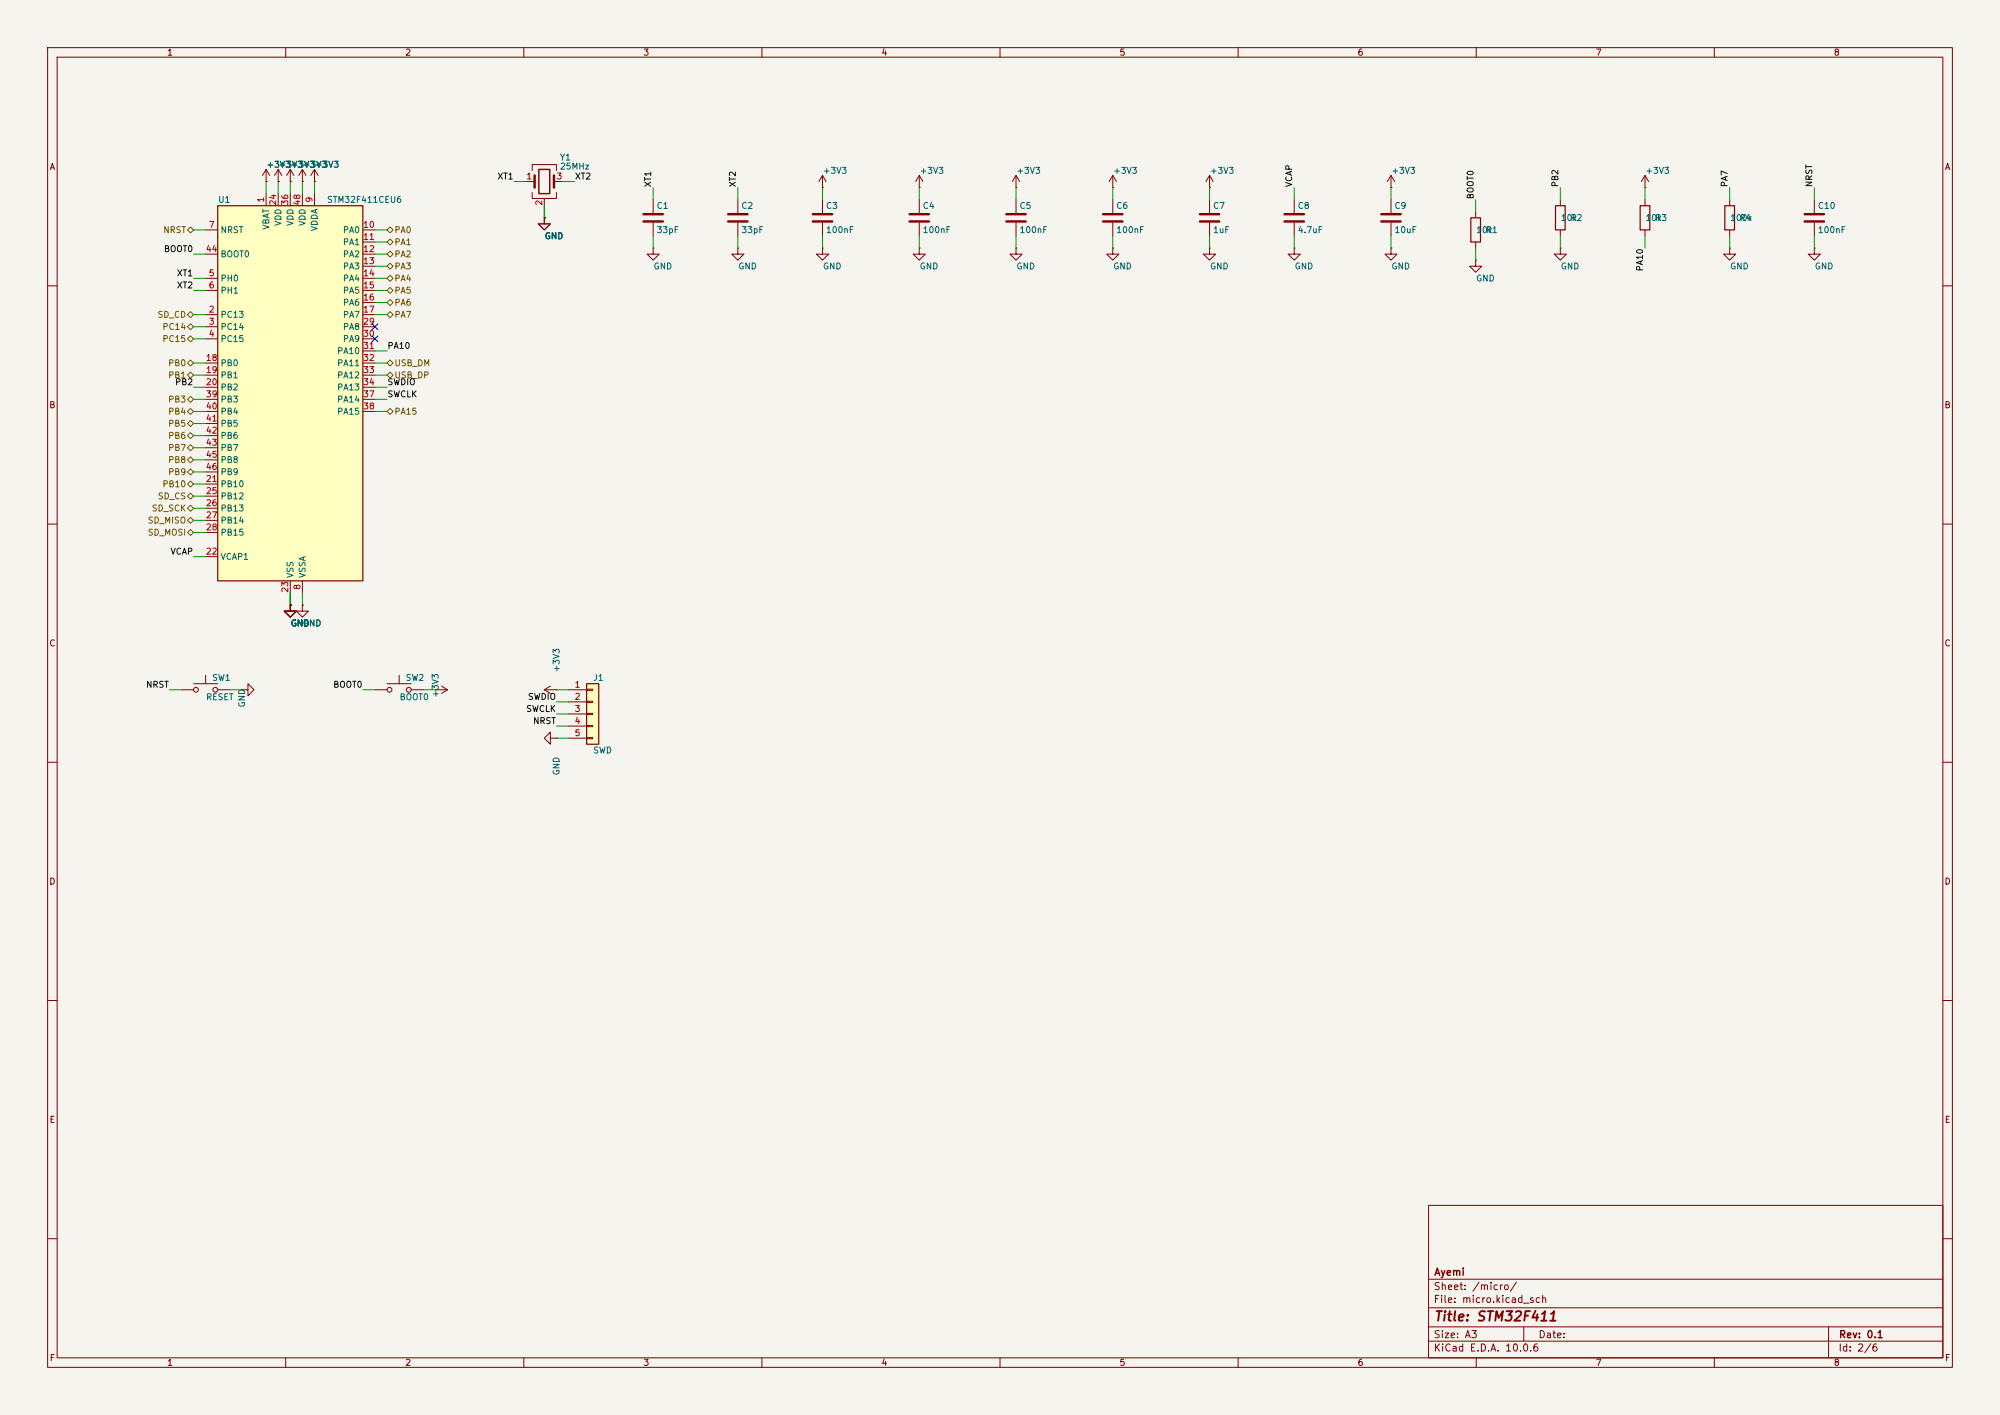
[picture p27: page 2]



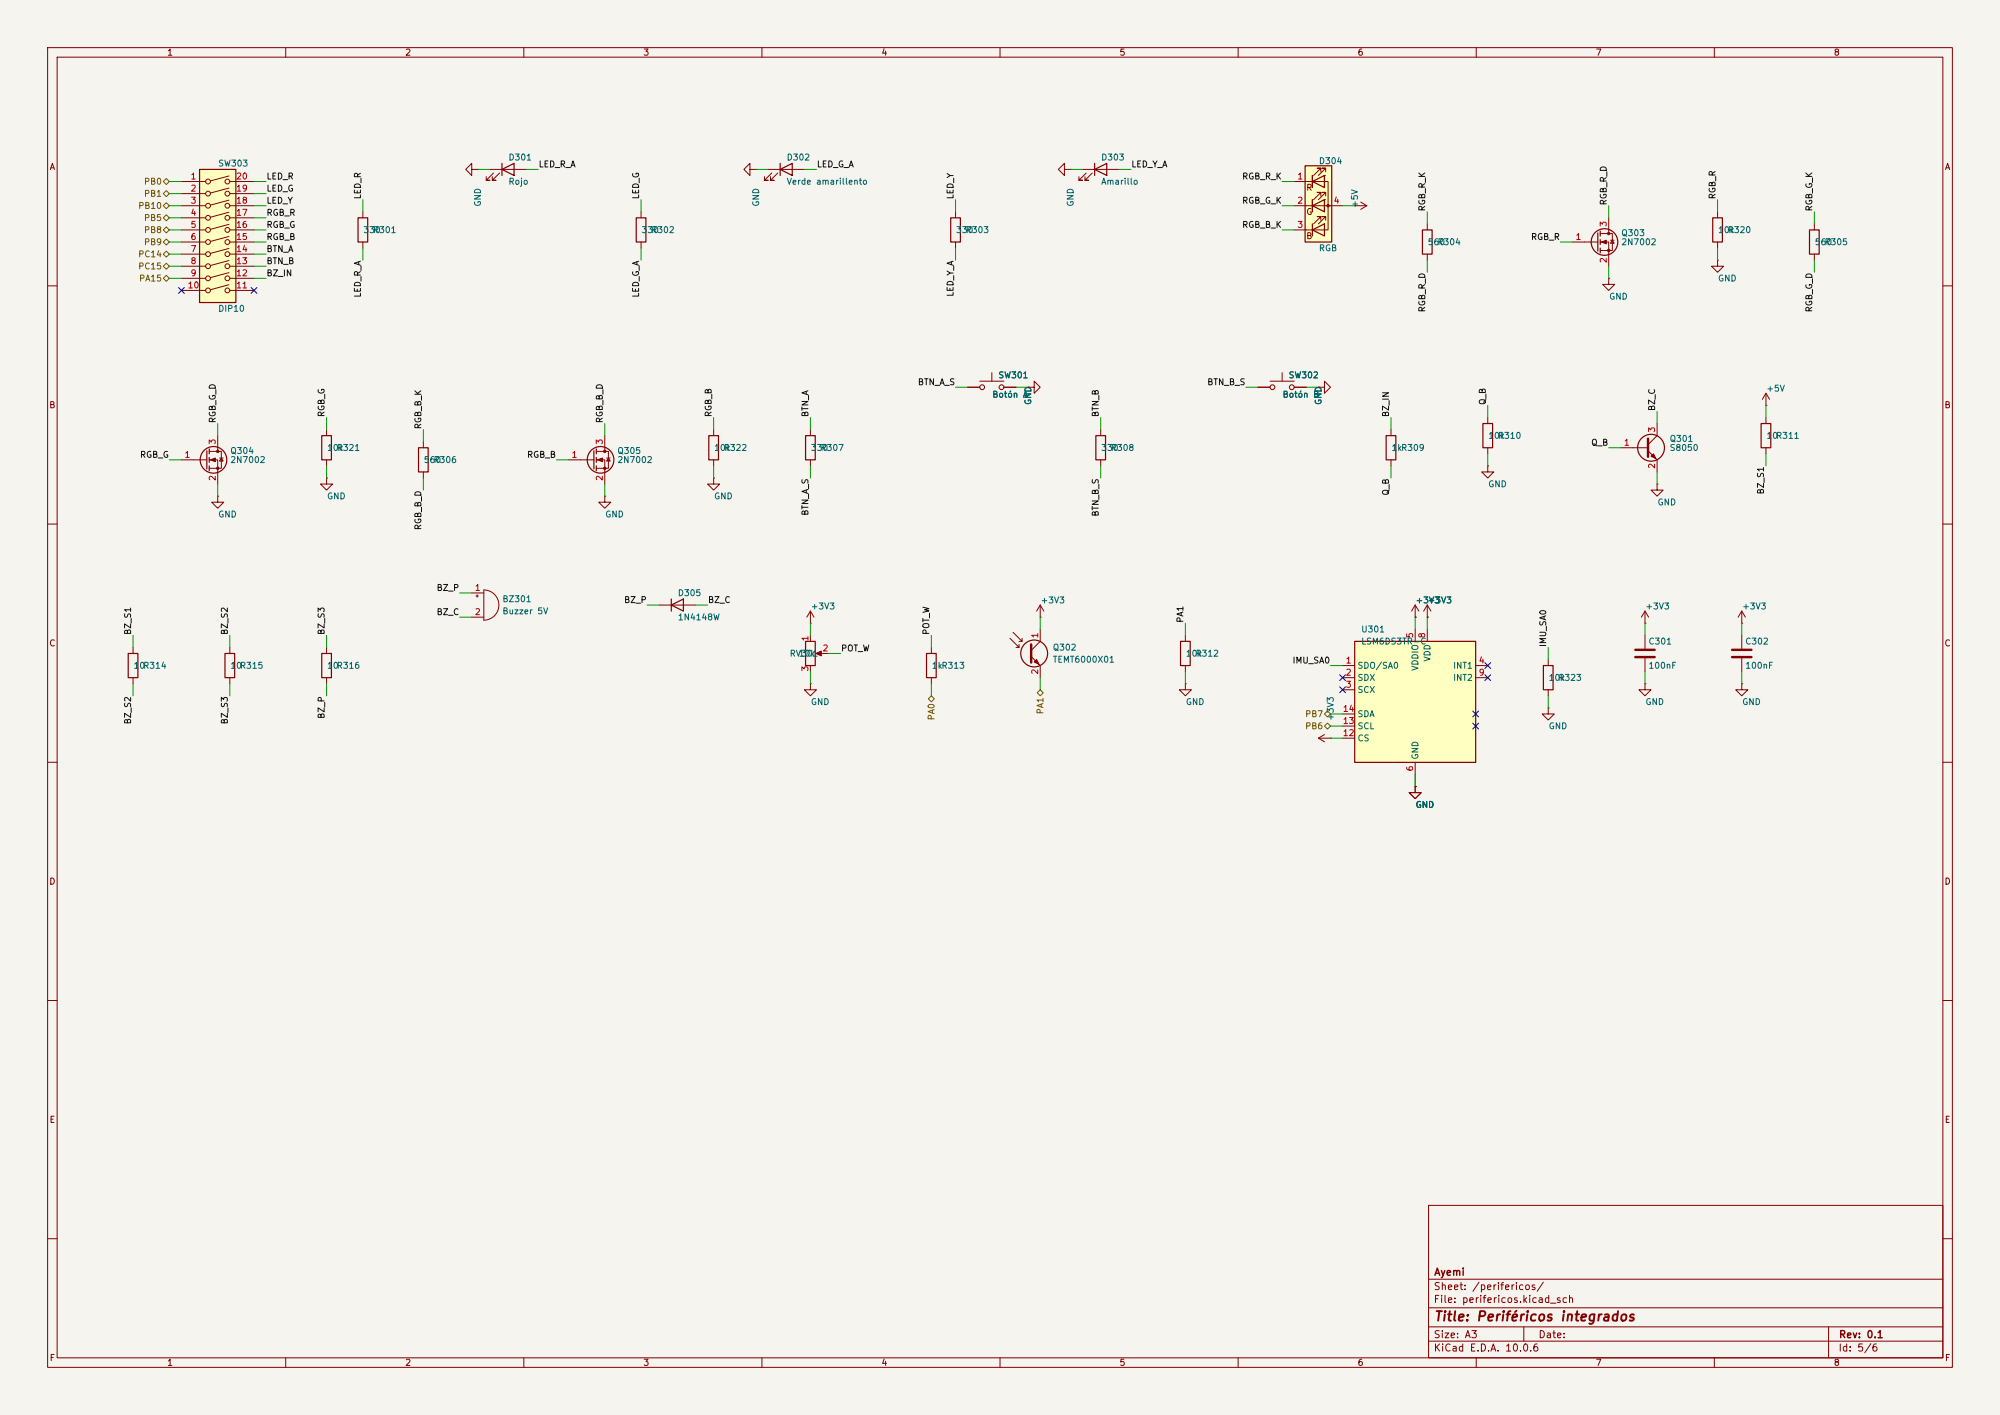
[picture p28: page 5]

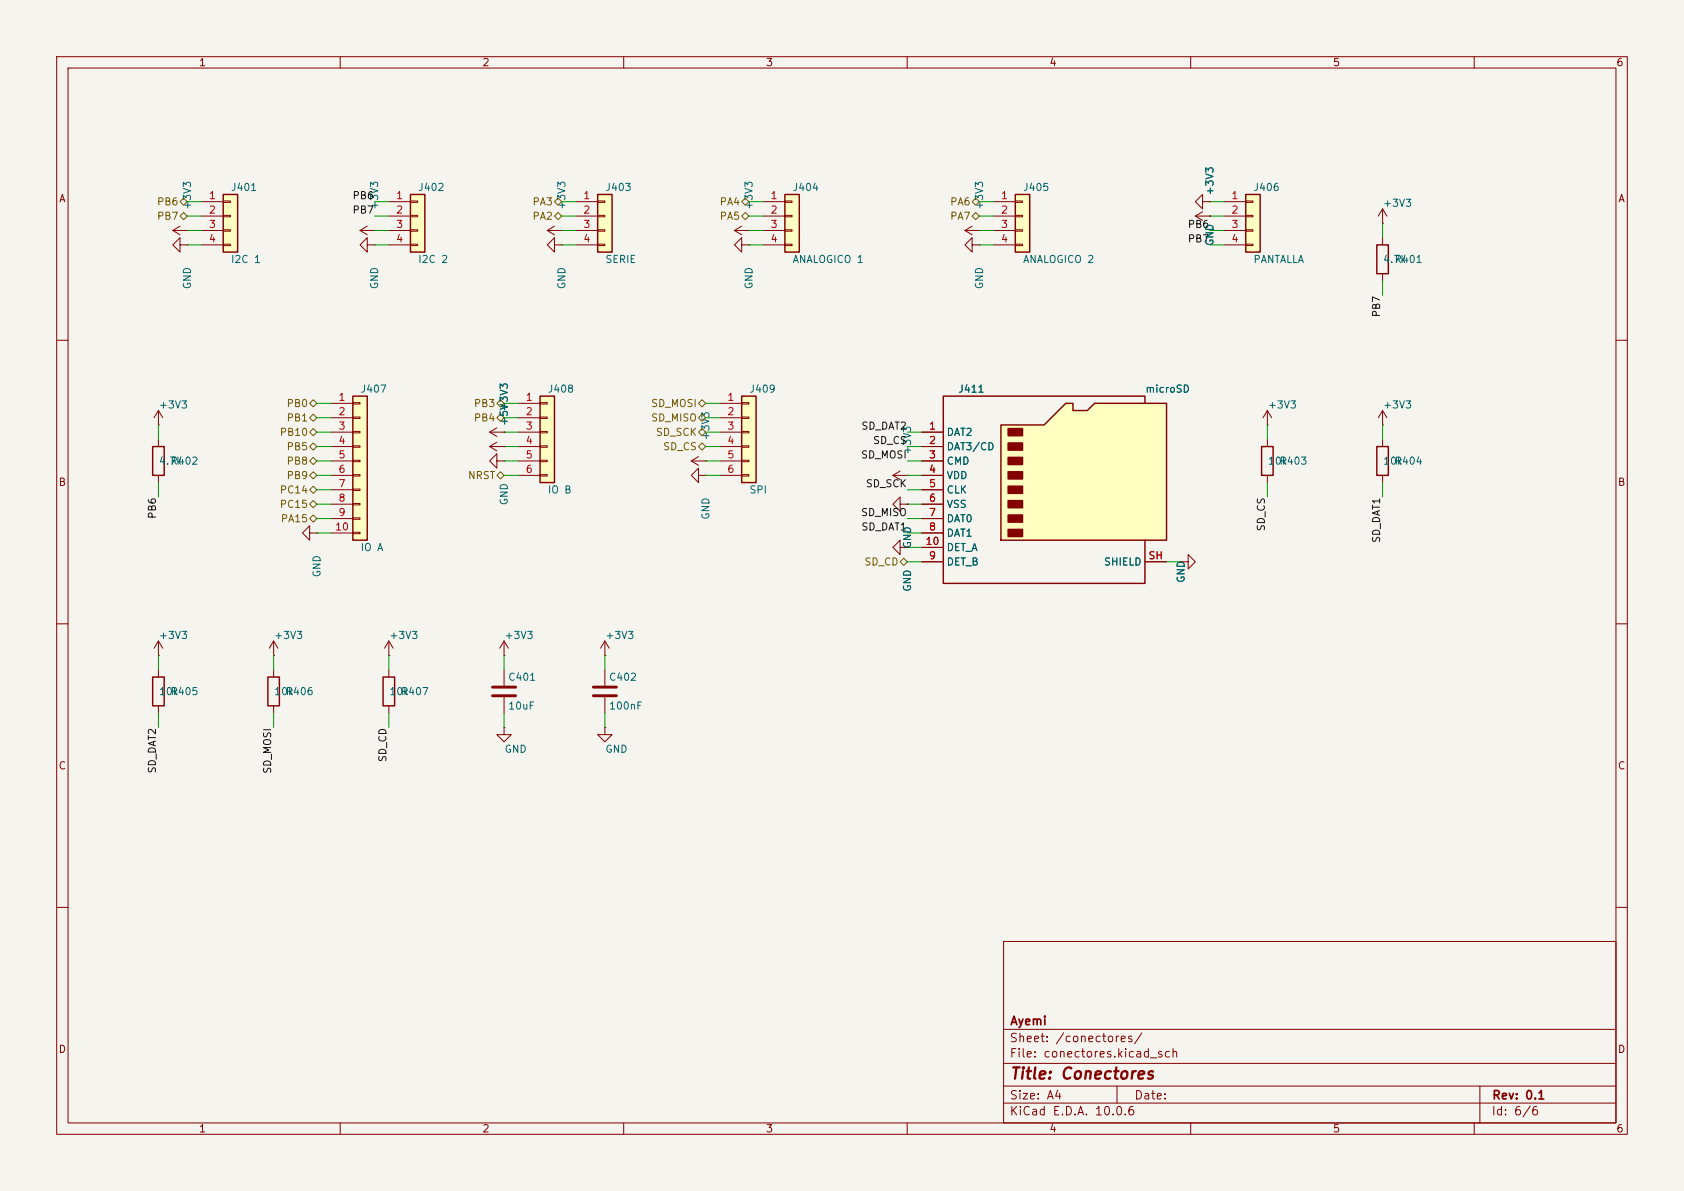
[picture p29: page 6]
