ayemi-dev/pcb-ayemi/placas/impulso-stm32/fab/v0.1/serigrafia_1a1_v0.1_superior.pdf

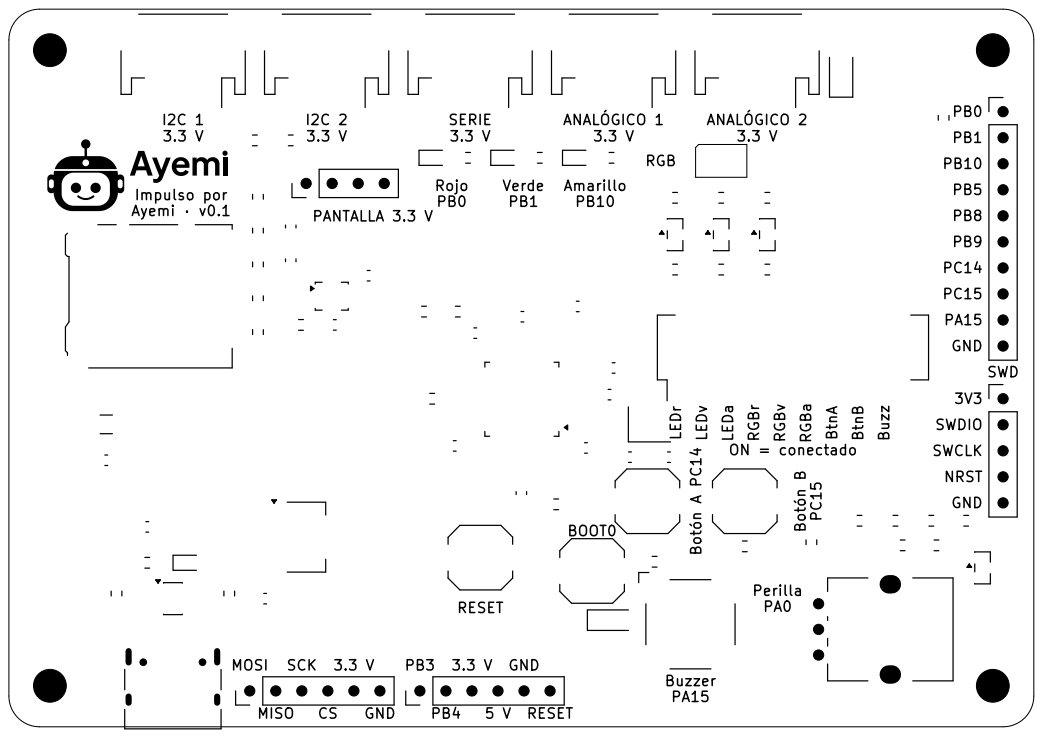
[picture p30: page 1]

SWCLK NRST GND LEDr Botón A PC14 LEDv LEDa RGBr RGBv Botón B RGBa PC15 BtnA BtnB Buzz
RESETBOOT0
