ayemi-dev/pcb-ayemi/placas/entrenamiento-328p/fab/v0.1/serigrafia_1a1_v0.1_inferior.pdf

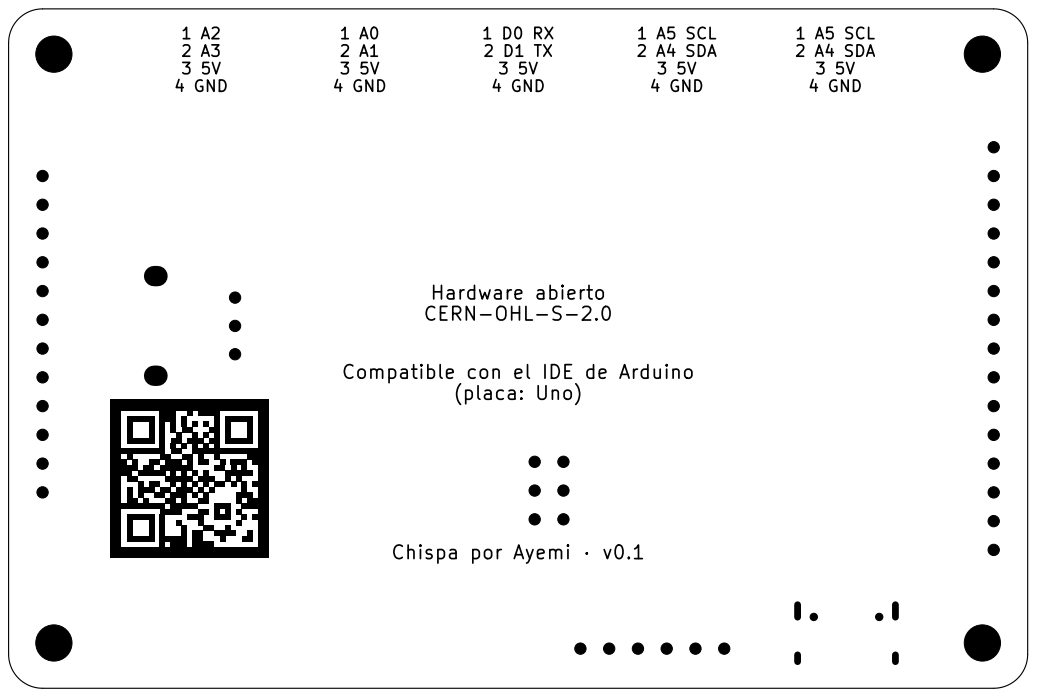
[picture p31: page 1]
