ayemi-dev/pcb-ayemi/placas/entrenamiento-328p/fab/v0.1/serigrafia_1a1_v0.1_superior.pdf

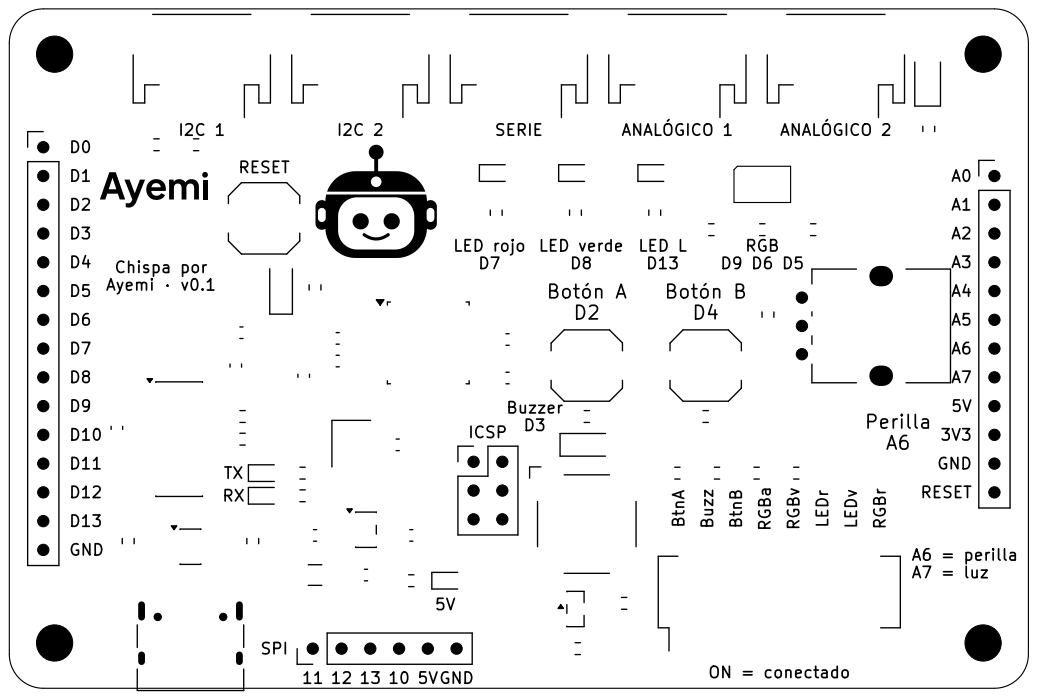
[picture p32: page 1]

A7 = luz Chispa por Ayemi · v0.1
