ayemi-dev/pcb-ayemi/placas/impulso-stm32/fab/v0.1/serigrafia_1a1_v0.1_inferior.pdf

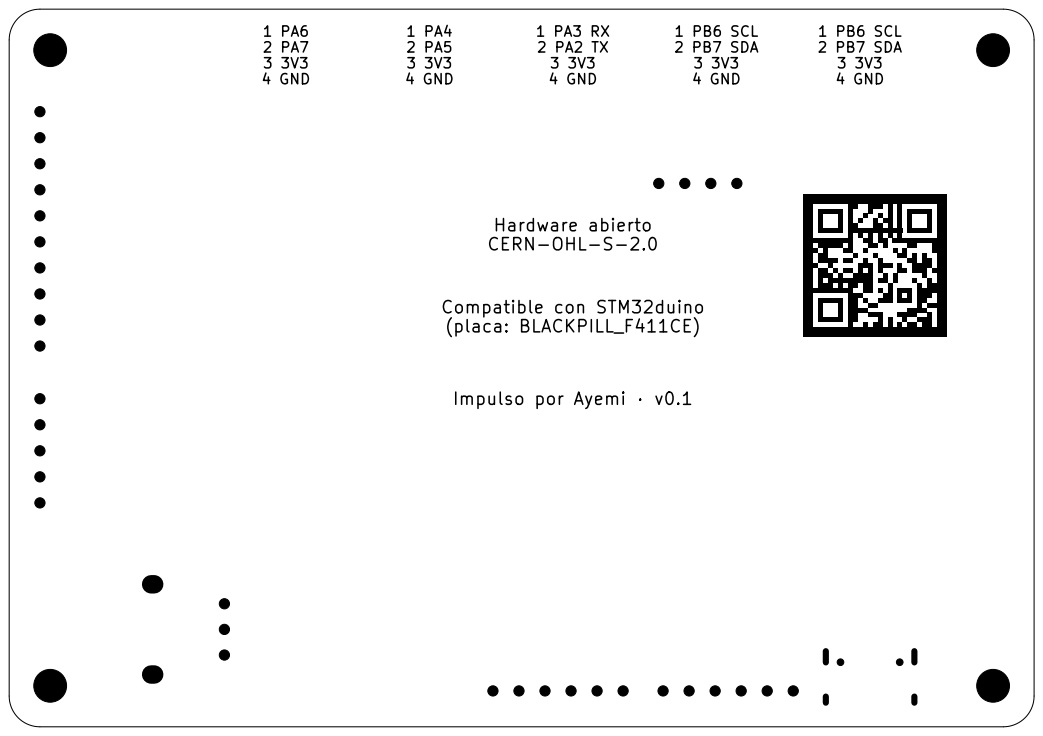
[picture p33: page 1]
