ayemi-dev/pcb-ayemi/placas/enlace-esp32s3/enlace-esp32s3.kicad_pcb

## KiCad design placas/enlace-esp32s3/enlace-esp32s3.kicad_pcb (2026-11-04)

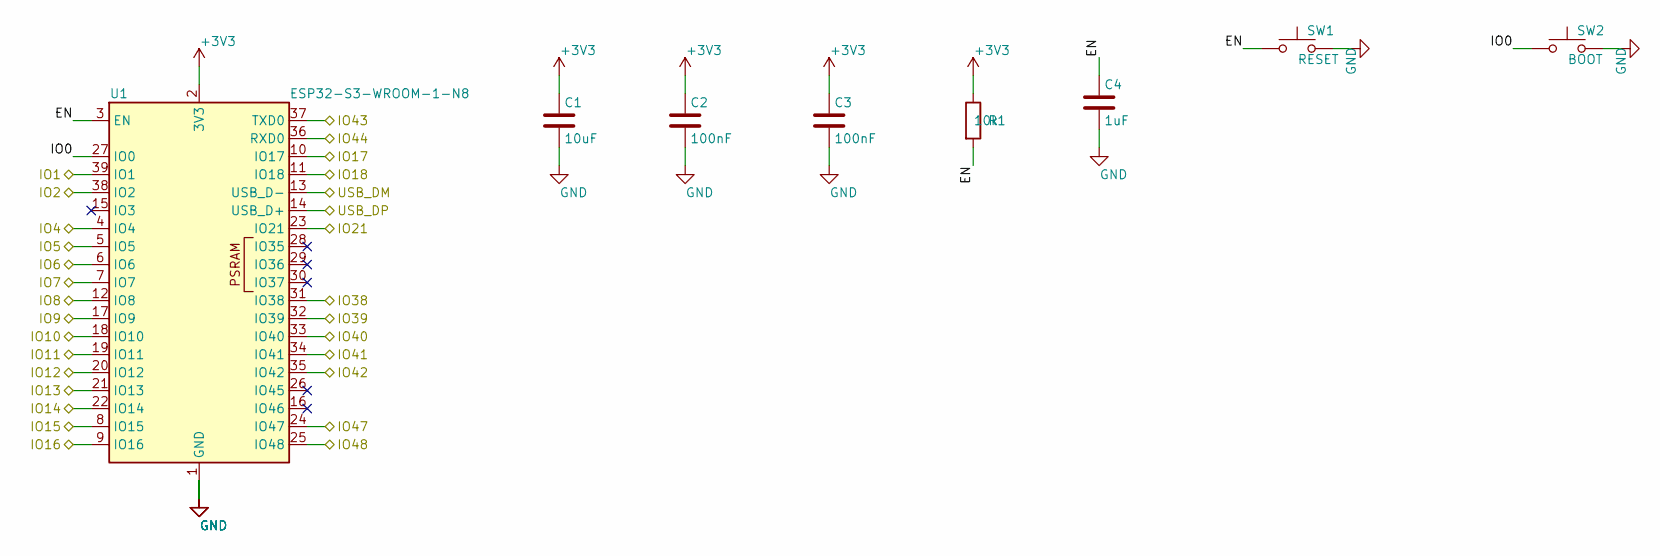
[picture p34: schematic micro.kicad_sch, Módulo ESP32-S3]

Parts:
C1: 10uF; C_0603_1608Metric; LCSC C19702
C2, C3: 100nF; C_0603_1608Metric; LCSC C14663
C4: 1uF; C_0603_1608Metric; LCSC C15849
R1: 10k; R_0603_1608Metric; LCSC C25804
SW1: RESET; SW_Push_1TS009xxxx-xxxx-xxxx_6x6x5mm; LCSC C319409
SW2: BOOT; SW_Push_1TS009xxxx-xxxx-xxxx_6x6x5mm; LCSC C319409
U1: ESP32-S3-WROOM-1-N8; ESP32-S3-WROOM-1_ayemi; LCSC C2913198

Connections:
+3V3: C1.1, C2.1, C3.1, R1.1, U1.2 (3V3); also elsewhere on the board
/IO1: U1.39 (IO1); also elsewhere on the board
/IO2: U1.38 (IO2); also elsewhere on the board
/IO4: U1.4 (IO4); also elsewhere on the board
/IO5: U1.5 (IO5); also elsewhere on the board
/IO6: U1.6 (IO6); also elsewhere on the board
/IO7: U1.7 (IO7); also elsewhere on the board
/IO8: U1.12 (IO8); also elsewhere on the board
/IO9: U1.17 (IO9); also elsewhere on the board
/IO10: U1.18 (IO10); also elsewhere on the board
/IO11: U1.19 (IO11); also elsewhere on the board
/IO12: U1.20 (IO12); also elsewhere on the board
/IO13: U1.21 (IO13); also elsewhere on the board
/IO14: U1.22 (IO14); also elsewhere on the board
/IO15: U1.8 (IO15); also elsewhere on the board
/IO16: U1.9 (IO16); also elsewhere on the board
/IO17: U1.10 (IO17); also elsewhere on the board
/IO18: U1.11 (IO18); also elsewhere on the board
/IO21: U1.23 (IO21); also elsewhere on the board
/IO38: U1.31 (IO38); also elsewhere on the board
/IO39: U1.32 (IO39); also elsewhere on the board
/IO40: U1.33 (IO40); also elsewhere on the board
/IO41: U1.34 (IO41); also elsewhere on the board
/IO42: U1.35 (IO42); also elsewhere on the board
/IO43: U1.37 (TXD0); also elsewhere on the board
/IO44: U1.36 (RXD0); also elsewhere on the board
/IO47: U1.24 (IO47); also elsewhere on the board
/IO48: U1.25 (IO48); also elsewhere on the board
/USB_DM: U1.13 (USB_D-); also elsewhere on the board
/USB_DP: U1.14 (USB_D+); also elsewhere on the board
/micro/EN: C4.1, R1.2, SW1.1, U1.3 (EN)
/micro/IO0: SW2.1, U1.27 (IO0)
GND: C1.2, C2.2, C3.2, C4.2, SW1.2, SW2.2, U1.1 (GND), U1.40 (GND), U1.41 (GND); also elsewhere on the board

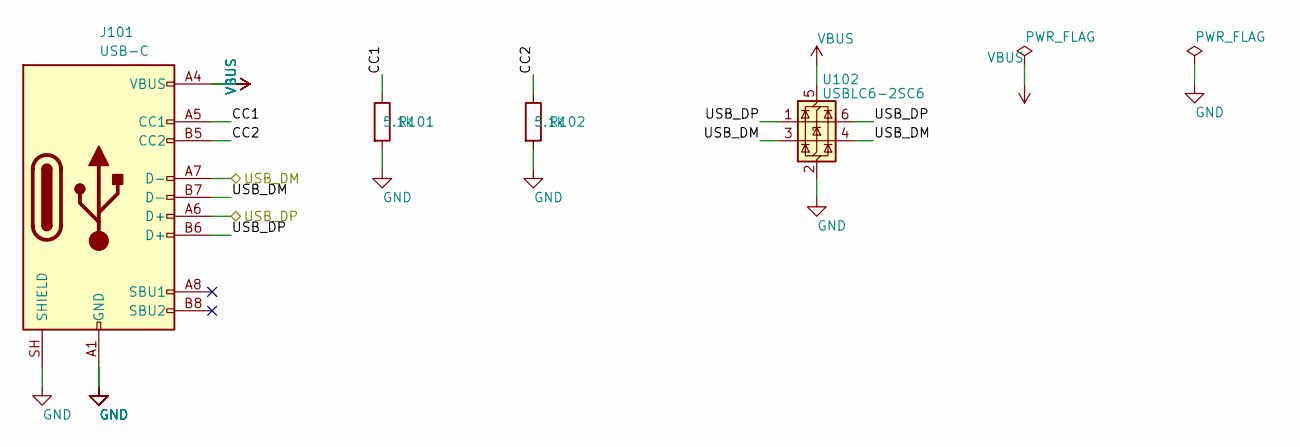
[picture p35: schematic usb.kicad_sch]

Parts:
J101: USB-C; USB_C_Receptacle_HRO_TYPE-C-31-M-12; LCSC C165948
R101, R102: 5.1k; R_0603_1608Metric; LCSC C23186
U102: USBLC6-2SC6; SOT-23-6; LCSC C7519

Connections:
/USB_DM: J101.A7 (D-), J101.B7 (D-), U102.3 (I/O2), U102.4 (I/O2); also elsewhere on the board
/USB_DP: J101.A6 (D+), J101.B6 (D+), U102.1 (I/O1), U102.6 (I/O1); also elsewhere on the board
/usb/CC1: J101.A5 (CC1), R101.1
/usb/CC2: J101.B5 (CC2), R102.1
GND: J101.A1 (GND), J101.A12 (GND), J101.B1 (GND), J101.B12 (GND), J101.SH (SHIELD), R101.2, R102.2, U102.2 (GND); also elsewhere on the board
VBUS: J101.A4 (VBUS), J101.A9 (VBUS), J101.B4 (VBUS), J101.B9 (VBUS), U102.5 (VBUS); also elsewhere on the board

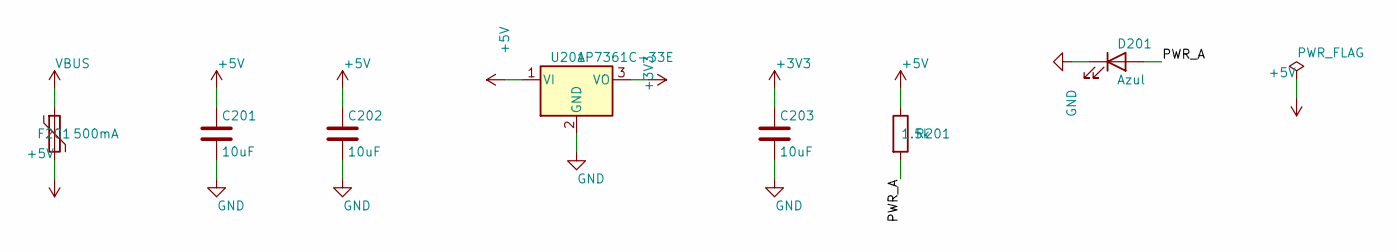
[picture p36: schematic alimentacion.kicad_sch, Alimentación]

Parts:
C201, C202, C203: 10uF; C_0603_1608Metric; LCSC C19702
D201: Azul; LED_0603_1608Metric; LCSC C2288
F201: 500mA; Fuse_1206_3216Metric; LCSC C163512
R201: 1.5k; R_0603_1608Metric; LCSC C22843
U201: AP7361C-33E; SOT-223-3_TabPin2; LCSC C3743528

Connections:
+3V3: C203.1, U201.3 (VO); also elsewhere on the board
+5V: C201.1, C202.1, F201.2, R201.1, U201.1 (VI); also elsewhere on the board
/alimentacion/PWR_A: D201.2 (A), R201.2
GND: C201.2, C202.2, C203.2, D201.1 (K), U201.2 (GND); also elsewhere on the board
VBUS: F201.1; also elsewhere on the board

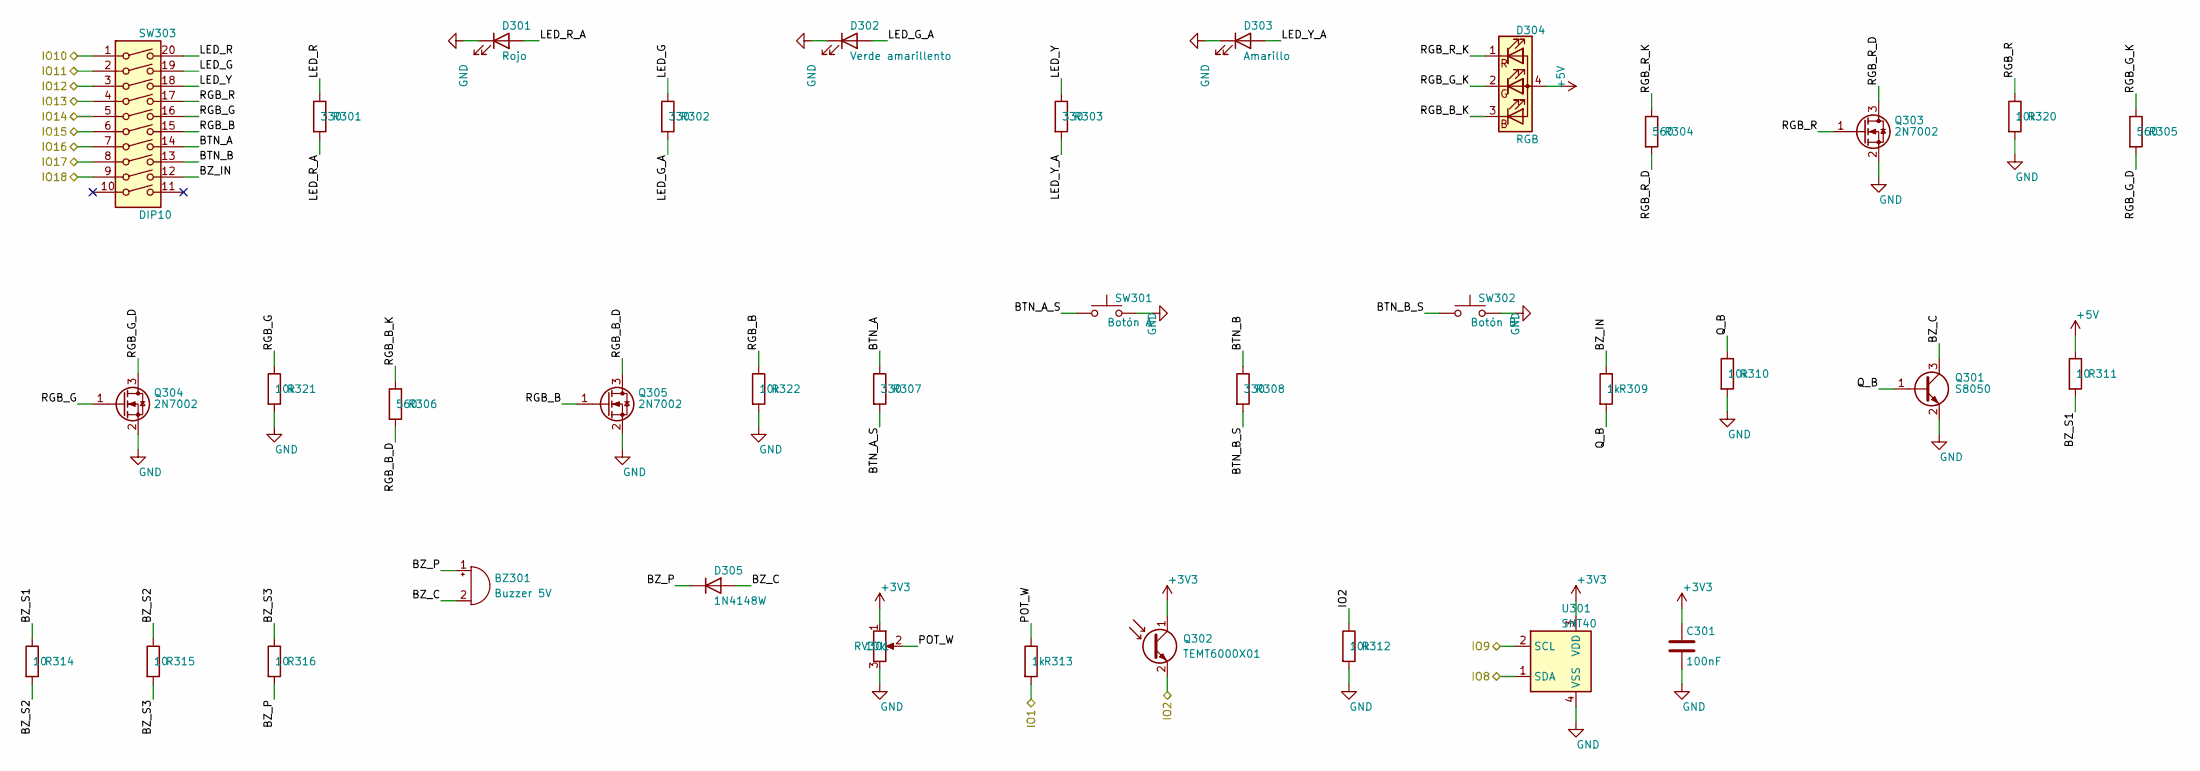
[picture p37: schematic perifericos.kicad_sch, Periféricos integrados]

Parts:
BZ301: Buzzer 5V; MagneticBuzzer_CUI_CMT-8504-100-SMT; LCSC C7421674
C301: 100nF; C_0603_1608Metric; LCSC C14663
D301: Rojo; LED_0603_1608Metric; LCSC C2286
D302: Verde amarillento; LED_0603_1608Metric; LCSC C2289
D303: Amarillo; LED_0603_1608Metric; LCSC C2287
D304: RGB; LED_Avago_PLCC4_3.2x2.8mm_CW; LCSC C3029073
D305: 1N4148W; D_SOD-123; LCSC C81598
Q301: S8050; SOT-23; LCSC C2146
Q302: TEMT6000X01; LED_1206_3216Metric; LCSC C94098
Q303, Q304, Q305: 2N7002; SOT-23; LCSC C8545
R301, R302, R303, R307, R308: 330; R_0603_1608Metric; LCSC C23138
R304, R305, R306: 560; R_0603_1608Metric; LCSC C23204
R309, R313: 1k; R_0603_1608Metric; LCSC C21190
R310, R312, R320, R321, R322: 10k; R_0603_1608Metric; LCSC C25804
R311, R314, R315, R316: 10; R_0603_1608Metric; LCSC C22859
RV301: 10k; Potentiometer_Alps_RK09K_Single_Vertical; LCSC C202373
SW301: Botón A; SW_Push_1TS009xxxx-xxxx-xxxx_6x6x5mm; LCSC C319409
SW302: Botón B; SW_Push_1TS009xxxx-xxxx-xxxx_6x6x5mm; LCSC C319409
SW303: DIP10; SW_DIP_SPSTx10_Slide_Omron_A6S-1010x_W8.9mm_P2.54mm; LCSC C18198122
U301: SHT40; SHT4x_ayemi; LCSC C2909890

Connections:
+3V3: C301.1, Q302.1 (C), RV301.1, U301.3 (VDD); also elsewhere on the board
+5V: D304.4 (A), R311.1; also elsewhere on the board
/IO1: R313.2; also elsewhere on the board
/IO2: Q302.2 (E), R312.1; also elsewhere on the board
/IO8: U301.1 (SDA); also elsewhere on the board
/IO9: U301.2 (SCL); also elsewhere on the board
/IO10: SW303.1; also elsewhere on the board
/IO11: SW303.2; also elsewhere on the board
/IO12: SW303.3; also elsewhere on the board
/IO13: SW303.4; also elsewhere on the board
/IO14: SW303.5; also elsewhere on the board
/IO15: SW303.6; also elsewhere on the board
/IO16: SW303.7; also elsewhere on the board
/IO17: SW303.8; also elsewhere on the board
/IO18: SW303.9; also elsewhere on the board
/perifericos/BTN_A: R307.1, SW303.14
/perifericos/BTN_A_S: R307.2, SW301.1
/perifericos/BTN_B: R308.1, SW303.13
/perifericos/BTN_B_S: R308.2, SW302.1
/perifericos/BZ_C: BZ301.2 (-), D305.2 (A), Q301.3 (C)
/perifericos/BZ_IN: R309.1, SW303.12
/perifericos/BZ_P: BZ301.1 (+), D305.1 (K), R316.2
/perifericos/BZ_S1: R311.2, R314.1
/perifericos/BZ_S2: R314.2, R315.1
/perifericos/BZ_S3: R315.2, R316.1
/perifericos/LED_G: R302.1, SW303.19
/perifericos/LED_G_A: D302.2 (A), R302.2
/perifericos/LED_R: R301.1, SW303.20
/perifericos/LED_R_A: D301.2 (A), R301.2
/perifericos/LED_Y: R303.1, SW303.18
/perifericos/LED_Y_A: D303.2 (A), R303.2
/perifericos/POT_W: R313.1, RV301.2
/perifericos/Q_B: Q301.1 (B), R309.2, R310.1
/perifericos/RGB_B: Q305.1 (G), R322.1, SW303.15
/perifericos/RGB_B_D: Q305.3 (D), R306.2
/perifericos/RGB_B_K: D304.3 (BK), R306.1
/perifericos/RGB_G: Q304.1 (G), R321.1, SW303.16
/perifericos/RGB_G_D: Q304.3 (D), R305.2
/perifericos/RGB_G_K: D304.2 (GK), R305.1
/perifericos/RGB_R: Q303.1 (G), R320.1, SW303.17
/perifericos/RGB_R_D: Q303.3 (D), R304.2
/perifericos/RGB_R_K: D304.1 (RK), R304.1
GND: C301.2, D301.1 (K), D302.1 (K), D303.1 (K), Q301.2 (E), Q303.2 (S), Q304.2 (S), Q305.2 (S), R310.2, R312.2, R320.2, R321.2, R322.2, RV301.3, SW301.2, SW302.2, U301.4 (VSS); also elsewhere on the board

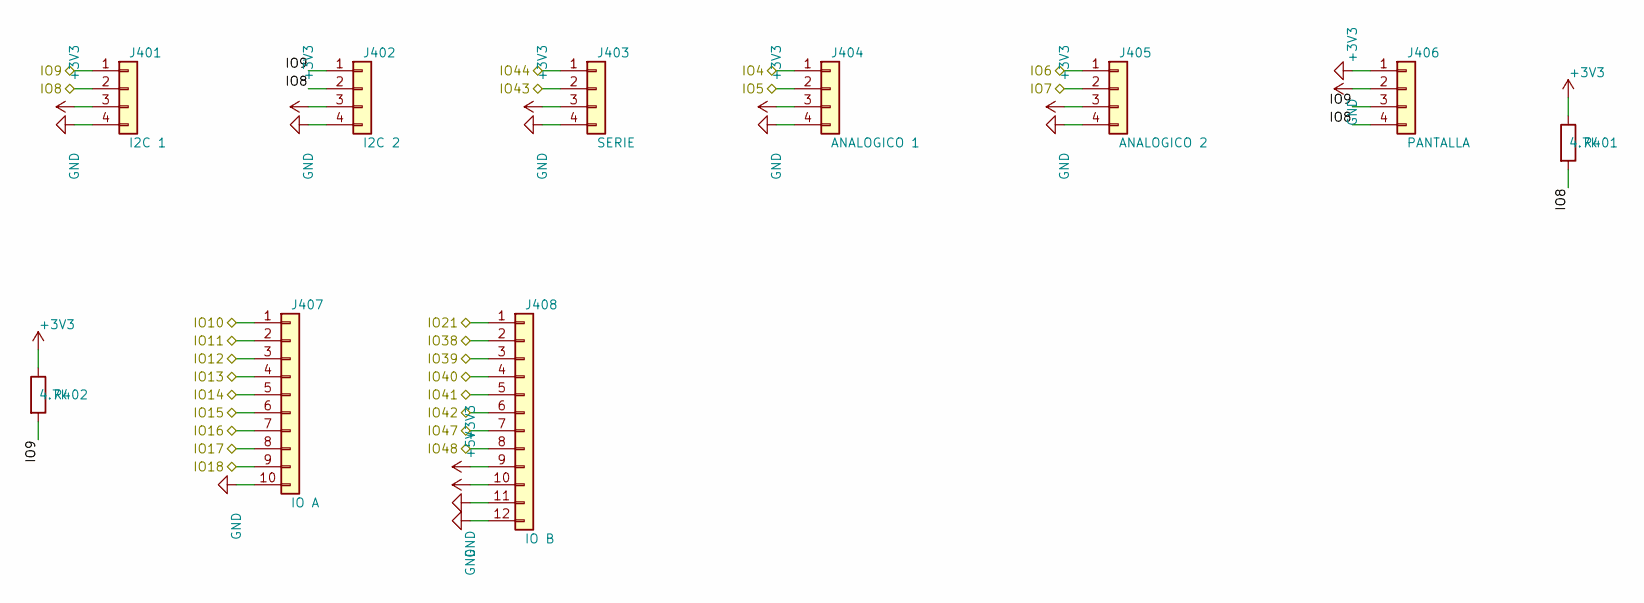
[picture p38: schematic conectores.kicad_sch]

Parts:
J401: I2C 1; JST_PH_S4B-PH-SM4-TB_1x04-1MP_P2.00mm_Horizontal; LCSC C265102
J402: I2C 2; JST_PH_S4B-PH-SM4-TB_1x04-1MP_P2.00mm_Horizontal; LCSC C265102
J403: SERIE; JST_PH_S4B-PH-SM4-TB_1x04-1MP_P2.00mm_Horizontal; LCSC C265102
J404: ANALOGICO 1; JST_PH_S4B-PH-SM4-TB_1x04-1MP_P2.00mm_Horizontal; LCSC C265102
J405: ANALOGICO 2; JST_PH_S4B-PH-SM4-TB_1x04-1MP_P2.00mm_Horizontal; LCSC C265102
J406: PANTALLA; PinHeader_1x04_P2.54mm_Vertical; LCSC C492403
J407: IO A; PinHeader_1x10_P2.54mm_Vertical; LCSC C492409
J408: IO B; PinHeader_1x12_P2.54mm_Vertical; LCSC C2840012
R401, R402: 4.7k; R_0603_1608Metric; LCSC C23162

Connections:
+3V3: J401.3, J402.3, J403.3, J404.3, J405.3, J406.2, J408.9, R401.1, R402.1; also elsewhere on the board
+5V: J408.10; also elsewhere on the board
/IO4: J404.1; also elsewhere on the board
/IO5: J404.2; also elsewhere on the board
/IO6: J405.1; also elsewhere on the board
/IO7: J405.2; also elsewhere on the board
/IO8: J401.2, J402.2, J406.4, R401.2; also elsewhere on the board
/IO9: J401.1, J402.1, J406.3, R402.2; also elsewhere on the board
/IO10: J407.1; also elsewhere on the board
/IO11: J407.2; also elsewhere on the board
/IO12: J407.3; also elsewhere on the board
/IO13: J407.4; also elsewhere on the board
/IO14: J407.5; also elsewhere on the board
/IO15: J407.6; also elsewhere on the board
/IO16: J407.7; also elsewhere on the board
/IO17: J407.8; also elsewhere on the board
/IO18: J407.9; also elsewhere on the board
/IO21: J408.1; also elsewhere on the board
/IO38: J408.2; also elsewhere on the board
/IO39: J408.3; also elsewhere on the board
/IO40: J408.4; also elsewhere on the board
/IO41: J408.5; also elsewhere on the board
/IO42: J408.6; also elsewhere on the board
/IO43: J403.2; also elsewhere on the board
/IO44: J403.1; also elsewhere on the board
/IO47: J408.7; also elsewhere on the board
/IO48: J408.8; also elsewhere on the board
GND: J401.4, J402.4, J403.4, J404.4, J405.4, J406.1, J407.10, J408.11, J408.12; also elsewhere on the board

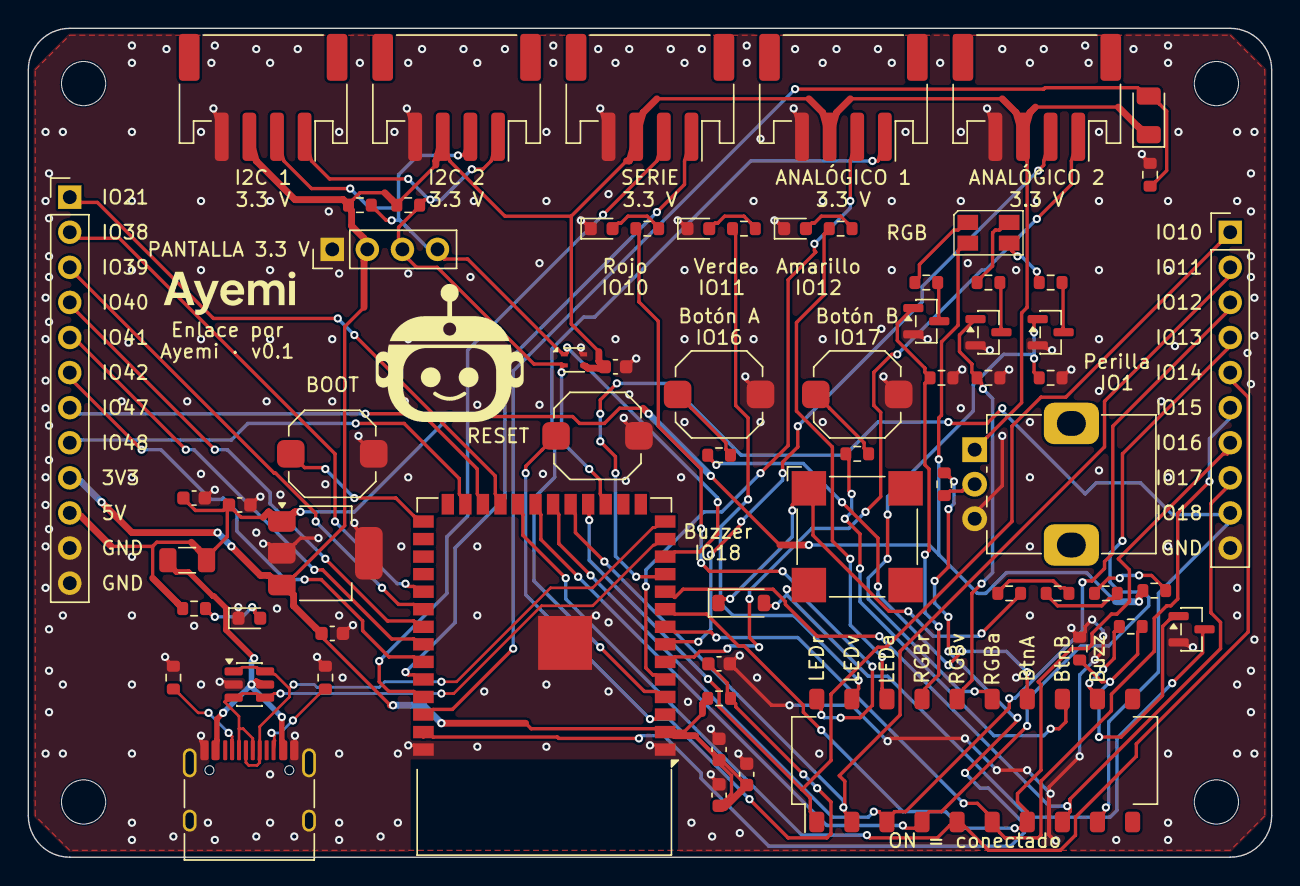
[picture p39: board enlace-esp32s3.kicad_pcb from above]

Board: 2 copper layers, 90.0 x 60.0 mm, 69 parts (0 on the bottom side), 65 nets.

Other parts of the board:
H1, H2, H3, H4: M3; MountingHole_3.2mm_M3
