ayemi-dev/pcb-ayemi/placas/entrenamiento-328p/entrenamiento-328p.kicad_pcb

## KiCad design placas/entrenamiento-328p/entrenamiento-328p.kicad_pcb (2026-11-04)

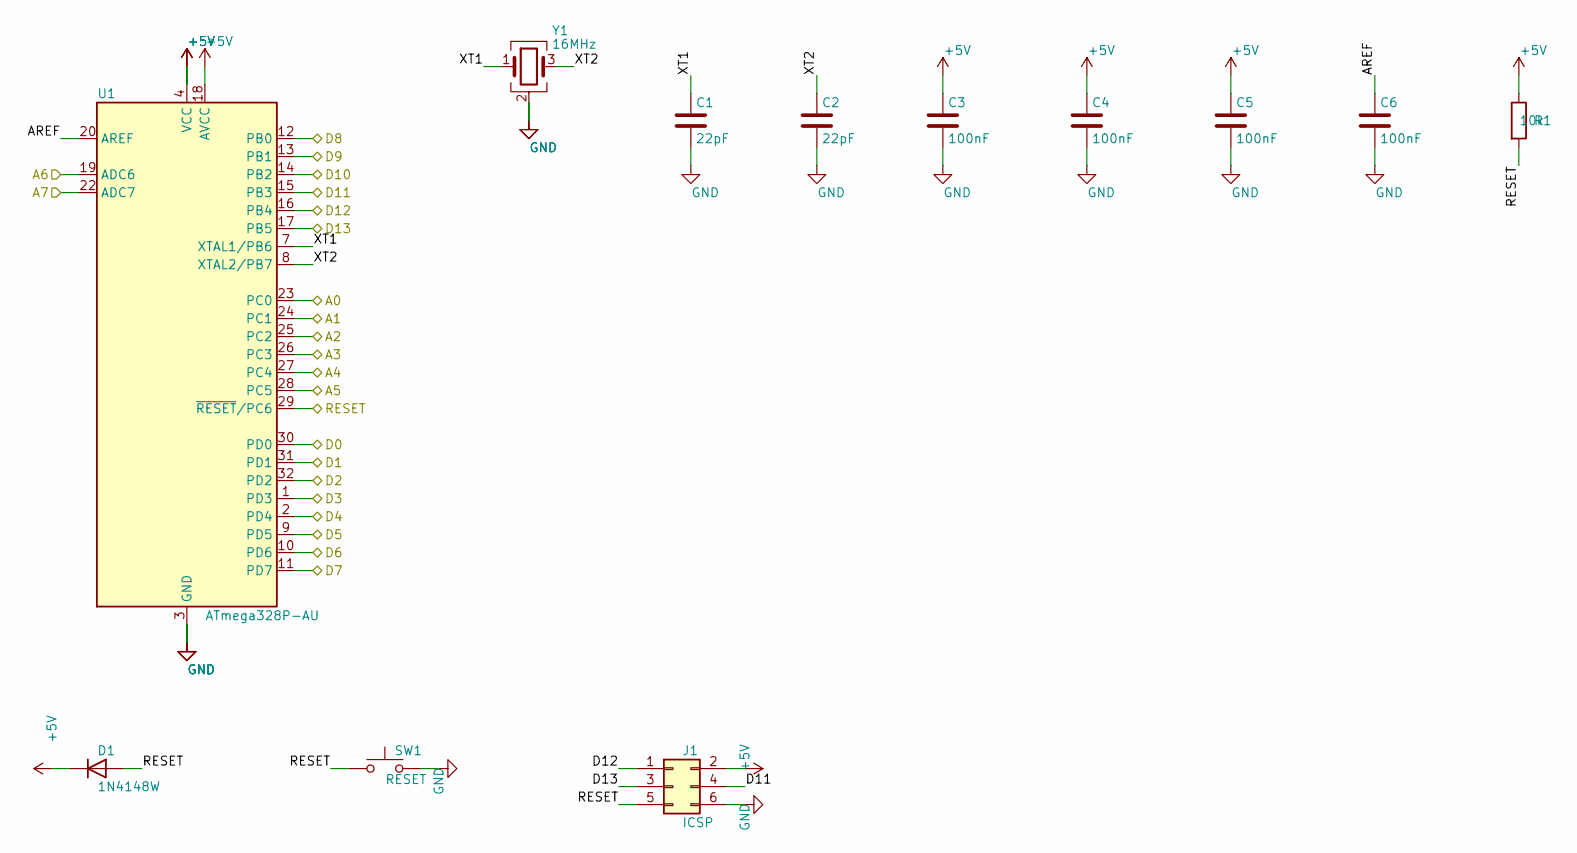
[picture p40: schematic micro.kicad_sch, Microcontrolador]

Parts:
C1, C2: 22pF; C_0603_1608Metric; LCSC C1653
C3, C4, C5, C6: 100nF; C_0603_1608Metric; LCSC C14663
D1: 1N4148W; D_SOD-123; LCSC C81598
J1: ICSP; PinHeader_2x03_P2.54mm_Vertical; LCSC C65114
R1: 10k; R_0603_1608Metric; LCSC C25804
SW1: RESET; SW_Push_1TS009xxxx-xxxx-xxxx_6x6x5mm; LCSC C319409
U1: ATmega328P-AU; TQFP-32_7x7mm_P0.8mm; LCSC C14877
Y1: 16MHz; Crystal_SMD_3225-4Pin_3.2x2.5mm; LCSC C70562

Connections:
+5V: C3.1, C4.1, C5.1, D1.1 (K), J1.2, R1.1, U1.4 (VCC), U1.6 (VCC), U1.18 (AVCC); also elsewhere on the board
/A0: U1.23 (PC0); also elsewhere on the board
/A1: U1.24 (PC1); also elsewhere on the board
/A2: U1.25 (PC2); also elsewhere on the board
/A3: U1.26 (PC3); also elsewhere on the board
/A4: U1.27 (PC4); also elsewhere on the board
/A5: U1.28 (PC5); also elsewhere on the board
/A6: U1.19 (ADC6); also elsewhere on the board
/A7: U1.22 (ADC7); also elsewhere on the board
/D0: U1.30 (PD0); also elsewhere on the board
/D1: U1.31 (PD1); also elsewhere on the board
/D2: U1.32 (PD2); also elsewhere on the board
/D3: U1.1 (PD3); also elsewhere on the board
/D4: U1.2 (PD4); also elsewhere on the board
/D5: U1.9 (PD5); also elsewhere on the board
/D6: U1.10 (PD6); also elsewhere on the board
/D7: U1.11 (PD7); also elsewhere on the board
/D8: U1.12 (PB0); also elsewhere on the board
/D9: U1.13 (PB1); also elsewhere on the board
/D10: U1.14 (PB2); also elsewhere on the board
/D11: J1.4, U1.15 (PB3); also elsewhere on the board
/D12: J1.1, U1.16 (PB4); also elsewhere on the board
/D13: J1.3, U1.17 (PB5); also elsewhere on the board
/RESET: D1.2 (A), J1.5, R1.2, SW1.1, U1.29 (~RESET/PC6); also elsewhere on the board
/micro/AREF: C6.1, U1.20 (AREF)
/micro/XT1: C1.1, U1.7 (XTAL1/PB6), Y1.1
/micro/XT2: C2.1, U1.8 (XTAL2/PB7), Y1.3
GND: C1.2, C2.2, C3.2, C4.2, C5.2, C6.2, J1.6, SW1.2, U1.3 (GND), U1.5 (GND), U1.21 (GND), Y1.2 (G), Y1.4 (G); also elsewhere on the board

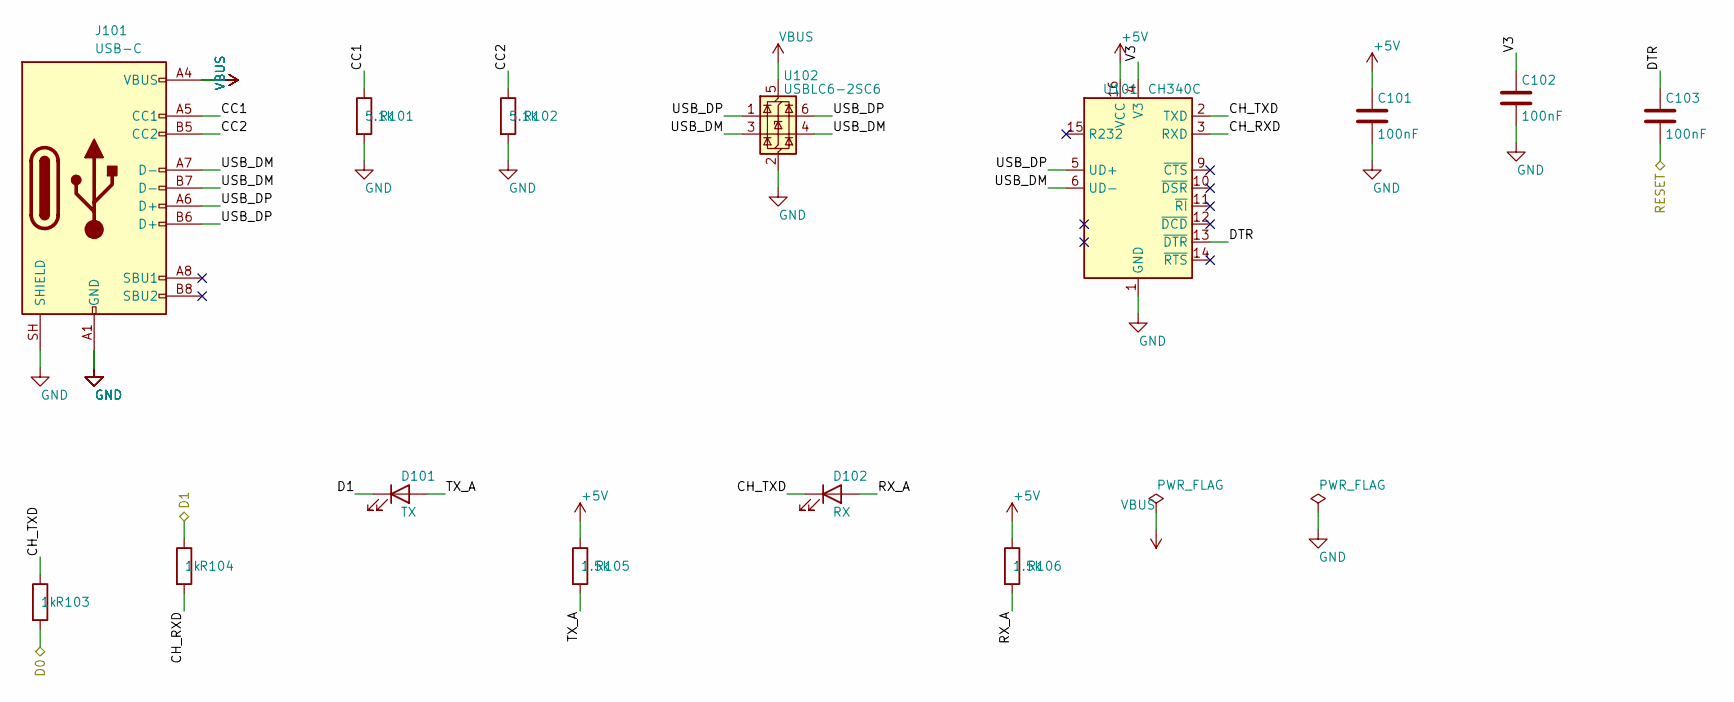
[picture p41: schematic usb.kicad_sch, USB y serie]

Parts:
C101, C102, C103: 100nF; C_0603_1608Metric; LCSC C14663
D101: TX; LED_0603_1608Metric; LCSC C2286
D102: RX; LED_0603_1608Metric; LCSC C2286
J101: USB-C; USB_C_Receptacle_HRO_TYPE-C-31-M-12; LCSC C165948
R101, R102: 5.1k; R_0603_1608Metric; LCSC C23186
R103, R104: 1k; R_0603_1608Metric; LCSC C21190
R105, R106: 1.5k; R_0603_1608Metric; LCSC C22843
U101: CH340C; SOIC-16_3.9x9.9mm_P1.27mm; LCSC C84681
U102: USBLC6-2SC6; SOT-23-6; LCSC C7519

Connections:
+5V: C101.1, R105.1, R106.1, U101.16 (VCC); also elsewhere on the board
/D0: R103.2; also elsewhere on the board
/D1: D101.1 (K), R104.1; also elsewhere on the board
/RESET: C103.2; also elsewhere on the board
/usb/CC1: J101.A5 (CC1), R101.1
/usb/CC2: J101.B5 (CC2), R102.1
/usb/CH_RXD: R104.2, U101.3 (RXD)
/usb/CH_TXD: D102.1 (K), R103.1, U101.2 (TXD)
/usb/DTR: C103.1, U101.13 (~DTR)
/usb/RX_A: D102.2 (A), R106.2
/usb/TX_A: D101.2 (A), R105.2
/usb/USB_DM: J101.A7 (D-), J101.B7 (D-), U101.6 (UD-), U102.3 (I/O2), U102.4 (I/O2)
/usb/USB_DP: J101.A6 (D+), J101.B6 (D+), U101.5 (UD+), U102.1 (I/O1), U102.6 (I/O1)
/usb/V3: C102.1, U101.4 (V3)
GND: C101.2, C102.2, J101.A1 (GND), J101.A12 (GND), J101.B1 (GND), J101.B12 (GND), J101.SH (SHIELD), R101.2, R102.2, U101.1 (GND), U102.2 (GND); also elsewhere on the board
VBUS: J101.A4 (VBUS), J101.A9 (VBUS), J101.B4 (VBUS), J101.B9 (VBUS), U102.5 (VBUS); also elsewhere on the board

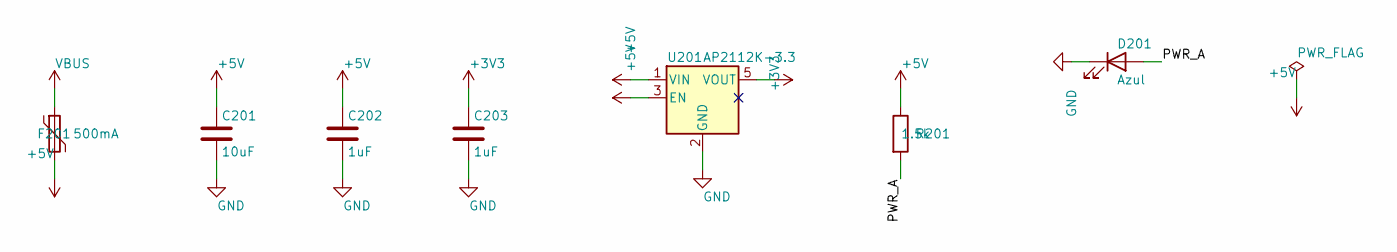
[picture p42: schematic alimentacion.kicad_sch, Alimentación]

Parts:
C201: 10uF; C_0603_1608Metric; LCSC C19702
C202, C203: 1uF; C_0603_1608Metric; LCSC C15849
D201: Azul; LED_0603_1608Metric; LCSC C2288
F201: 500mA; Fuse_1206_3216Metric; LCSC C163512
R201: 1.5k; R_0603_1608Metric; LCSC C22843
U201: AP2112K-3.3; SOT-23-5; LCSC C51118

Connections:
+3V3: C203.1, U201.5 (VOUT); also elsewhere on the board
+5V: C201.1, C202.1, F201.2, R201.1, U201.1 (VIN), U201.3 (EN); also elsewhere on the board
/alimentacion/PWR_A: D201.2 (A), R201.2
GND: C201.2, C202.2, C203.2, D201.1 (K), U201.2 (GND); also elsewhere on the board
VBUS: F201.1; also elsewhere on the board

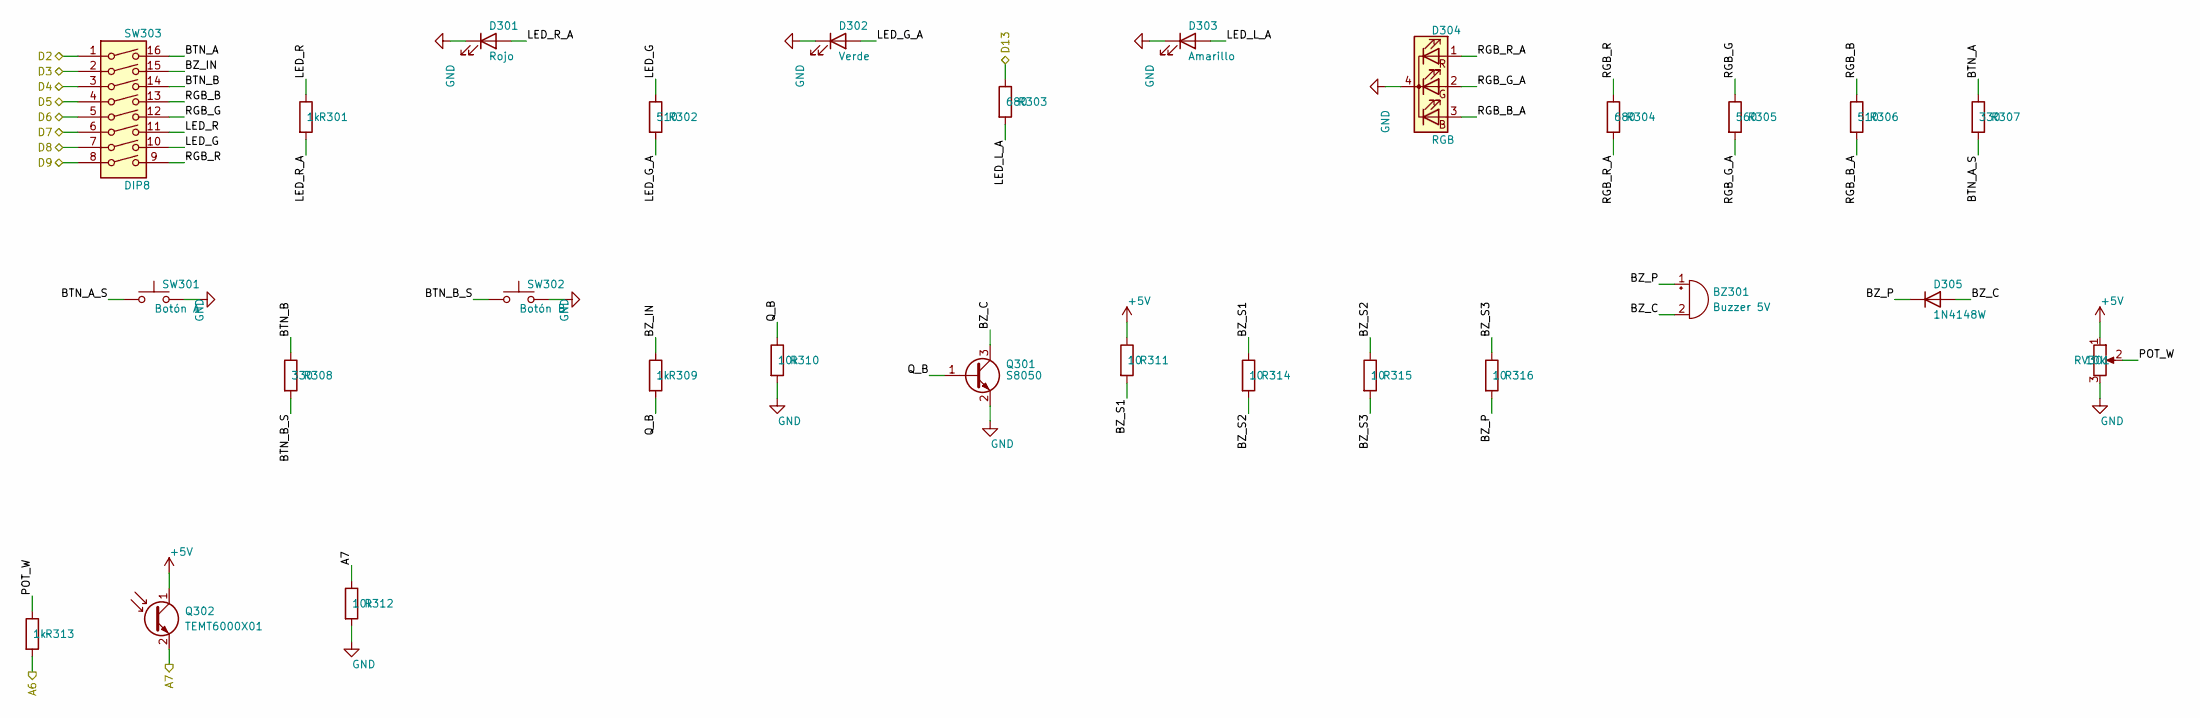
[picture p43: schematic perifericos.kicad_sch, Periféricos integrados]

Parts:
BZ301: Buzzer 5V; MagneticBuzzer_CUI_CMT-8504-100-SMT; LCSC C7421674
D301: Rojo; LED_0603_1608Metric; LCSC C2286
D302: Verde; LED_0603_1608Metric; LCSC C12624
D303: Amarillo; LED_0603_1608Metric; LCSC C2287
D304: RGB; LED_Avago_PLCC4_3.2x2.8mm_CW; LCSC C3647023
D305: 1N4148W; D_SOD-123; LCSC C81598
Q301: S8050; SOT-23; LCSC C2146
Q302: TEMT6000X01; LED_1206_3216Metric; LCSC C94098
R301, R309, R313: 1k; R_0603_1608Metric; LCSC C21190
R302, R306: 510; R_0603_1608Metric; LCSC C23193
R303, R304: 680; R_0603_1608Metric; LCSC C23228
R305: 560; R_0603_1608Metric; LCSC C23204
R307, R308: 330; R_0603_1608Metric; LCSC C23138
R310, R312: 10k; R_0603_1608Metric; LCSC C25804
R311, R314, R315, R316: 10; R_0603_1608Metric; LCSC C22859
RV301: 10k; Potentiometer_Alps_RK09K_Single_Vertical; LCSC C202373
SW301: Botón A; SW_Push_1TS009xxxx-xxxx-xxxx_6x6x5mm; LCSC C319409
SW302: Botón B; SW_Push_1TS009xxxx-xxxx-xxxx_6x6x5mm; LCSC C319409
SW303: DIP8; SW_DIP_SPSTx08_Slide_Omron_A6S-810x_W8.9mm_P2.54mm; LCSC C6709493

Connections:
+5V: Q302.1 (C), R311.1, RV301.1; also elsewhere on the board
/A6: R313.2; also elsewhere on the board
/A7: Q302.2 (E), R312.1; also elsewhere on the board
/D2: SW303.1; also elsewhere on the board
/D3: SW303.2; also elsewhere on the board
/D4: SW303.3; also elsewhere on the board
/D5: SW303.4; also elsewhere on the board
/D6: SW303.5; also elsewhere on the board
/D7: SW303.6; also elsewhere on the board
/D8: SW303.7; also elsewhere on the board
/D9: SW303.8; also elsewhere on the board
/D13: R303.1; also elsewhere on the board
/perifericos/BTN_A: R307.1, SW303.16
/perifericos/BTN_A_S: R307.2, SW301.1
/perifericos/BTN_B: R308.1, SW303.14
/perifericos/BTN_B_S: R308.2, SW302.1
/perifericos/BZ_C: BZ301.2 (-), D305.2 (A), Q301.3 (C)
/perifericos/BZ_IN: R309.1, SW303.15
/perifericos/BZ_P: BZ301.1 (+), D305.1 (K), R316.2
/perifericos/BZ_S1: R311.2, R314.1
/perifericos/BZ_S2: R314.2, R315.1
/perifericos/BZ_S3: R315.2, R316.1
/perifericos/LED_G: R302.1, SW303.10
/perifericos/LED_G_A: D302.2 (A), R302.2
/perifericos/LED_L_A: D303.2 (A), R303.2
/perifericos/LED_R: R301.1, SW303.11
/perifericos/LED_R_A: D301.2 (A), R301.2
/perifericos/POT_W: R313.1, RV301.2
/perifericos/Q_B: Q301.1 (B), R309.2, R310.1
/perifericos/RGB_B: R306.1, SW303.13
/perifericos/RGB_B_A: D304.3 (BA), R306.2
/perifericos/RGB_G: R305.1, SW303.12
/perifericos/RGB_G_A: D304.2 (GA), R305.2
/perifericos/RGB_R: R304.1, SW303.9
/perifericos/RGB_R_A: D304.1 (RA), R304.2
GND: D301.1 (K), D302.1 (K), D303.1 (K), D304.4 (K), Q301.2 (E), R310.2, R312.2, RV301.3, SW301.2, SW302.2; also elsewhere on the board

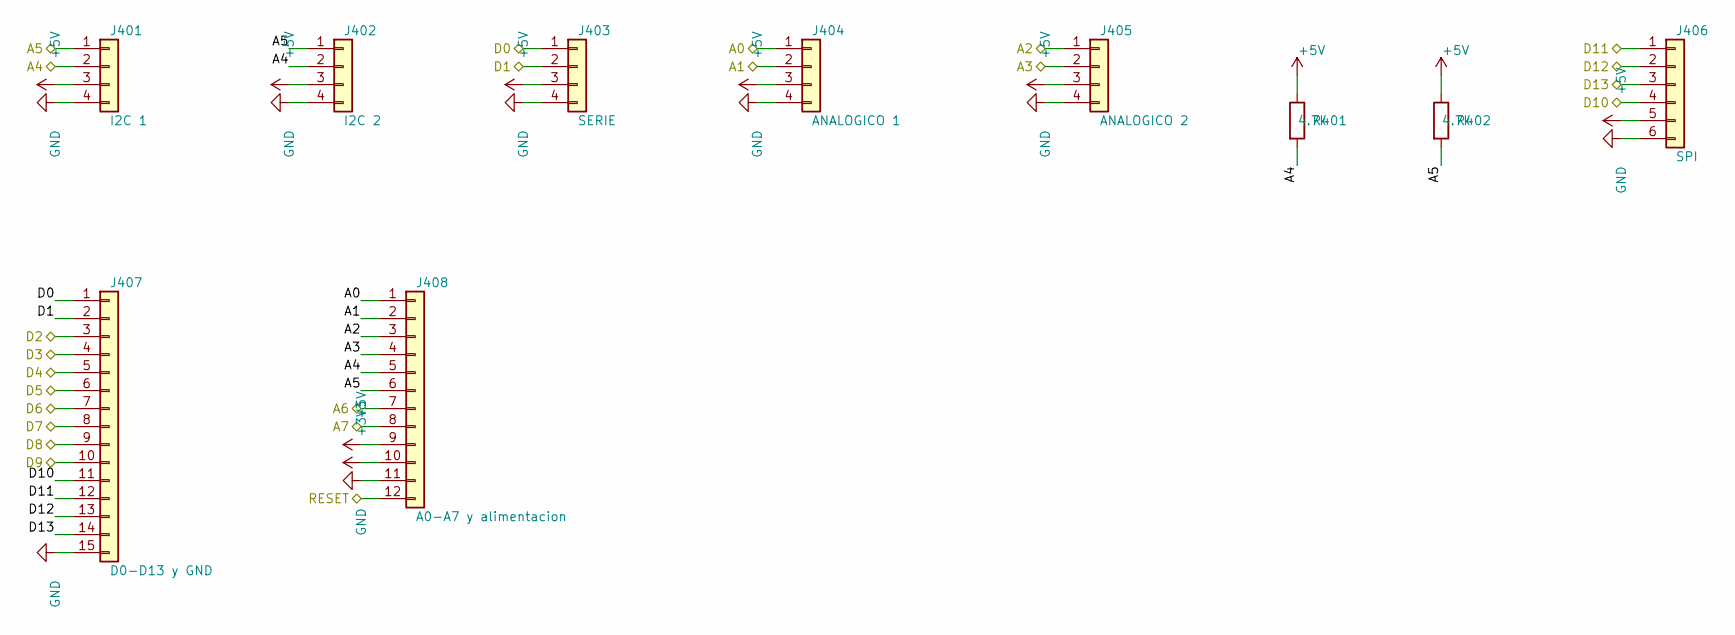
[picture p44: schematic conectores.kicad_sch]

Parts:
J401: I2C 1; JST_PH_S4B-PH-SM4-TB_1x04-1MP_P2.00mm_Horizontal; LCSC C265102
J402: I2C 2; JST_PH_S4B-PH-SM4-TB_1x04-1MP_P2.00mm_Horizontal; LCSC C265102
J403: SERIE; JST_PH_S4B-PH-SM4-TB_1x04-1MP_P2.00mm_Horizontal; LCSC C265102
J404: ANALOGICO 1; JST_PH_S4B-PH-SM4-TB_1x04-1MP_P2.00mm_Horizontal; LCSC C265102
J405: ANALOGICO 2; JST_PH_S4B-PH-SM4-TB_1x04-1MP_P2.00mm_Horizontal; LCSC C265102
J406: SPI; PinHeader_1x06_P2.54mm_Vertical; LCSC C492405
J407: D0-D13 y GND; PinHeader_1x15_P2.54mm_Vertical; LCSC C22465875
J408: A0-A7 y alimentacion; PinHeader_1x12_P2.54mm_Vertical; LCSC C2840012
R401, R402: 4.7k; R_0603_1608Metric; LCSC C23162

Connections:
+3V3: J408.10; also elsewhere on the board
+5V: J401.3, J402.3, J403.3, J404.3, J405.3, J406.5, J408.9, R401.1, R402.1; also elsewhere on the board
/A0: J404.1, J408.1; also elsewhere on the board
/A1: J404.2, J408.2; also elsewhere on the board
/A2: J405.1, J408.3; also elsewhere on the board
/A3: J405.2, J408.4; also elsewhere on the board
/A4: J401.2, J402.2, J408.5, R401.2; also elsewhere on the board
/A5: J401.1, J402.1, J408.6, R402.2; also elsewhere on the board
/A6: J408.7; also elsewhere on the board
/A7: J408.8; also elsewhere on the board
/D0: J403.1, J407.1; also elsewhere on the board
/D1: J403.2, J407.2; also elsewhere on the board
/D2: J407.3; also elsewhere on the board
/D3: J407.4; also elsewhere on the board
/D4: J407.5; also elsewhere on the board
/D5: J407.6; also elsewhere on the board
/D6: J407.7; also elsewhere on the board
/D7: J407.8; also elsewhere on the board
/D8: J407.9; also elsewhere on the board
/D9: J407.10; also elsewhere on the board
/D10: J406.4, J407.11; also elsewhere on the board
/D11: J406.1, J407.12; also elsewhere on the board
/D12: J406.2, J407.13; also elsewhere on the board
/D13: J406.3, J407.14; also elsewhere on the board
/RESET: J408.12; also elsewhere on the board
GND: J401.4, J402.4, J403.4, J404.4, J405.4, J406.6, J407.15, J408.11; also elsewhere on the board
