ayemi-dev/pcb-ayemi/placas/entrenamiento-328p/entrenamiento-328p.kicad_pcb

## KiCad design placas/entrenamiento-328p/entrenamiento-328p.kicad_pcb (continued)

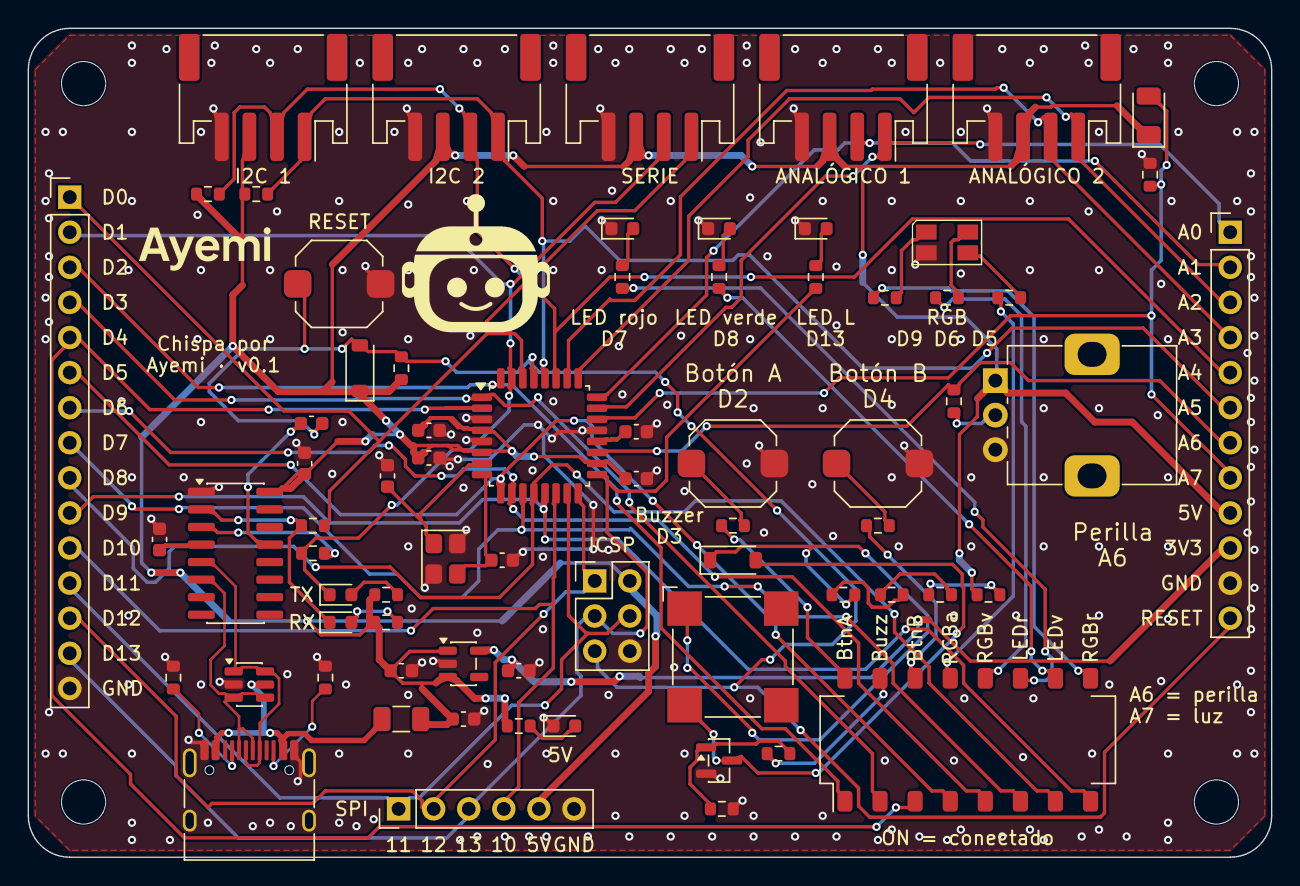
[picture p45: board entrenamiento-328p.kicad_pcb from above]

Board: 2 copper layers, 90.0 x 60.0 mm, 75 parts (0 on the bottom side), 64 nets.

Other parts of the board:
H1, H2, H3, H4: M3; MountingHole_3.2mm_M3
