ayemi-dev/pcb-ayemi/placas/enlace-esp32s3/spec/pcb.yaml

#  Enlace por Ayemi (ESP32-S3) · spec de la placa
#  Fuente de verdad para tools/pcb_setup.py, colocar.py, rutear.py, costura.py, serigrafia.py y fab.py.
#  Misma cadena y mismas reglas que Chispa (placas/entrenamiento-328p/spec/pcb.yaml).
# =============================================================================

placa:
  nombre: "Enlace por Ayemi"
  version: "0.1"
  ancho_mm: 90
  alto_mm: 60
  radio_esquinas_mm: 3
  capas: 2
  grosor_mm: 1.6
  mascara: negra
  serigrafia: blanca
  piezas_solo_arriba: true
  origen_mm: [100, 80]

barrenos:
  tipo: M3
  separacion_borde_mm: 4
  huella: "MountingHole:MountingHole_3.2mm_M3"
  posiciones: [[4, 4], [86, 4], [4, 56], [86, 56]]
  exclusion_mm: 6.4

reglas:
  pista_minima_mm: 0.15
  separacion_minima_mm: 0.15
  via_diametro_mm: 0.6
  via_taladro_mm: 0.3
  anillo_minimo_mm: 0.15
  cobre_a_borde_mm: 0.3
  taladro_minimo_mm: 0.3
  serigrafia_alto_min_mm: 1.0
  serigrafia_trazo_min_mm: 0.15

clases_de_red:
  Default:  {pista_mm: 0.25, separacion_mm: 0.2}
  Potencia: {pista_mm: 0.5,  separacion_mm: 0.2, redes: ["+5V", "+3V3", VBUS, GND]}
  USB:      {pista_mm: 0.3,  separacion_mm: 0.2, redes: [USB_DP, USB_DM]}

planos:
  - {red: GND, capas: [F.Cu, B.Cu], margen_borde_mm: 0.5, separacion_mm: 0.3}

costura_gnd:
  evitar_mm: [[78.0, 42.7]]   # isla de GND de 2 mm² entre R309, R310 y pistas del DIP: una vía ahí la une a una isla en B.Cu, sin salida al plano
  rejilla_mm: 5
  borde_paso_mm: 3
  borde_margen_mm: 1.5

# Copia de la huella oficial del módulo sin las vías térmicas de 0.2 mm (bajo el mínimo de 0.3 mm de JLCPCB) y con la
# cortesía reducida al cuerpo: la oficial incluye 15 mm de aire alrededor de la antena. La antena se protege con
# `areas_prohibidas` (ANTENA).
huellas_locales:
  - origen: "RF_Module:ESP32-S3-WROOM-1"
    nombre: "ESP32-S3-WROOM-1_ayemi"
    quitar_taladros_menores_mm: 0.3
    quitar_zonas: true
    cortesia_mm: [-9.3, -13.05, 9.3, 13.3]
  # La huella oficial del SHT4x trae una zona de exclusión (keepout) de cobre en F.Cu que prohíbe pistas y vías
  # junto al sensor. Se quita en la copia local; el sensor se ve afectado por el calor de las pistas cercanas
  # (se anota en el README, «Pendiente antes de fabricar»).
  - origen: "Sensor_Humidity:Sensirion_DFN-4_1.5x1.5mm_P0.8mm_SHT4x_NoCentralPad"
    nombre: "SHT4x_ayemi"
    quitar_zonas: true

ruteo:
  resolucion_mm: 0.1
  pasadas: 1
  abanico: [U1]
  abanico_mm: 1.0
  sin_vias: []
  refinar_s: 600
  mejora_s: 1200
  fino: {pista_mm: 0.2, separacion_mm: 0.2}
  ventanas:
    - {nombre: "USB-C", x_mm: [7, 50], y_mm: [30, 59], resolucion_mm: 0.05, ancho_mm: 0.2, ancho_medio_mm: 0.4, redes: [CC1, CC2, USB_DM, USB_DP, VBUS], redes_medias: [VBUS], gnd_pads: [U102.2]}

# Zona de la antena del módulo (cuerpo girado 180°: la antena queda hacia el borde inferior). Sin pistas, vías ni
# cobre en las dos caras. Coordenadas de la placa; se calcula desde la posición fija de U1.
areas_prohibidas:
  - nombre: ANTENA
    descripcion: "Antena de PCB del ESP32-S3-WROOM-1: sin cobre ni pistas en las dos caras"
    rect_mm: [27.55, 52.8, 47.15, 60.5]
    margen_mm: 0.0
    redes_permitidas: []
    bloquea_cobre: true

zonas:
  usb:        {borde: inferior, nota: "USB-C con la boca hacia afuera"}
  antena:     {borde: inferior, nota: "Módulo con la antena en el borde inferior, entre el USB-C y el DIP"}
  conectores: {borde: superior, nota: "Los 5 conectores de 4 pines en el borde superior, boca hacia afuera, paso de 14 mm"}
  manos:      {x_mm: [44, 84], y_mm: [10, 56], nota: "Botones, potenciómetro, buzzer y DIP"}

fijos:
  H1:   {x_mm: 4,    y_mm: 4,     rot: 0}
  H2:   {x_mm: 86,   y_mm: 4,     rot: 0}
  H3:   {x_mm: 4,    y_mm: 56,    rot: 0}
  H4:   {x_mm: 86,   y_mm: 56,    rot: 0}
  J401: {x_mm: 17,   y_mm: 5.0,   rot: 180}
  J402: {x_mm: 31,   y_mm: 5.0,   rot: 180}
  J403: {x_mm: 45,   y_mm: 5.0,   rot: 180}
  J404: {x_mm: 59,   y_mm: 5.0,   rot: 180}
  J405: {x_mm: 73,   y_mm: 5.0,   rot: 180}
  J408: {x_mm: 3,    y_mm: 12.22, rot: 0}     # IO B (12 pines) en el borde izquierdo
  J407: {x_mm: 87,   y_mm: 14.76, rot: 0}     # IO A (10 pines) en el borde derecho
  J101: {x_mm: 16,   y_mm: 56.3,  rot: 0}
  U1:   {x_mm: 37.35, y_mm: 46.95, rot: 180}  # antena hacia el borde inferior

aprox:
  # --- módulo: EN, BOOT y desacoplo ---
  C1:   {x_mm: 50.0, y_mm: 52.5, rot: 90}
  C2:   {x_mm: 50.0, y_mm: 55.5, rot: 90}
  C3:   {x_mm: 52.0, y_mm: 54.0, rot: 90}
  R1:   {x_mm: 50.0, y_mm: 48.5, rot: 0}
  C4:   {x_mm: 50.0, y_mm: 46.0, rot: 0}
  SW1:  {x_mm: 41.5, y_mm: 29.5, rot: 0}
  SW2:  {x_mm: 22.0, y_mm: 31.0, rot: 0}
  # --- USB y alimentación ---
  U102: {x_mm: 16.0, y_mm: 47.5, rot: 0}
  R101: {x_mm: 10.5, y_mm: 47.0, rot: 90}
  R102: {x_mm: 21.5, y_mm: 47.0, rot: 90}
  F201: {x_mm: 11.5, y_mm: 38.5, rot: 0}
  C201: {x_mm: 15.0, y_mm: 34.5, rot: 0}
  C202: {x_mm: 12.0, y_mm: 34.0, rot: 0}
  U201: {x_mm: 21.5, y_mm: 38.0, rot: 0}
  C203: {x_mm: 22.0, y_mm: 43.8, rot: 0}
  R201: {x_mm: 12.0, y_mm: 42.0, rot: 0}
  D201: {x_mm: 16.0, y_mm: 42.0, rot: 0}
  # --- conectores ---
  J406: {x_mm: 22.0, y_mm: 16.0, rot: 90}
  R401: {x_mm: 24, y_mm: 12.8, rot: 0}
  R402: {x_mm: 27.5, y_mm: 12.8, rot: 0}
  # --- LEDs, RGB y sensores ---
  D301: {x_mm: 41.5, y_mm: 14.5, rot: 0}
  D302: {x_mm: 48.5, y_mm: 14.5, rot: 0}
  D303: {x_mm: 55.5, y_mm: 14.5, rot: 0}
  R301: {x_mm: 44.8, y_mm: 14.5, rot: 0}
  R302: {x_mm: 51.8, y_mm: 14.5, rot: 0}
  R303: {x_mm: 58.8, y_mm: 14.5, rot: 0}
  D304: {x_mm: 69.5, y_mm: 14.8, rot: 0}
  R304: {x_mm: 65, y_mm: 18.4, rot: 0}
  R305: {x_mm: 69.5, y_mm: 18.4, rot: 0}
  R306: {x_mm: 74, y_mm: 18.4, rot: 0}
  Q303: {x_mm: 65, y_mm: 22, rot: 0}
  Q304: {x_mm: 69.5, y_mm: 22, rot: 0}
  Q305: {x_mm: 74, y_mm: 22, rot: 0}
  R320: {x_mm: 65, y_mm: 25.4, rot: 0}
  R321: {x_mm: 69.5, y_mm: 25.4, rot: 0}
  R322: {x_mm: 74, y_mm: 25.4, rot: 0}
  Q302: {x_mm: 81.2, y_mm: 6.3,  rot: 90}
  R312: {x_mm: 81.2, y_mm: 10.6, rot: 90}
  U301: {x_mm: 39.5, y_mm: 24, rot: 0}
  C301: {x_mm: 42.5, y_mm: 24.5, rot: 0}
  # --- zona de manos: botones, perilla, buzzer, DIP ---
  SW301: {x_mm: 50, y_mm: 26.5, rot: 0}
  SW302: {x_mm: 60, y_mm: 26.5, rot: 0}
  R307:  {x_mm: 50, y_mm: 30.9, rot: 0}
  R308:  {x_mm: 60, y_mm: 30.9, rot: 0}
  RV301: {x_mm: 68.5, y_mm: 30.5, rot: 0}
  R313:  {x_mm: 66.5, y_mm: 33, rot: 90}
  BZ301: {x_mm: 60, y_mm: 36.8, rot: 0}
  D305:  {x_mm: 51.6, y_mm: 41.6, rot: 0}
  Q301:  {x_mm: 84.2, y_mm: 43.5, rot: 0}
  R309:  {x_mm: 79.8, y_mm: 43.3, rot: 0}
  R310:  {x_mm: 76.12, y_mm: 44.9, rot: 90}
  R316:  {x_mm: 71, y_mm: 40.9, rot: 0}
  R315:  {x_mm: 74.5, y_mm: 40.9, rot: 0}
  R314:  {x_mm: 78, y_mm: 40.9, rot: 0}
  R311:  {x_mm: 81.5, y_mm: 40.9, rot: 0}
  SW303: {x_mm: 68.5, y_mm: 53, rot: 90}

cerca_de:
  C1:   {pin: "U1.2",  max_mm: 8}
  C2:   {pin: "U1.2",  max_mm: 8}
  C3:   {pin: "U1.2",  max_mm: 10}
  U102: {pin: "J101.A6", max_mm: 10}
grupos: []

serigrafia:
  referencias_ocultas: true
  trazo_mm: 0.15
  alias_redes: {IO8: "IO8 SDA", IO9: "IO9 SCL", IO44: "IO44 RX", IO43: "IO43 TX"}
  arriba:
    logotipo: {svg: spec/logos/ayemi-logotipo.svg, x_mm: 9.8, y_mm: 17.6, ancho_mm: 9.5}
    # Emi de una tinta, versión de cabeza: el cuerpo completo (18 a 22 mm de alto) no cabe en la cara superior.
    emi: {svg: spec/logos/emi-serigrafia-cabeza.svg, x_mm: 30.5, y_mm: 23.5, alto_mm: 10.0}
    textos:
      - {texto: "Enlace por\nAyemi · v0.1", x_mm: 14.4, y_mm: 22.6, alto_mm: 1.0}
      - {texto: "I2C 1", x_mm: 17, y_mm: 10.8, alto_mm: 1.0}
      - {texto: "I2C 2", x_mm: 31, y_mm: 10.8, alto_mm: 1.0}
      - {texto: "SERIE", x_mm: 45, y_mm: 10.8, alto_mm: 1.0}
      - {texto: "ANALÓGICO 1", x_mm: 59, y_mm: 10.8, alto_mm: 1.0}
      - {texto: "ANALÓGICO 2", x_mm: 73, y_mm: 10.8, alto_mm: 1.0}
      - {texto: "3.3 V", x_mm: 17, y_mm: 12.4, alto_mm: 1.0}
      - {texto: "3.3 V", x_mm: 31, y_mm: 12.4, alto_mm: 1.0}
      - {texto: "3.3 V", x_mm: 45, y_mm: 12.4, alto_mm: 1.0}
      - {texto: "3.3 V", x_mm: 59, y_mm: 12.4, alto_mm: 1.0}
      - {texto: "3.3 V", x_mm: 73, y_mm: 12.4, alto_mm: 1.0}
      - {texto: "PANTALLA 3.3 V", x_mm: 14.5, y_mm: 16.0, alto_mm: 1.0}
      - {texto: "Rojo\nIO10", x_mm: 43.2, y_mm: 18.0, alto_mm: 1.0}
      - {texto: "Verde\nIO11", x_mm: 50.2, y_mm: 18.0, alto_mm: 1.0}
      - {texto: "Amarillo\nIO12", x_mm: 57.2, y_mm: 18.0, alto_mm: 1.0}
      - {texto: "RGB", x_mm: 63.6, y_mm: 14.8, alto_mm: 1.0}
      - {texto: "Botón A\nIO16", x_mm: 50, y_mm: 21.6, alto_mm: 1.0}
      - {texto: "Botón B\nIO17", x_mm: 60, y_mm: 21.6, alto_mm: 1.0}
      - {texto: "Perilla\nIO1", x_mm: 78.8, y_mm: 24.9, alto_mm: 1.0}
      - {texto: "Buzzer\nIO18", x_mm: 49.9, y_mm: 37.2, alto_mm: 1.0}
      - {texto: "RESET", x_mm: 34.0, y_mm: 29.5, alto_mm: 1.0}
      - {texto: "BOOT", x_mm: 22.0, y_mm: 25.8, alto_mm: 1.0}
      - {texto: "ON = conectado", x_mm: 68.5, y_mm: 58.8, alto_mm: 1.0}
    pines:
      - {ref: J407, lado: izquierda, dx_mm: 1.9, alto_mm: 1.0}
      - {ref: J408, lado: derecha, dx_mm: 2.2, alto_mm: 1.0}
    dip:
      ref: SW303
      alto_mm: 1.0
      dy_mm: 3.0
      nombres: {LED_R: LEDr, LED_G: LEDv, LED_Y: LEDa, RGB_R: RGBr, RGB_G: RGBv, RGB_B: RGBa, BTN_A: BtnA, BTN_B: BtnB, BZ_IN: Buzz}
  abajo:
    textos:
      - {texto: "Hardware abierto\nCERN-OHL-S-2.0", x_mm: 45, y_mm: 22, alto_mm: 1.2}
      - {texto: "Compatible con el IDE de Arduino\n(placa: ESP32S3 Dev Module)", x_mm: 45, y_mm: 30, alto_mm: 1.2}
      - {texto: "Enlace por Ayemi · v0.1", x_mm: 45, y_mm: 38, alto_mm: 1.2}
    qr: {svg: spec/logos/qr.svg, x_mm: 15.5, y_mm: 25.0, lado_mm: 14}
    conectores:
      refs: [J401, J402, J403, J404, J405]
      y_mm: 4.5
      alto_mm: 1.0

diagrama_pines:
  headers: {J407: izquierda, J408: derecha, J406: abajo}
  conectores: [J401, J402, J403, J404, J405]
  nombres_conectores: {J401: "I2C 1", J402: "I2C 2", J403: "SERIE", J404: "ANALÓGICO 1", J405: "ANALÓGICO 2"}
  alias: {IO8: "IO8 SDA", IO9: "IO9 SCL", IO44: "IO44 RX", IO43: "IO43 TX"}
  dip: {ref: SW303, nombres: {LED_R: "1 LED rojo", LED_G: "2 LED verde", LED_Y: "3 LED amarillo", RGB_R: "4 RGB rojo", RGB_G: "5 RGB verde", RGB_B: "6 RGB azul", BTN_A: "7 Botón A", BTN_B: "8 Botón B", BZ_IN: "9 Zumbador"}}
  perifericos:
    - {ref: D301, texto: "LED rojo · IO10"}
    - {ref: D302, texto: "LED verde · IO11", dy_mm: 4}
    - {ref: D303, texto: "LED amarillo · IO12"}
    - {ref: D304, texto: "RGB · IO13 IO14 IO15"}
    - {ref: SW301, texto: "Botón A · IO16"}
    - {ref: SW302, texto: "Botón B · IO17"}
    - {ref: BZ301, texto: "Zumbador · IO18"}

fab:
  carpeta: fab/v0.1
  existencias_aceptadas: {}
  capas_gerber: [F.Cu, B.Cu, F.Paste, F.Silkscreen, B.Silkscreen, F.Mask, B.Mask, Edge.Cuts]
rotacion_jlc: {}

modelos_3d:
  carpeta: lib/ayemi.3dshapes
  piezas:
    - huella: "Connector_USB:USB_C_Receptacle_HRO_TYPE-C-31-M-12"
      archivo: usb_c_hro_type_c_31_m_12
      forma: caja
      centro_mm: [0, 0]
      ancho_mm: 8.94
      fondo_mm: 7.30
      alto_mm: 3.26
      color: [0.72, 0.72, 0.75]
      fuente: "J101. 8.94 x 7.3 mm: listado del TYPE-C-31-M-12 en un distribuidor; alto 3.26 mm (+-0.15): medición publicada del mismo conector."
    - huella: "Connector_JST:JST_PH_S4B-PH-SM4-TB_1x04-1MP_P2.00mm_Horizontal"
      archivo: jst_ph_s4b_ph_sm4_tb
      forma: caja
      centro_mm: [0, 0.6]
      ancho_mm: 12.0
      fondo_mm: 7.7
      alto_mm: 5.51
      color: [0.92, 0.90, 0.82]
      fuente: "J401 a J405. Ancho y fondo: contorno de fabricación de la huella (12.0 x 7.7 mm); alto: 5.51 mm de altura del aislante según el listado de DigiKey."
    - huella: "Buzzer_Beeper:MagneticBuzzer_CUI_CMT-8504-100-SMT"
      archivo: zumbador_8_5mm
      forma: cilindro
      centro_mm: [0, 0]
      diametro_mm: 8.5
      alto_mm: 3.0
      color: [0.08, 0.08, 0.08]
      fuente: "BZ301. Diámetro de la huella (8.5 mm). Alto de 3.0 mm ESTIMADO por el número de parte del Fengming YS-SBZ8530C05R30 (8530 = 8.5 x 3.0 mm)."
    - huella: "Potentiometer_THT:Potentiometer_Alps_RK09K_Single_Vertical"
      archivo: potenciometro_rk09k_cuerpo
      forma: caja
      centro_mm: [7.0, 2.5]
      ancho_mm: 12.1
      fondo_mm: 9.9
      alto_mm: 6.5
      color: [0.45, 0.47, 0.52]
      fuente: "RV301. Contorno de fabricación de la huella Alps RK09K (12.1 x 9.9 mm); alto 6.5 mm del cuerpo según la hoja de la familia RK09K. Sin eje ni perilla."
    - huella: "LED_SMD:LED_Avago_PLCC4_3.2x2.8mm_CW"
      archivo: led_rgb_3228
      forma: caja
      centro_mm: [0, 0]
      ancho_mm: 3.2
      fondo_mm: 2.7
      alto_mm: 1.9
      color: [0.95, 0.95, 0.92]
      fuente: "D304. 3.2 x 2.7 mm: encapsulado del listado de JLCPCB para el SZYY1209RGB-B. Alto de 1.9 mm ESTIMADO (hoja sin leer)."
    - huella: "LED_SMD:LED_1206_3216Metric"
      archivo: fototransistor_temt6000
      forma: caja
      centro_mm: [0, 0]
      ancho_mm: 4.0
      fondo_mm: 2.0
      alto_mm: 1.05
      color: [0.12, 0.12, 0.14]
      fuente: "Q302. 4 x 2 x 1.05 mm: hoja de datos del Vishay TEMT6000X01."
    - huella: "ayemi:SHT4x_ayemi"
      archivo: sht40_dfn4
      forma: caja
      centro_mm: [0, 0]
      ancho_mm: 1.5
      fondo_mm: 1.5
      alto_mm: 0.5
      color: [0.15, 0.15, 0.17]
      fuente: "U301. 1.5 x 1.5 mm del encapsulado DFN-4 del SHT40; alto de 0.5 mm ESTIMADO (hoja sin leer)."
