ayemi-dev/pcb-ayemi/placas/impulso-stm32/spec/pcb.yaml

#  Impulso por Ayemi (STM32F411) · spec de la placa
#  Fuente de verdad para tools/pcb_setup.py, colocar.py, rutear.py, costura.py, serigrafia.py y fab.py.
#  Misma cadena y mismas reglas que Chispa (placas/entrenamiento-328p/spec/pcb.yaml).
# =============================================================================

placa:
  nombre: "Impulso por Ayemi"
  version: "0.1"
  ancho_mm: 100
  alto_mm: 70
  radio_esquinas_mm: 3
  capas: 2
  grosor_mm: 1.6
  mascara: negra
  serigrafia: blanca
  piezas_solo_arriba: true
  origen_mm: [100, 80]

barrenos:
  tipo: M3
  separacion_borde_mm: 4
  huella: "MountingHole:MountingHole_3.2mm_M3"
  posiciones: [[4, 4], [96, 4], [4, 66], [96, 66]]
  exclusion_mm: 6.4

reglas:
  pista_minima_mm: 0.15
  separacion_minima_mm: 0.1
  via_diametro_mm: 0.5      # JLCPCB acepta vías desde 0.35 mm (taladro 0.2 + 0.15); 0.5 / 0.3 deja pasar un carril de 0.15 mm entre vías de patas vecinas del QFN
  via_taladro_mm: 0.3
  anillo_minimo_mm: 0.1
  cobre_a_borde_mm: 0.3
  taladro_minimo_mm: 0.3
  taladro_a_cobre_mm: 0.15     # JLCPCB no pide más; el ruteador deja 0.15 mm entre cobre y cobre
  serigrafia_alto_min_mm: 1.0
  serigrafia_trazo_min_mm: 0.15

clases_de_red:
  Default:  {pista_mm: 0.25, separacion_mm: 0.15, separacion_drc_mm: 0.1}   # el ruteador deja 0.15 mm; el DRC exige el mínimo de JLCPCB (0.1 mm) por el error de rejilla
  Potencia: {pista_mm: 0.5,  separacion_mm: 0.2, separacion_drc_mm: 0.1, redes: ["+5V", VBUS, GND]}
  USB:      {pista_mm: 0.3,  separacion_mm: 0.2, separacion_drc_mm: 0.1, redes: [USB_DP, USB_DM]}

planos:
  - {red: GND, capas: [F.Cu, B.Cu], margen_borde_mm: 0.5, separacion_mm: 0.3}

costura_gnd:
  rejilla_mm: 5
  borde_paso_mm: 3
  borde_margen_mm: 1.5

ruteo:
  resolucion_mm: 0.1
  pasadas: 14
  limite_nodos: 300000
  ripup_local: true
  abanico: [U1, {ref: SW303, mm: 0.5, filas: 1}]           # QFN-48 de 0.5 mm: de cada pata sale un tramo recto antes de rutear
  abanico_mm: 0.65
  abanico_via: true
  abanico_filas: 3          # vías del QFN en tres filas (0.65, 1.3 y 1.95 mm)
  abanico_clase: Fino
  abanico_excluir: [GND]
  holgura_mm: 0.0          # sin margen extra de rejilla: los carriles de 0.5 mm del QFN no caben con 0.07 mm
  sin_vias: [XT1, XT2]    # las pistas del cristal van en la cara superior y sin vías
  refinar_s: 300
  mejora_s: 0
  fino: {pista_mm: 0.15, separacion_mm: 0.15}
  ventanas:
    - {nombre: "USB-C", x_mm: [7, 47.5], y_mm: [31, 69], resolucion_mm: 0.05, ancho_mm: 0.2, ancho_medio_mm: 0.4, redes: [CC1, CC2, USB_DM, USB_DP, VBUS], redes_medias: [VBUS], gnd_pads: [U102.2]}

areas_prohibidas:
  - nombre: CRISTAL
    descripcion: "Debajo del cristal y sus capacitores: solo GND y las dos redes del cristal"
    refs: [Y1, C1, C2]
    margen_mm: 0.3
    redes_permitidas: [GND, XT1, XT2]

  # Las cinco zonas de exclusión de cobre de la huella oficial de la ranura microSD (Hirose DM3AT), trasladadas a la
  # placa con J411 en (13.9, 28.0) y giro de 270 grados. El ruteador no lee las zonas de las huellas: se repiten aquí
  # como rectángulos para que no pase ninguna pista; el DRC sigue comprobando las zonas originales.
  - {nombre: SD_ZONA_1, descripcion: "Exclusión de la huella DM3AT", rect_mm: [17.925, 20.775, 21.175, 21.525], margen_mm: 0.0, redes_permitidas: [], bloquea_cobre: true, capas: [F.Cu]}
  - {nombre: SD_ZONA_2, descripcion: "Exclusión de la huella DM3AT", rect_mm: [13.125, 20.775, 16.725, 21.525], margen_mm: 0.0, redes_permitidas: [], bloquea_cobre: true, capas: [F.Cu]}
  - {nombre: SD_ZONA_3, descripcion: "Exclusión de la huella DM3AT", rect_mm: [7.725, 21.875, 15.325, 22.575], margen_mm: 0.0, redes_permitidas: [], bloquea_cobre: true, capas: [F.Cu]}
  - {nombre: SD_ZONA_4, descripcion: "Exclusión de la huella DM3AT", rect_mm: [5.575, 30.925, 6.925, 33.475], margen_mm: 0.0, redes_permitidas: [], bloquea_cobre: true, capas: [F.Cu]}
  - {nombre: SD_ZONA_5, descripcion: "Exclusión de la huella DM3AT", rect_mm: [15.025, 22.575, 16.625, 31.275], margen_mm: 0.0, redes_permitidas: [], bloquea_cobre: true, capas: [F.Cu]}

zonas:
  usb:        {borde: inferior, nota: "USB-C con la boca hacia afuera"}
  sd:         {borde: izquierdo, nota: "Ranura microSD con la boca hacia el borde izquierdo"}
  conectores: {borde: superior, nota: "Los 5 conectores de 4 pines en el borde superior, boca hacia afuera, paso de 14 mm"}
  manos:      {x_mm: [44, 84], y_mm: [10, 56], nota: "Botones, potenciómetro, buzzer y DIP"}

fijos:
  H1:   {x_mm: 4,    y_mm: 4,     rot: 0}
  H2:   {x_mm: 96,   y_mm: 4,     rot: 0}
  H3:   {x_mm: 4,    y_mm: 66,    rot: 0}
  H4:   {x_mm: 96,   y_mm: 66,    rot: 0}
  J401: {x_mm: 17,   y_mm: 5.0,   rot: 180}
  J402: {x_mm: 31,   y_mm: 5.0,   rot: 180}
  J403: {x_mm: 45,   y_mm: 5.0,   rot: 180}
  J404: {x_mm: 59,   y_mm: 5.0,   rot: 180}
  J405: {x_mm: 73,   y_mm: 5.0,   rot: 180}
  J407: {x_mm: 97,   y_mm: 10, rot: 0}     # IO A (10 pines) en el borde derecho
  J1:   {x_mm: 97,   y_mm: 38,  rot: 0}     # SWD (5 pines) en el borde derecho, debajo de IO A
  J101: {x_mm: 16,   y_mm: 66.3,  rot: 0}
  J409: {x_mm: 23.5, y_mm: 66.5,  rot: 90}    # SPI en fila horizontal en el borde inferior
  J408: {x_mm: 40.1, y_mm: 66.5,  rot: 90}    # IO B en fila horizontal en el borde inferior
  J411: {x_mm: 13.9, y_mm: 28.0,  rot: 270}   # microSD con la boca en el borde izquierdo
  U1:   {x_mm: 50.05, y_mm: 38.05, rot: 180}   # patas de SD y USB hacia la izquierda, cristal hacia la derecha

aprox:
  # --- micro: cristal, desacoplo, BOOT0 y RESET ---
  Y1:   {x_mm: 62.5, y_mm: 39.5, rot: 0}
  C1:   {x_mm: 60.6, y_mm: 45.5, rot: 0}
  C2:   {x_mm: 64.4, y_mm: 45.5, rot: 0}
  C3:   {x_mm: 45.5, y_mm: 31.6, rot: 0}
  C4:   {x_mm: 43.5, y_mm: 42.6, rot: 0}
  C5:   {x_mm: 56.3, y_mm: 42.8, rot: 0}
  C6:   {x_mm: 59.0, y_mm: 35.0, rot: 0}
  C7:   {x_mm: 59.0, y_mm: 37.6, rot: 0}
  C8:   {x_mm: 50.1, y_mm: 30.0, rot: 0}
  C9:   {x_mm: 55.5, y_mm: 29.0, rot: 0}
  C10:  {x_mm: 50.0, y_mm: 47.2, rot: 90}
  R1:   {x_mm: 54.5, y_mm: 48.3, rot: 0}
  R2:   {x_mm: 43, y_mm: 29.5, rot: 0}
  R3:   {x_mm: 41.3, y_mm: 38.0, rot: 0}
  R4:   {x_mm: 40.5, y_mm: 29.5, rot: 0}
  SW1:  {x_mm: 46.0, y_mm: 53.5, rot: 0}
  SW2:  {x_mm: 59.5, y_mm: 52.0, rot: 0}
  # --- microSD ---
  R403: {x_mm: 24.3, y_mm: 21.5, rot: 90}
  R404: {x_mm: 24.3, y_mm: 24.0, rot: 90}
  R405: {x_mm: 24.3, y_mm: 26.5, rot: 90}
  R406: {x_mm: 24.3, y_mm: 29.0, rot: 90}
  R407: {x_mm: 24.3, y_mm: 31.5, rot: 90}
  C401: {x_mm: 27.5, y_mm: 21.5, rot: 90}
  C402: {x_mm: 27.5, y_mm: 24.5, rot: 90}
  # --- IMU ---
  U301: {x_mm: 31.5, y_mm: 28.0, rot: 0}
  C301: {x_mm: 31.5, y_mm: 30.8, rot: 0}
  C302: {x_mm: 35.0, y_mm: 26.0, rot: 0}
  R323: {x_mm: 28.5, y_mm: 30.8, rot: 0}
  # --- USB y alimentación ---
  U102: {x_mm: 16.0, y_mm: 57.5, rot: 0}
  R101: {x_mm: 10.5, y_mm: 57.0, rot: 90}
  R102: {x_mm: 21.5, y_mm: 57.0, rot: 90}
  F201: {x_mm: 9.5,  y_mm: 40.5, rot: 0}
  C201: {x_mm: 13.5, y_mm: 50.5, rot: 0}
  C202: {x_mm: 9.5,  y_mm: 44.0, rot: 0}
  U201: {x_mm: 29.0, y_mm: 51.5, rot: 0}
  C203: {x_mm: 25.0, y_mm: 57.5, rot: 0}
  R201: {x_mm: 13.5, y_mm: 54, rot: 0}
  D201: {x_mm: 17.5, y_mm: 54, rot: 0}
  # --- conectores ---
  J406: {x_mm: 29.0, y_mm: 17.0, rot: 90}
  R401: {x_mm: 24.0, y_mm: 12.8, rot: 0}
  R402: {x_mm: 27.5, y_mm: 12.8, rot: 0}
  # --- LEDs, RGB y sensores ---
  D301: {x_mm: 41.5, y_mm: 14.5, rot: 0}
  R301: {x_mm: 44.8, y_mm: 14.5, rot: 0}
  D302: {x_mm: 48.5, y_mm: 14.5, rot: 0}
  R302: {x_mm: 51.8, y_mm: 14.5, rot: 0}
  D303: {x_mm: 55.5, y_mm: 14.5, rot: 0}
  R303: {x_mm: 58.8, y_mm: 14.5, rot: 0}
  D304: {x_mm: 69.5, y_mm: 14.8, rot: 0}
  R304: {x_mm: 65.0, y_mm: 18.4, rot: 0}
  R305: {x_mm: 69.5, y_mm: 18.4, rot: 0}
  R306: {x_mm: 74.0, y_mm: 18.4, rot: 0}
  Q303: {x_mm: 65.0, y_mm: 22.0, rot: 0}
  Q304: {x_mm: 69.5, y_mm: 22.0, rot: 0}
  Q305: {x_mm: 74.0, y_mm: 22.0, rot: 0}
  R320: {x_mm: 65, y_mm: 25.4, rot: 0}
  R321: {x_mm: 69.5, y_mm: 25.4, rot: 0}
  R322: {x_mm: 74, y_mm: 25.4, rot: 0}
  Q302: {x_mm: 81.2, y_mm: 6.3,  rot: 90}
  R312: {x_mm: 91.2, y_mm: 10.6, rot: 90}
  # --- zona de manos ---
  SW301: {x_mm: 62.3, y_mm: 48, rot: 0}
  SW302: {x_mm: 71.8, y_mm: 48, rot: 0}
  R307:  {x_mm: 62.3, y_mm: 52.4, rot: 0}
  R308:  {x_mm: 71.8, y_mm: 52.4, rot: 0}
  RV301: {x_mm: 80.5, y_mm: 58, rot: 0}
  R313:  {x_mm: 78.3, y_mm: 52, rot: 90}
  BZ301: {x_mm: 66.5, y_mm: 60, rot: 0}
  D305:  {x_mm: 60, y_mm: 56.5, rot: 0}
  R316:  {x_mm: 83.0, y_mm: 49.9, rot: 0}
  R315:  {x_mm: 86.5, y_mm: 49.9, rot: 0}
  R314:  {x_mm: 90.0, y_mm: 49.9, rot: 0}
  R311:  {x_mm: 93.5, y_mm: 49.9, rot: 0}
  Q301:  {x_mm: 95.0, y_mm: 54.5, rot: 0}
  R309:  {x_mm: 90.5, y_mm: 52.3, rot: 0}
  R310:  {x_mm: 87.2, y_mm: 52.3, rot: 0}
  SW303: {x_mm: 76.5, y_mm: 33.0, rot: 90}

cerca_de:
  C3:   {pin: "U1.24", max_mm: 6}
  C4:   {pin: "U1.36", max_mm: 6}
  C5:   {pin: "U1.48", max_mm: 6}
  C8:   {pin: "U1.22", max_mm: 8}
  C1:   {pin: "U1.5",  max_mm: 14}
  C2:   {pin: "U1.6",  max_mm: 14}
  U102: {pin: "J101.A6", max_mm: 10}
grupos: []

serigrafia:
  referencias_ocultas: true
  trazo_mm: 0.15
  alias_redes: {PB6: "PB6 SCL", PB7: "PB7 SDA", PA2: "PA2 TX", PA3: "PA3 RX", SD_MOSI: "MOSI", SD_MISO: "MISO", SD_SCK: "SCK", SD_CS: "CS"}
  arriba:
    logotipo: {svg: spec/logos/ayemi-logotipo.svg, x_mm: 11.8, y_mm: 13.8, ancho_mm: 9.5}
    # Emi de una tinta, versión de cabeza (el cuerpo completo no cabe en la cara superior).
    emi: {svg: spec/logos/emi-serigrafia-cabeza.svg, x_mm: 7.5, y_mm: 16.2, alto_mm: 7.0}
    textos:
      - {texto: "Impulso por\nAyemi · v0.1", x_mm: 16.8, y_mm: 18.9, alto_mm: 1.0}
      - {texto: "I2C 1", x_mm: 17, y_mm: 10.8, alto_mm: 1.0}
      - {texto: "I2C 2", x_mm: 31, y_mm: 10.8, alto_mm: 1.0}
      - {texto: "SERIE", x_mm: 45, y_mm: 10.8, alto_mm: 1.0}
      - {texto: "ANALÓGICO 1", x_mm: 59, y_mm: 10.8, alto_mm: 1.0}
      - {texto: "ANALÓGICO 2", x_mm: 73, y_mm: 10.8, alto_mm: 1.0}
      - {texto: "3.3 V", x_mm: 17, y_mm: 12.4, alto_mm: 1.0}
      - {texto: "3.3 V", x_mm: 31, y_mm: 12.4, alto_mm: 1.0}
      - {texto: "3.3 V", x_mm: 45, y_mm: 12.4, alto_mm: 1.0}
      - {texto: "3.3 V", x_mm: 59, y_mm: 12.4, alto_mm: 1.0}
      - {texto: "3.3 V", x_mm: 73, y_mm: 12.4, alto_mm: 1.0}
      - {texto: "PANTALLA 3.3 V", x_mm: 35.5, y_mm: 20.2, alto_mm: 1.0}
      - {texto: "Rojo\nPB0", x_mm: 43.2, y_mm: 18.0, alto_mm: 1.0}
      - {texto: "Verde\nPB1", x_mm: 50.2, y_mm: 18.0, alto_mm: 1.0}
      - {texto: "Amarillo\nPB10", x_mm: 57.2, y_mm: 18.0, alto_mm: 1.0}
      - {texto: "RGB", x_mm: 63.6, y_mm: 14.8, alto_mm: 1.0}
      - {texto: "Botón A PC14", x_mm: 67.05, y_mm: 48.0, alto_mm: 1.0, rot: 90}
      - {texto: "Botón B\nPC15", x_mm: 78.0, y_mm: 48.0, alto_mm: 1.0, rot: 90}
      - {texto: "Perilla\nPA0", x_mm: 75.0, y_mm: 57.5, alto_mm: 1.0}
      - {texto: "Buzzer\nPA15", x_mm: 66.5, y_mm: 66.3, alto_mm: 1.0}
      - {texto: "RESET", x_mm: 46.0, y_mm: 58.4, alto_mm: 1.0}
      - {texto: "BOOT0", x_mm: 56.9, y_mm: 50.9, alto_mm: 1.0}
      - {texto: "ON = conectado", x_mm: 76.5, y_mm: 43.0, alto_mm: 1.0}
      # Rótulos de los dos headers del borde inferior: alternados arriba y abajo de la fila de pines
      - {texto: "MOSI", x_mm: 23.5, y_mm: 64.0, alto_mm: 1.0}
      - {texto: "MISO", x_mm: 26.04, y_mm: 68.7, alto_mm: 1.0}
      - {texto: "SCK", x_mm: 28.58, y_mm: 64.0, alto_mm: 1.0}
      - {texto: "CS", x_mm: 31.12, y_mm: 68.7, alto_mm: 1.0}
      - {texto: "3.3 V", x_mm: 33.66, y_mm: 64.0, alto_mm: 1.0}
      - {texto: "GND", x_mm: 36.2, y_mm: 68.7, alto_mm: 1.0}
      - {texto: "PB3", x_mm: 40.1, y_mm: 64.0, alto_mm: 1.0}
      - {texto: "PB4", x_mm: 42.64, y_mm: 68.7, alto_mm: 1.0}
      - {texto: "3.3 V", x_mm: 45.18, y_mm: 64.0, alto_mm: 1.0}
      - {texto: "5 V", x_mm: 47.72, y_mm: 68.7, alto_mm: 1.0}
      - {texto: "GND", x_mm: 50.26, y_mm: 64.0, alto_mm: 1.0}
      - {texto: "RESET", x_mm: 52.8, y_mm: 68.7, alto_mm: 1.0}
      - {texto: "SWD", x_mm: 97.0, y_mm: 35.4, alto_mm: 1.0}
    pines:
      - {ref: J407, lado: izquierda, dx_mm: 1.9, alto_mm: 1.0}
      - {ref: J1, lado: izquierda, dx_mm: 1.9, alto_mm: 1.0}
    dip:
      ref: SW303
      lado: abajo     # bajo la fila de abajo (la de arriba tiene resistencias del RGB), con los nombres de las redes de señal
      alto_mm: 1.0
      dy_mm: 3.0
      nombres: {PB0: LEDr, PB1: LEDv, PB10: LEDa, PB5: RGBr, PB8: RGBv, PB9: RGBa, PC14: BtnA, PC15: BtnB, PA15: Buzz}
  abajo:
    textos:
      - {texto: "Hardware abierto\nCERN-OHL-S-2.0", x_mm: 45, y_mm: 22, alto_mm: 1.2}
      - {texto: "Compatible con STM32duino\n(placa: BLACKPILL_F411CE)", x_mm: 45, y_mm: 30, alto_mm: 1.2}
      - {texto: "Impulso por Ayemi · v0.1", x_mm: 45, y_mm: 38, alto_mm: 1.2}
    qr: {svg: spec/logos/qr.svg, x_mm: 15.5, y_mm: 25.0, lado_mm: 14}
    conectores:
      refs: [J401, J402, J403, J404, J405]
      y_mm: 4.5
      alto_mm: 1.0

diagrama_pines:
  headers: {J407: izquierda, J1: izquierda, J406: abajo, J408: abajo, J409: abajo}
  conectores: [J401, J402, J403, J404, J405]
  nombres_conectores: {J401: "I2C 1", J402: "I2C 2", J403: "SERIE", J404: "ANALÓGICO 1", J405: "ANALÓGICO 2"}
  alias: {PB6: "PB6 SCL", PB7: "PB7 SDA", PA2: "PA2 TX", PA3: "PA3 RX"}
  dip: {ref: SW303, nombres: {LED_R: "1 LED rojo", LED_G: "2 LED verde", LED_Y: "3 LED amarillo", RGB_R: "4 RGB rojo", RGB_G: "5 RGB verde", RGB_B: "6 RGB azul", BTN_A: "7 Botón A", BTN_B: "8 Botón B", BZ_IN: "9 Zumbador"}}
  perifericos:
    - {ref: D301, texto: "LED rojo · PB0"}
    - {ref: D302, texto: "LED verde · PB1", dy_mm: 4}
    - {ref: D303, texto: "LED amarillo · PB10"}
    - {ref: D304, texto: "RGB · PB5 PB8 PB9"}
    - {ref: SW301, texto: "Botón A · PC14"}
    - {ref: SW302, texto: "Botón B · PC15"}
    - {ref: BZ301, texto: "Zumbador · PA15"}

fab:
  carpeta: fab/v0.1
  existencias_aceptadas: {}
  capas_gerber: [F.Cu, B.Cu, F.Paste, F.Silkscreen, B.Silkscreen, F.Mask, B.Mask, Edge.Cuts]
rotacion_jlc: {}

modelos_3d:
  carpeta: lib/ayemi.3dshapes
  piezas:
    - huella: "Connector_USB:USB_C_Receptacle_HRO_TYPE-C-31-M-12"
      archivo: usb_c_hro_type_c_31_m_12
      forma: caja
      centro_mm: [0, 0]
      ancho_mm: 8.94
      fondo_mm: 7.30
      alto_mm: 3.26
      color: [0.72, 0.72, 0.75]
      fuente: "J101. 8.94 x 7.3 mm: listado del TYPE-C-31-M-12 en un distribuidor; alto 3.26 mm (+-0.15): medición publicada del mismo conector."
    - huella: "Connector_JST:JST_PH_S4B-PH-SM4-TB_1x04-1MP_P2.00mm_Horizontal"
      archivo: jst_ph_s4b_ph_sm4_tb
      forma: caja
      centro_mm: [0, 0.6]
      ancho_mm: 12.0
      fondo_mm: 7.7
      alto_mm: 5.51
      color: [0.92, 0.90, 0.82]
      fuente: "J401 a J405. Ancho y fondo: contorno de fabricación de la huella (12.0 x 7.7 mm); alto: 5.51 mm de altura del aislante según el listado de DigiKey."
    - huella: "Buzzer_Beeper:MagneticBuzzer_CUI_CMT-8504-100-SMT"
      archivo: zumbador_8_5mm
      forma: cilindro
      centro_mm: [0, 0]
      diametro_mm: 8.5
      alto_mm: 3.0
      color: [0.08, 0.08, 0.08]
      fuente: "BZ301. Diámetro de la huella (8.5 mm). Alto de 3.0 mm ESTIMADO por el número de parte del Fengming YS-SBZ8530C05R30 (8530 = 8.5 x 3.0 mm)."
    - huella: "Potentiometer_THT:Potentiometer_Alps_RK09K_Single_Vertical"
      archivo: potenciometro_rk09k_cuerpo
      forma: caja
      centro_mm: [7.0, 2.5]
      ancho_mm: 12.1
      fondo_mm: 9.9
      alto_mm: 6.5
      color: [0.45, 0.47, 0.52]
      fuente: "RV301. Contorno de fabricación de la huella Alps RK09K (12.1 x 9.9 mm); alto 6.5 mm del cuerpo según la hoja de la familia RK09K. Sin eje ni perilla."
    - huella: "LED_SMD:LED_Avago_PLCC4_3.2x2.8mm_CW"
      archivo: led_rgb_3228
      forma: caja
      centro_mm: [0, 0]
      ancho_mm: 3.2
      fondo_mm: 2.7
      alto_mm: 1.9
      color: [0.95, 0.95, 0.92]
      fuente: "D304. 3.2 x 2.7 mm: encapsulado del listado de JLCPCB para el SZYY1209RGB-B. Alto de 1.9 mm ESTIMADO (hoja sin leer)."
    - huella: "LED_SMD:LED_1206_3216Metric"
      archivo: fototransistor_temt6000
      forma: caja
      centro_mm: [0, 0]
      ancho_mm: 4.0
      fondo_mm: 2.0
      alto_mm: 1.05
      color: [0.12, 0.12, 0.14]
      fuente: "Q302. 4 x 2 x 1.05 mm: hoja de datos del Vishay TEMT6000X01."
    - huella: "Package_DFN_QFN:QFN-48-1EP_7x7mm_P0.5mm_EP5.6x5.6mm"
      archivo: stm32f411_ufqfpn48
      forma: caja
      centro_mm: [0, 0]
      ancho_mm: 7.0
      fondo_mm: 7.0
      alto_mm: 0.55
      color: [0.10, 0.10, 0.12]
      fuente: "U1. 7 x 7 mm del encapsulado UFQFPN48 (el nombre de la huella oficial); alto de 0.55 mm ESTIMADO (hoja del STM32F411 sin leer en este punto). KiCad no trae modelo para la variante de pad central de 5.6 mm."
